Duet3D/Duet3-Mainboard-6HC/(threads)

Thread 2 (2020-11-08):

microSD card socket rotated 180deg in STEP file

boa-pe, 2020-11-08:
microSD card socket is rotated 180deg

T3P3, 2020-11-08:
Updated in latest commit, replaced the step model for the SD card socket used.

Closed 2020-11-08.

Thread 3 (2021-02-15):

Is there duet3 lib for kicad??

zhjc2014, 2021-02-15:
I can't find the duet3 lib, and many component missed when I open the prj in kicad...
