Duet3D/Duet3-Mainboard-6HC/Duet3_Mainboard_6HC_v1.01/Duet3_MB_Schematic_v1.01.pdf

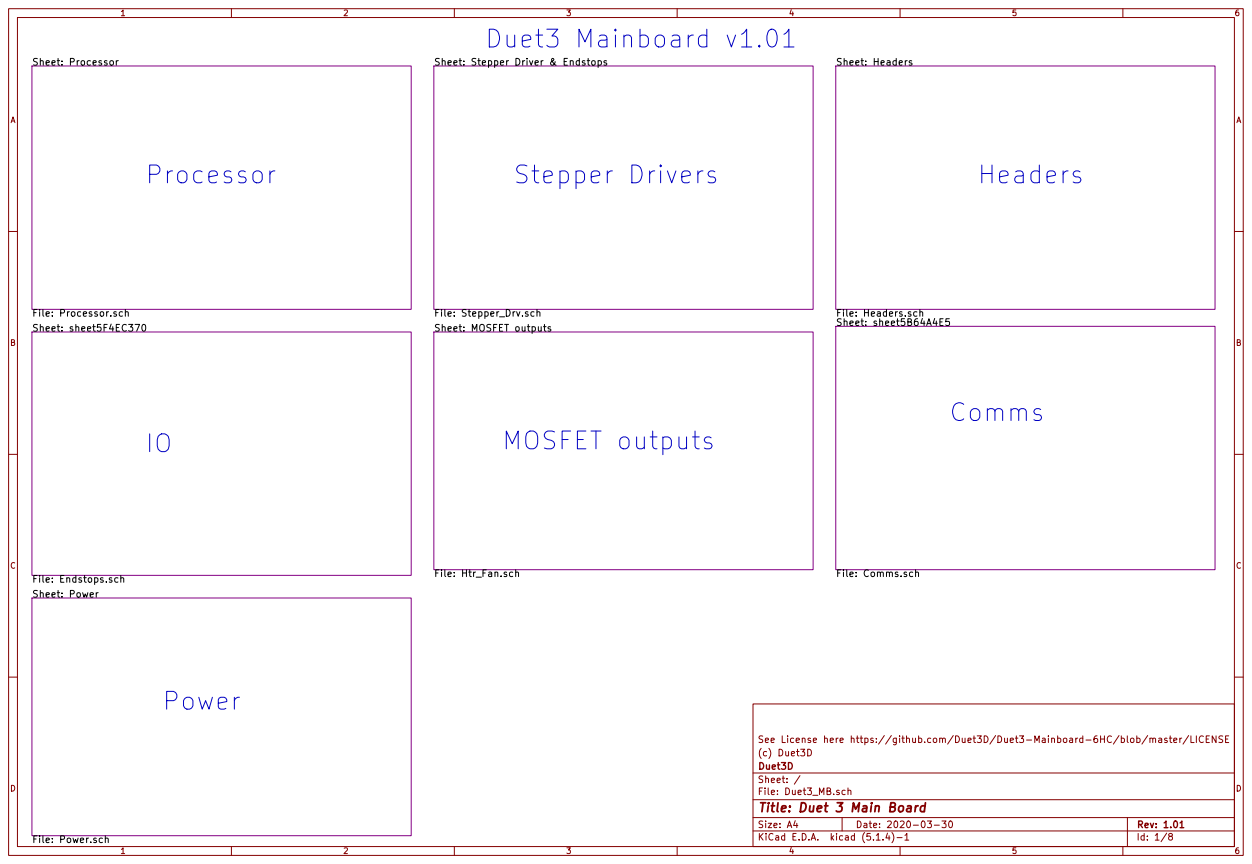
[picture p9: page 1]

Sheet: Headers File: Headers.sch Sheet: Power File: Power.sch

Sheet: Stepper Driver & Endstops

See License here https://github.com/Duet3D/Duet3-Mainboard-6HC/blob/master/LICENSE
(c) Duet3D
File: Duet3_MB.sch Sheet: / Duet3D

Id: 1/8 Title: Duet 3 Main Board

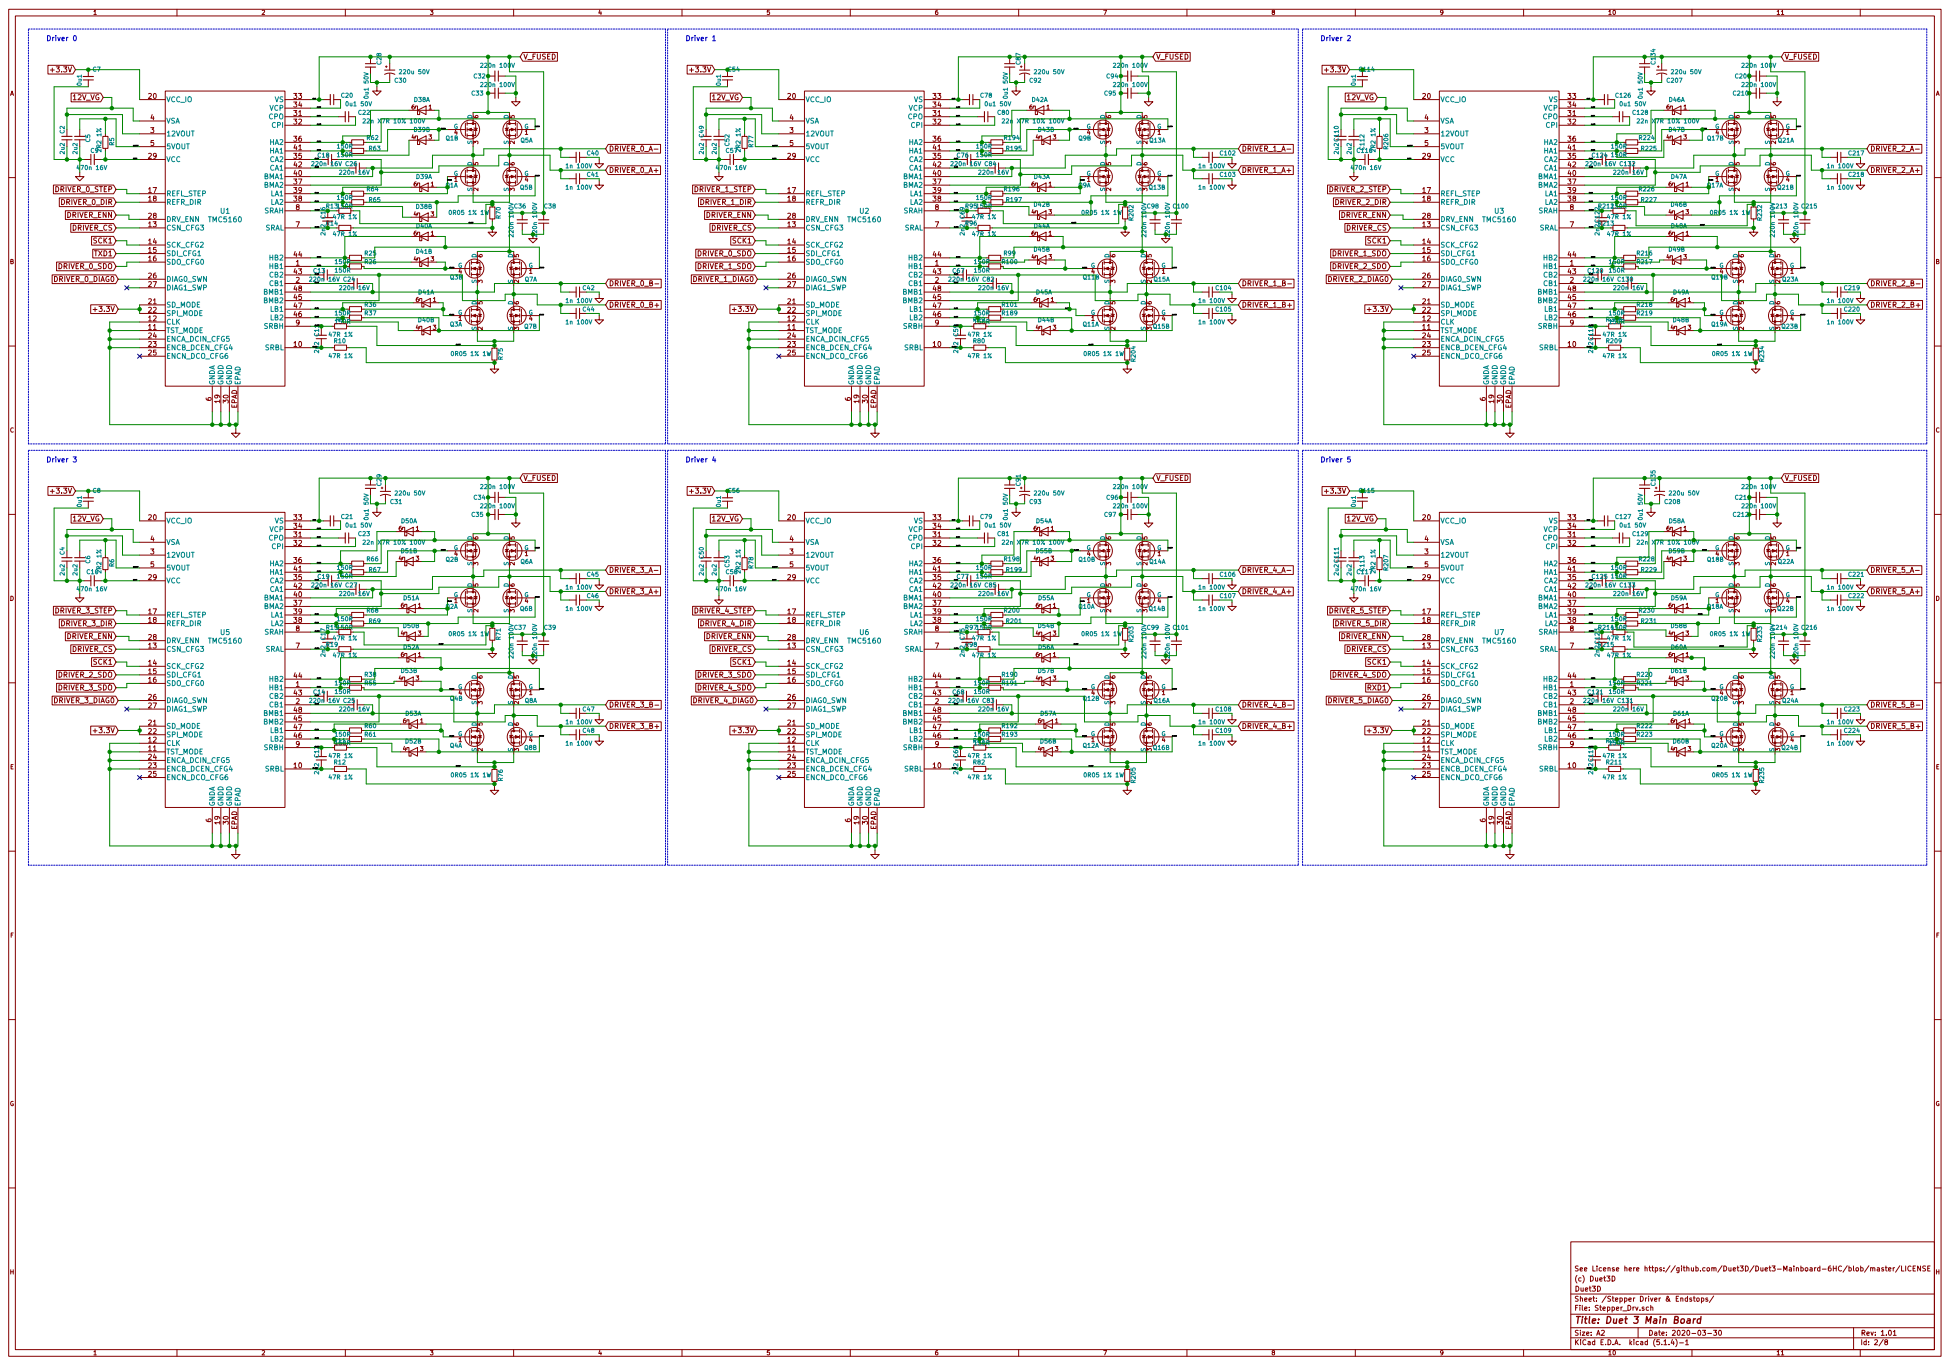
[picture p10: page 2]

6 SRAL 7 SRAH 8 SRBH 9 EPAD EPAD U2 TMC5160 C78

6 SRAL 7 SRAH 8 SRBH 9 EPAD EPAD U1 TMC5160 C5 2u2 C9

5 Q9A HB1 1 SRBL 10 TST_MODE 11 CLK 12 CSN_CFG3 13 SCK_CFG2 14 SDI_CFG1 15 SDO_CFG0 16 REFL_STEP 17 REFR_DIR 18 GNDD 19 CB1 2 VCC_IO 20 SD_MODE 21 SPI_MODE 22 ENCB_DCEN_CFG4 23 ENCA_DCIN_CFG5 24 ENCN_DCO_CFG6 25 DIAG0_SWN 26 DIAG1_SWP 27 DRV_ENN 28 VCC 29

6 SRAL 7 SRAH 8 SRBH 9 EPAD EPAD U6 TMC5160 C53 2u2 C58

6 SRAL 7 SRAH 8 SRBH 9 EPAD EPAD U5 TMC5160

See License here https://github.com/Duet3D/Duet3-Mainboard-6HC/blob/master/LICENSE
(c) Duet3D
Sheet: /Stepper Driver & Endstops/ Duet3D

File: Stepper_Drv.sch
Id: 2/8 Title: Duet 3 Main Board

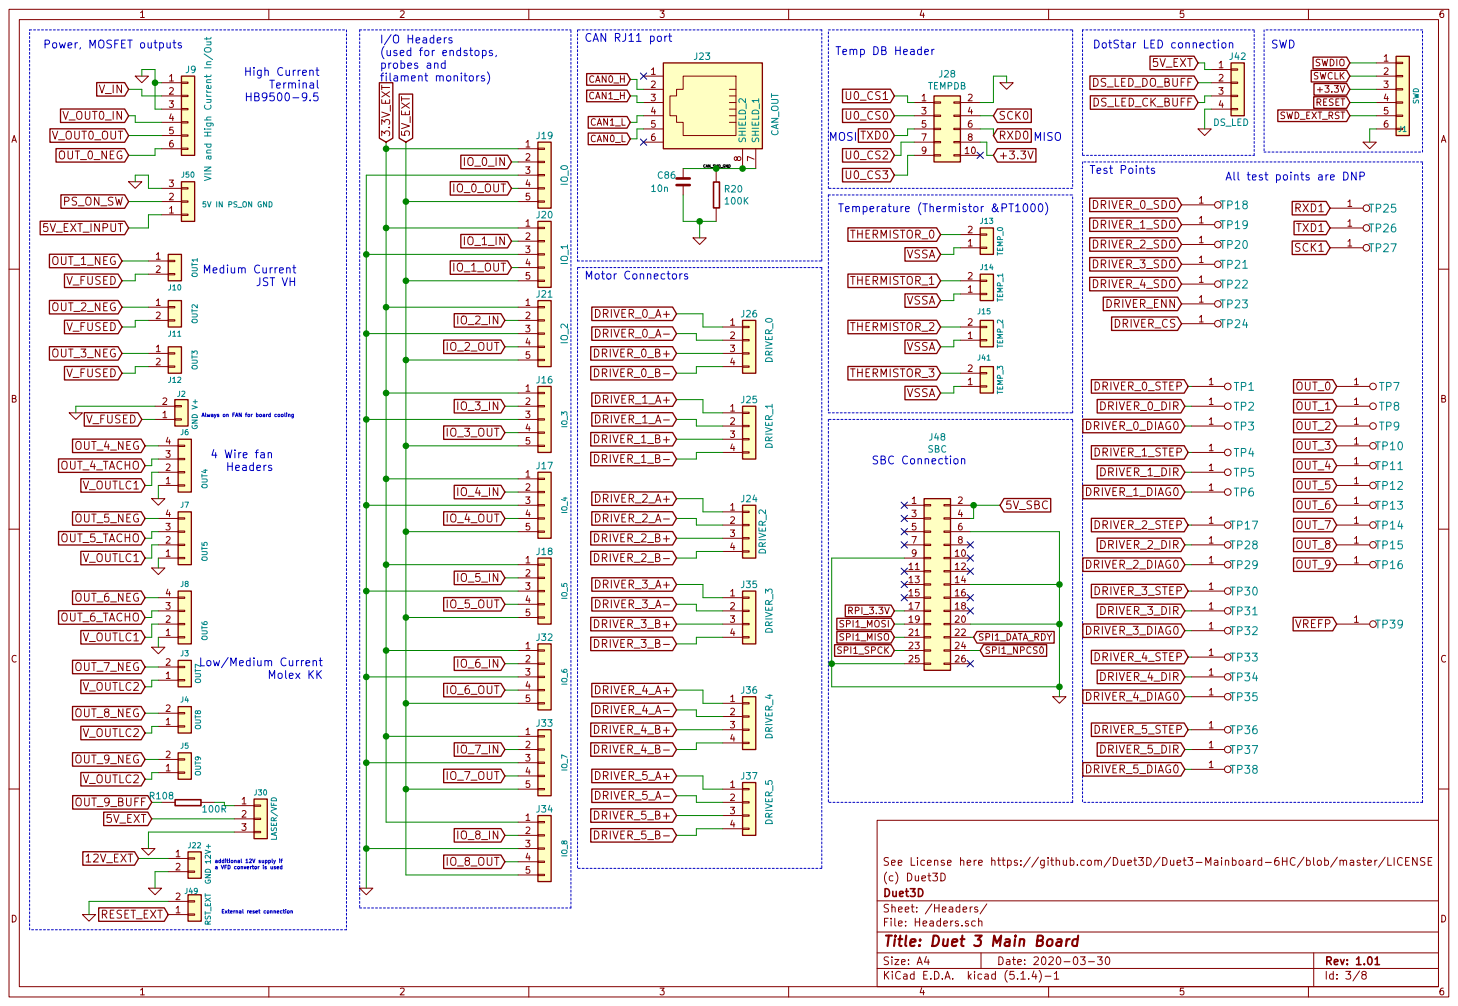
[picture p11: page 3]

Test Points High Current Terminal HB9500-9.5 Power, MOSFET outputs

Temp DB Header 4 Wire fan Headers

Always on FAN for board cooling

additional 12V supply if a VFD convertor is used

See License here https://github.com/Duet3D/Duet3-Mainboard-6HC/blob/master/LICENSE
(c) Duet3D
File: Headers.sch Sheet: /Headers/ Duet3D

Id: 3/8 Title: Duet 3 Main Board

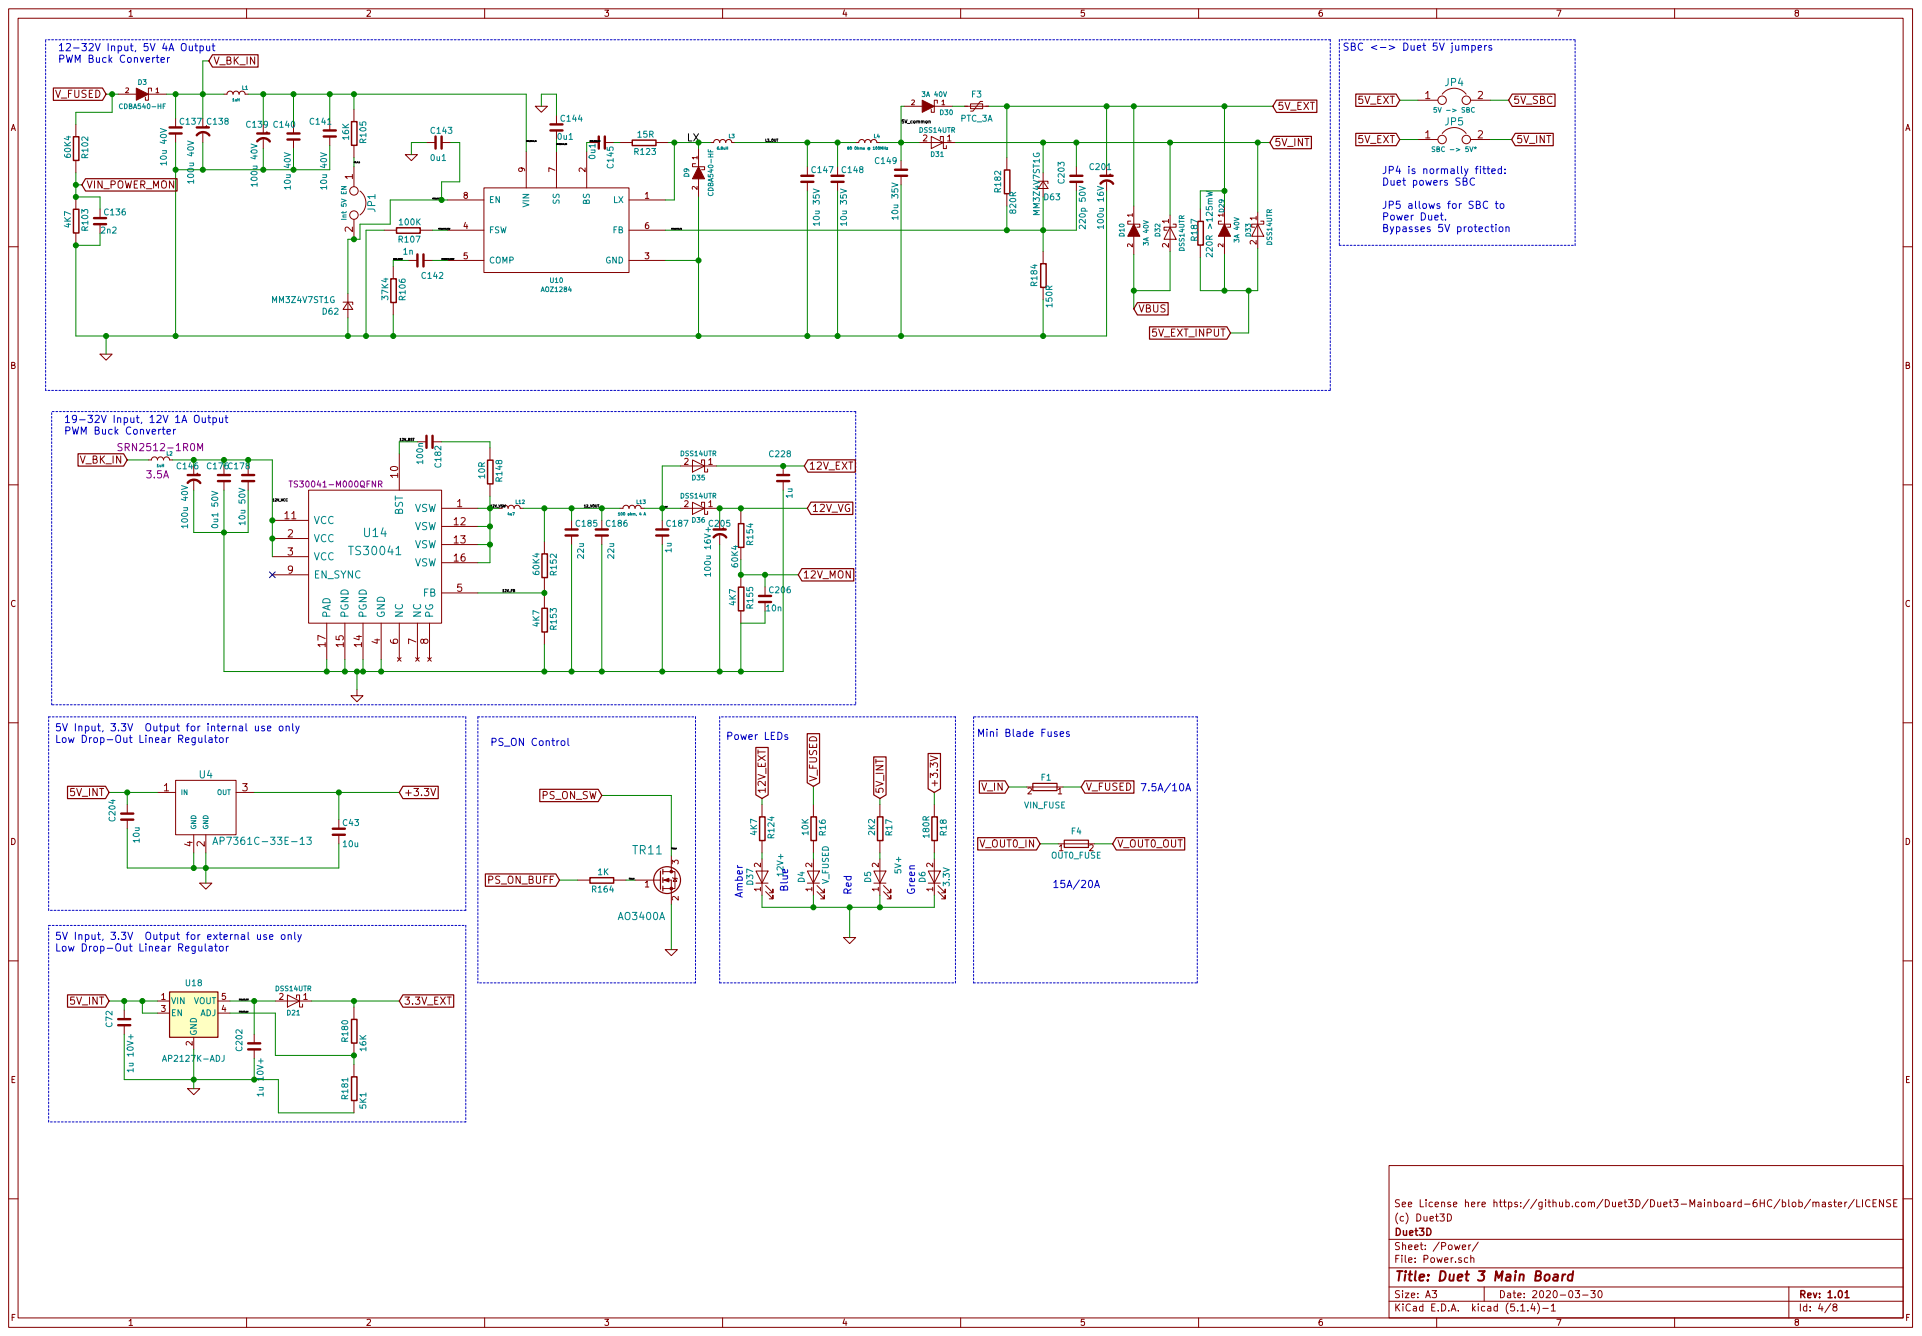
[picture p12: page 4]

2 GND 3 FSW 4 COMP 5 FB 6 SS

JP5 allows for SBC to Power Duet. Bypasses 5V protection

5V Input, 3.3V Output for internal use only

5V Input, 3.3V Output for external use only
Low Drop-Out Linear Regulator

2 EN 3 ADJ 4 VOUT 5 U18 AP2127K-ADJ

See License here https://github.com/Duet3D/Duet3-Mainboard-6HC/blob/master/LICENSE
(c) Duet3D
File: Power.sch Sheet: /Power/ Duet3D

Id: 4/8 Title: Duet 3 Main Board

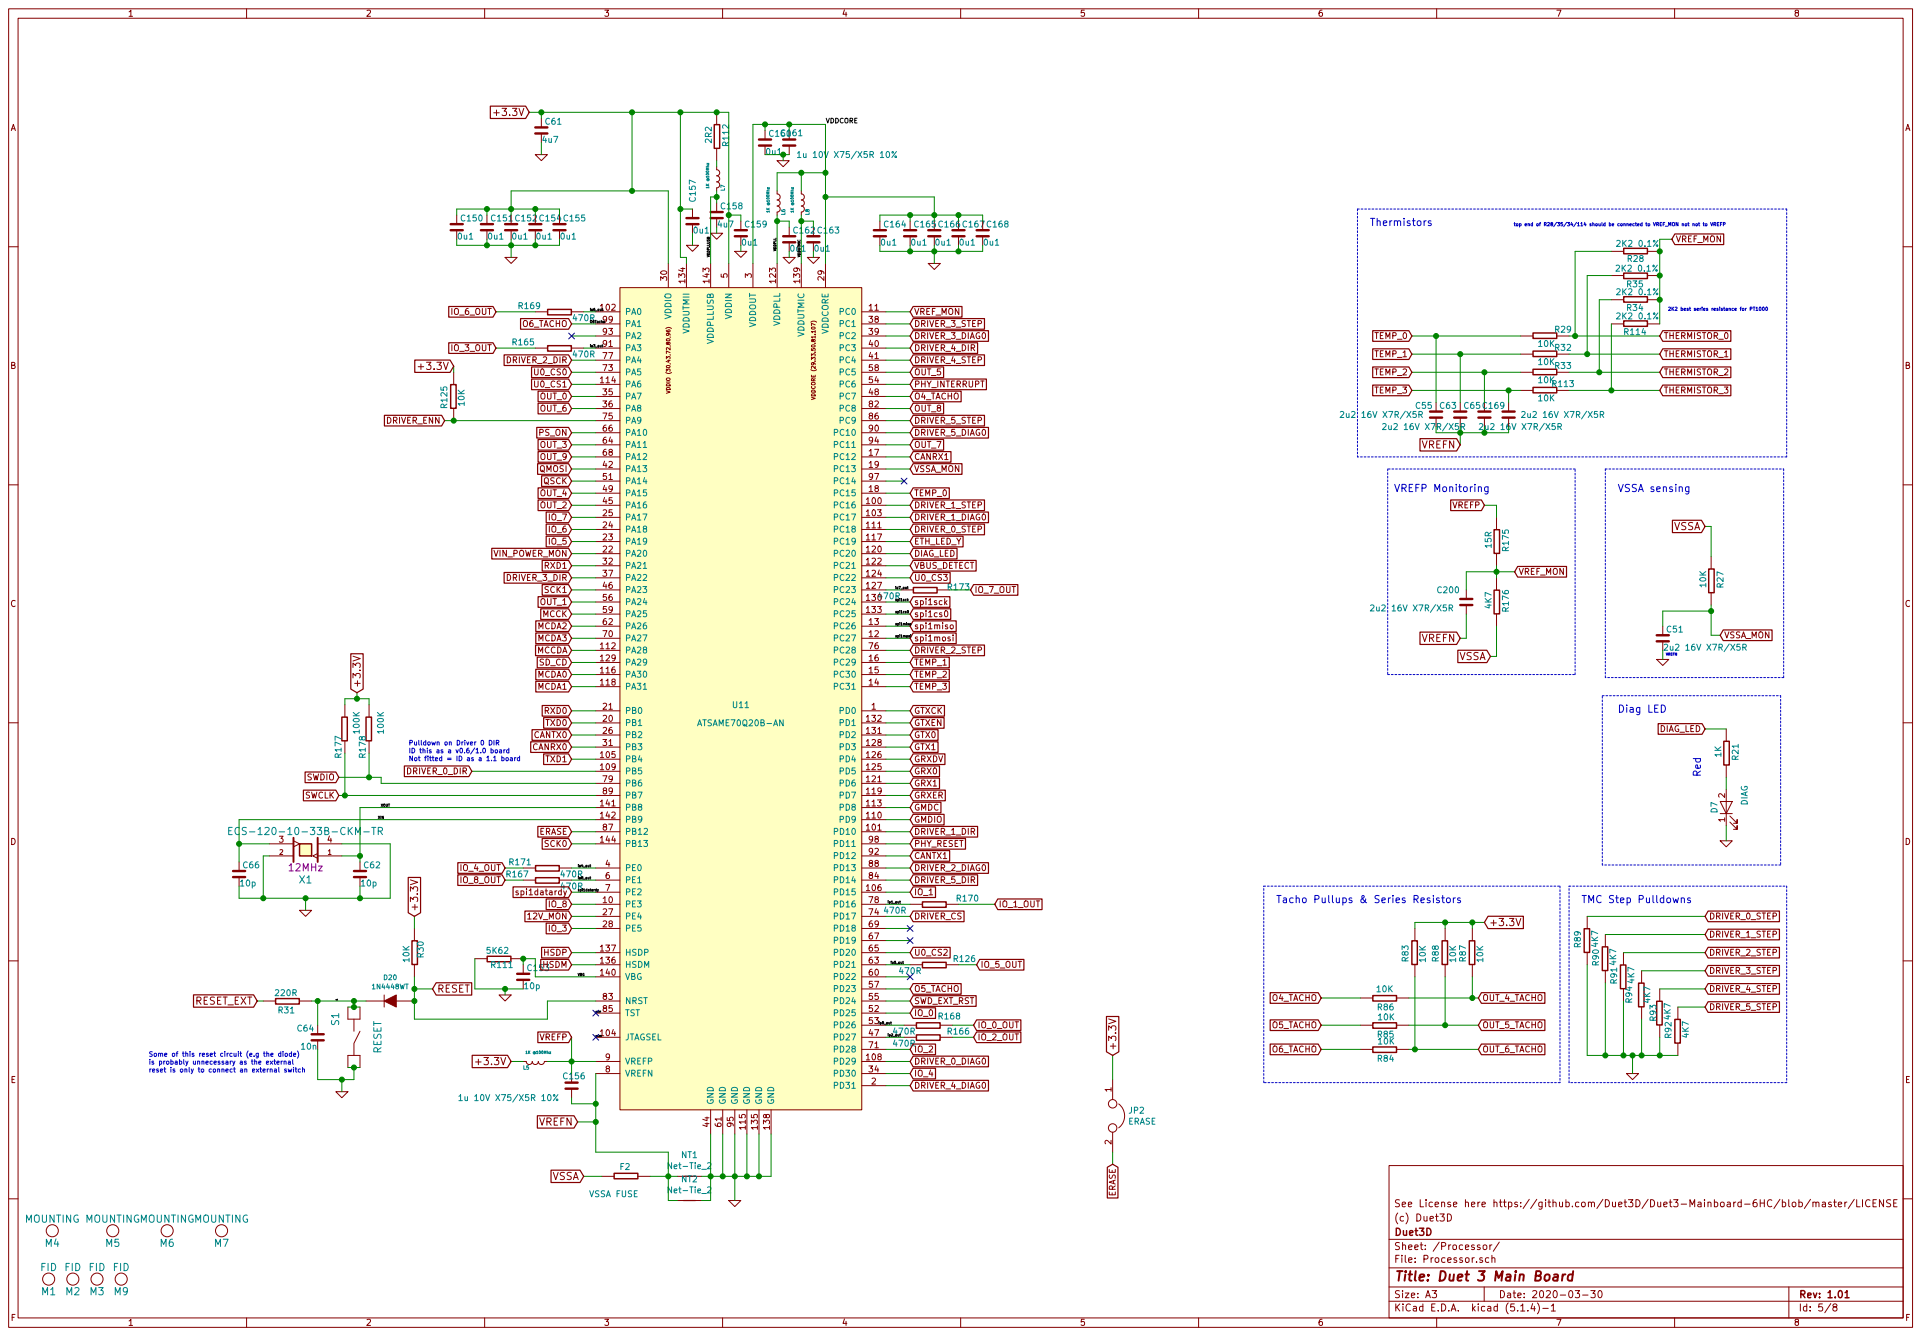
[picture p13: page 5]

2K2 best series resistance for PT1000

See License here https://github.com/Duet3D/Duet3-Mainboard-6HC/blob/master/LICENSE R175 15R

Pulldown on Driver 0 DIR

Tacho Pullups & Series Resistors

Some of this reset circuit (e.g the diode)
is probably unnecessary as the external reset is only to connect an external switch

(c) Duet3D
File: Processor.sch Sheet: /Processor/ Duet3D

Id: 5/8 Title: Duet 3 Main Board

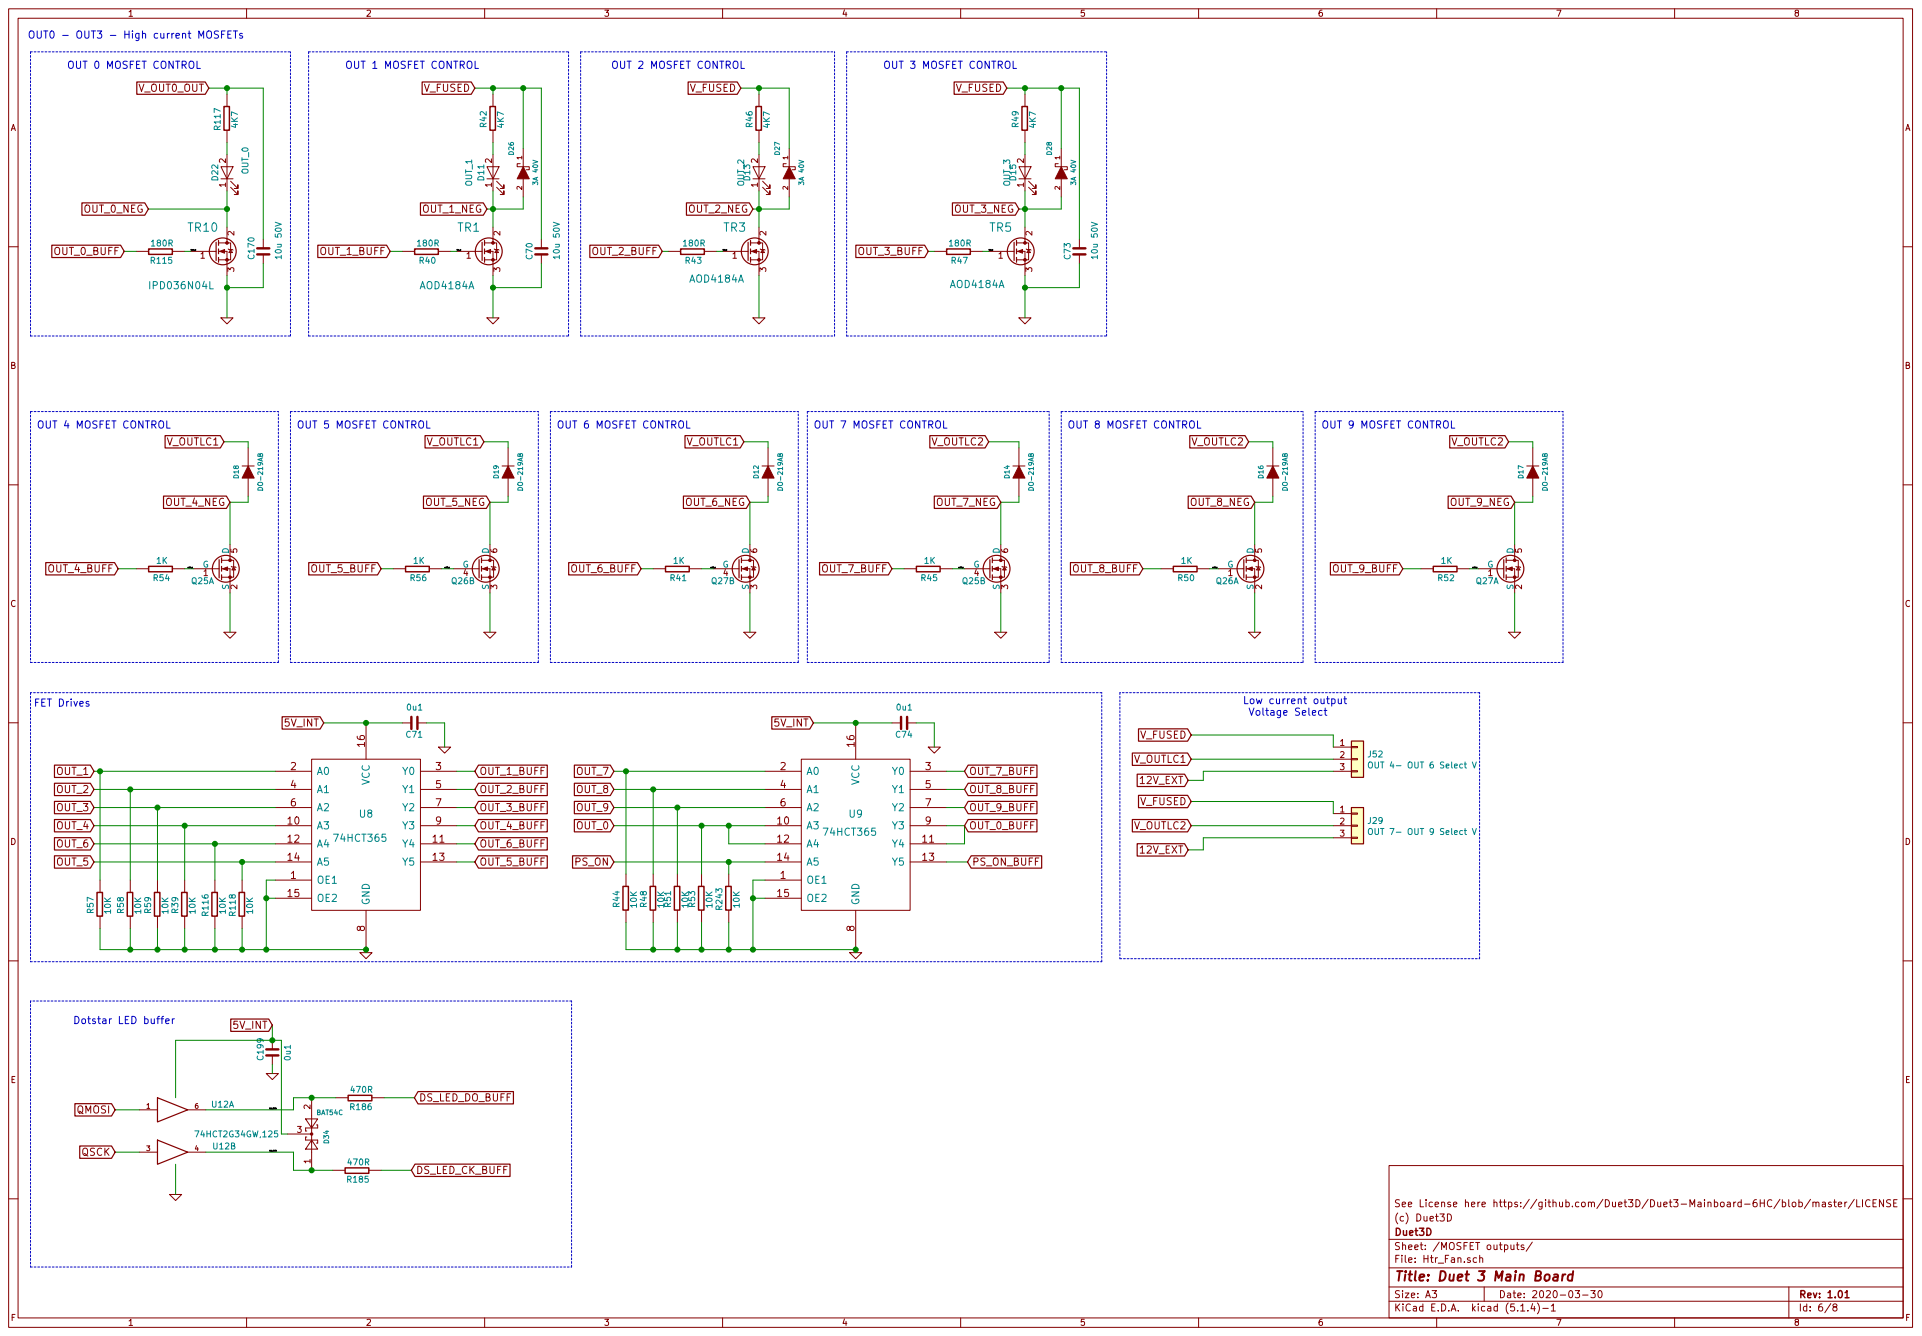
[picture p14: page 6]

File: Htr_Fan.sch
Id: 6/8 Title: Duet 3 Main Board

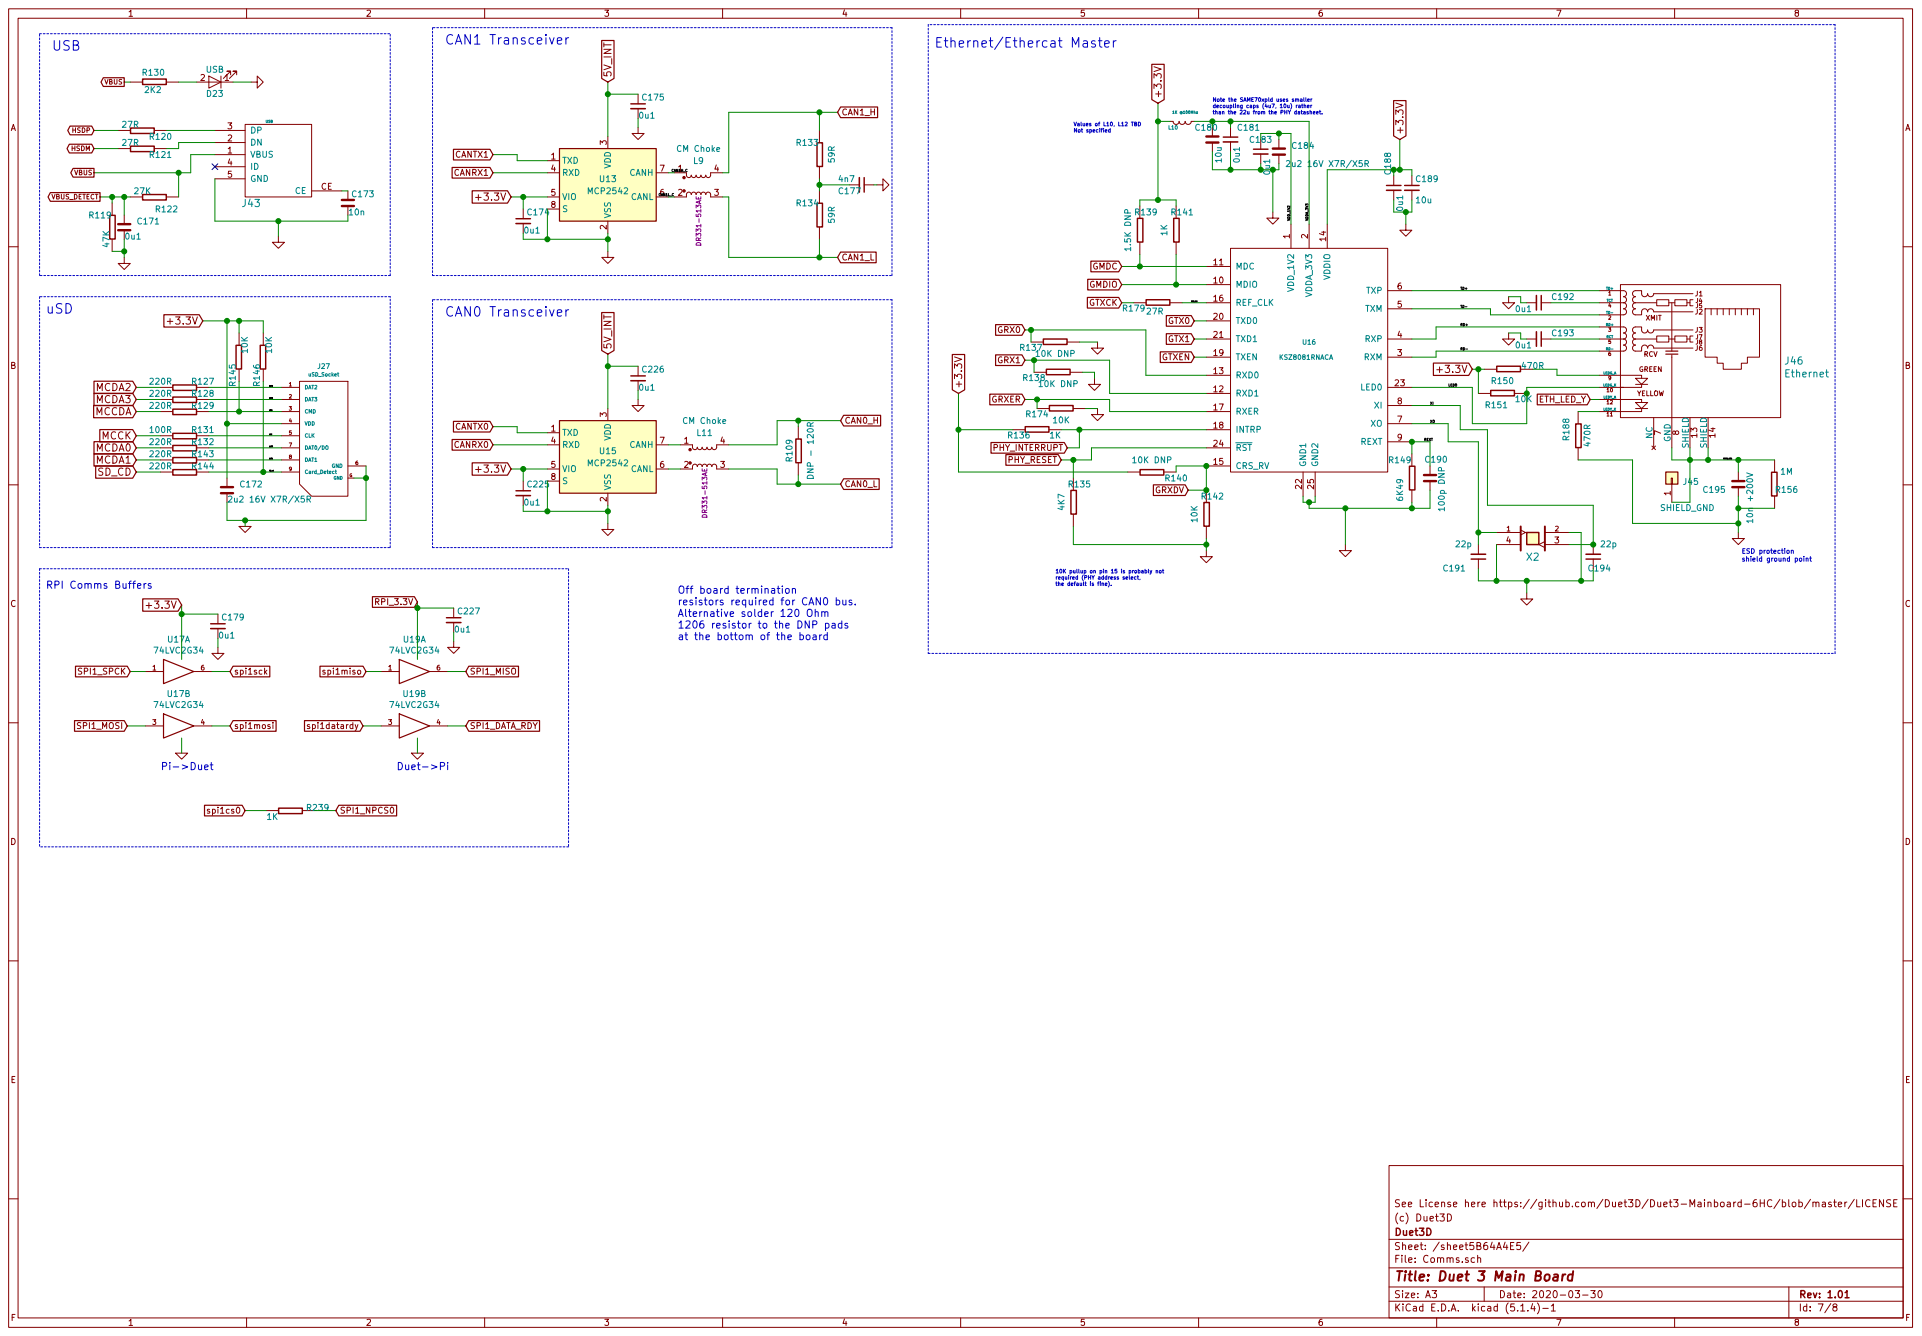
[picture p15: page 7]

CAN1 Transceiver

USB 2 2K2 | 1 D23 USB R121 USB R130

the default is fine). Ethernet/Ethercat Master

than the 22u from the PHY datasheet. Duet->Pi

3 RXD 4 VIO 5 CANL 6 CANH 7 S

1 MDIO 10 MDC 11 RXD1 12 RXD0 13 VDDIO 14 CRS_RV 15 REF_CLK 16 RXER 17

shield ground point uSD

10K pullup on pin 15 is probably not required (PHY address select,

Off board termination
resistors required for CAN0 bus.
Alternative solder 120 Ohm
1206 resistor to the DNP pads at the bottom of the board

See License here https://github.com/Duet3D/Duet3-Mainboard-6HC/blob/master/LICENSE
(c) Duet3D
File: Comms.sch Sheet: /sheet5B64A4E5/ Duet3D

Id: 7/8 Title: Duet 3 Main Board

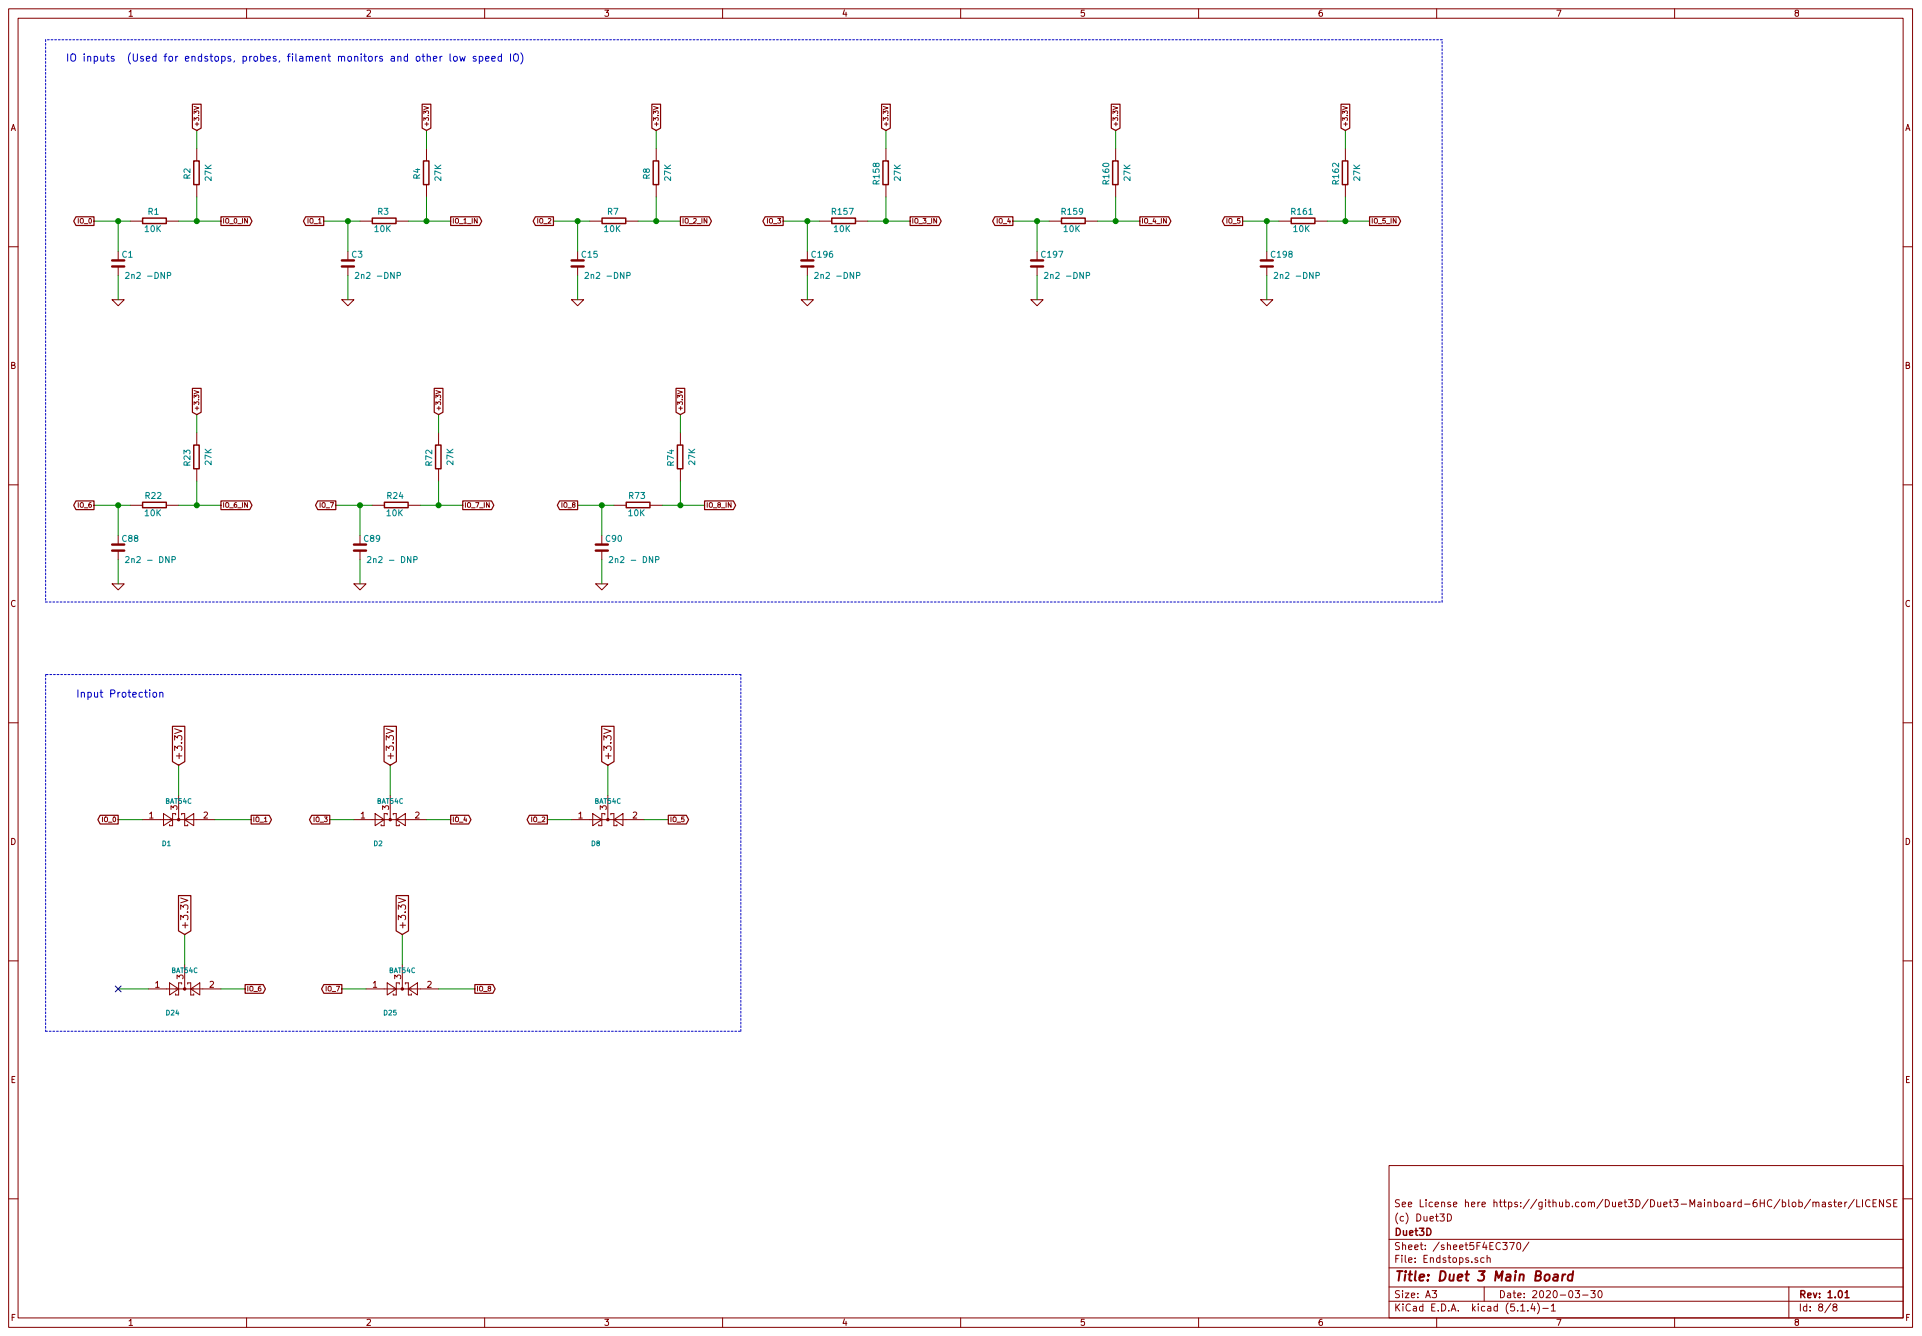
[picture p16: page 8]

IO inputs (Used for endstops, probes, filament monitors and other low speed IO)

See License here https://github.com/Duet3D/Duet3-Mainboard-6HC/blob/master/LICENSE
(c) Duet3D
File: Endstops.sch Sheet: /sheet5F4EC370/ Duet3D

Id: 8/8 Title: Duet 3 Main Board
