Duet3D/Duet3-Mainboard-6HC/Duet3_Mainboard_6HC_v1.02/CAD/Comms.kicad_sch

## KiCad design Duet3_Mainboard_6HC_v1.02/CAD/Comms.kicad_sch (2023-09-28)

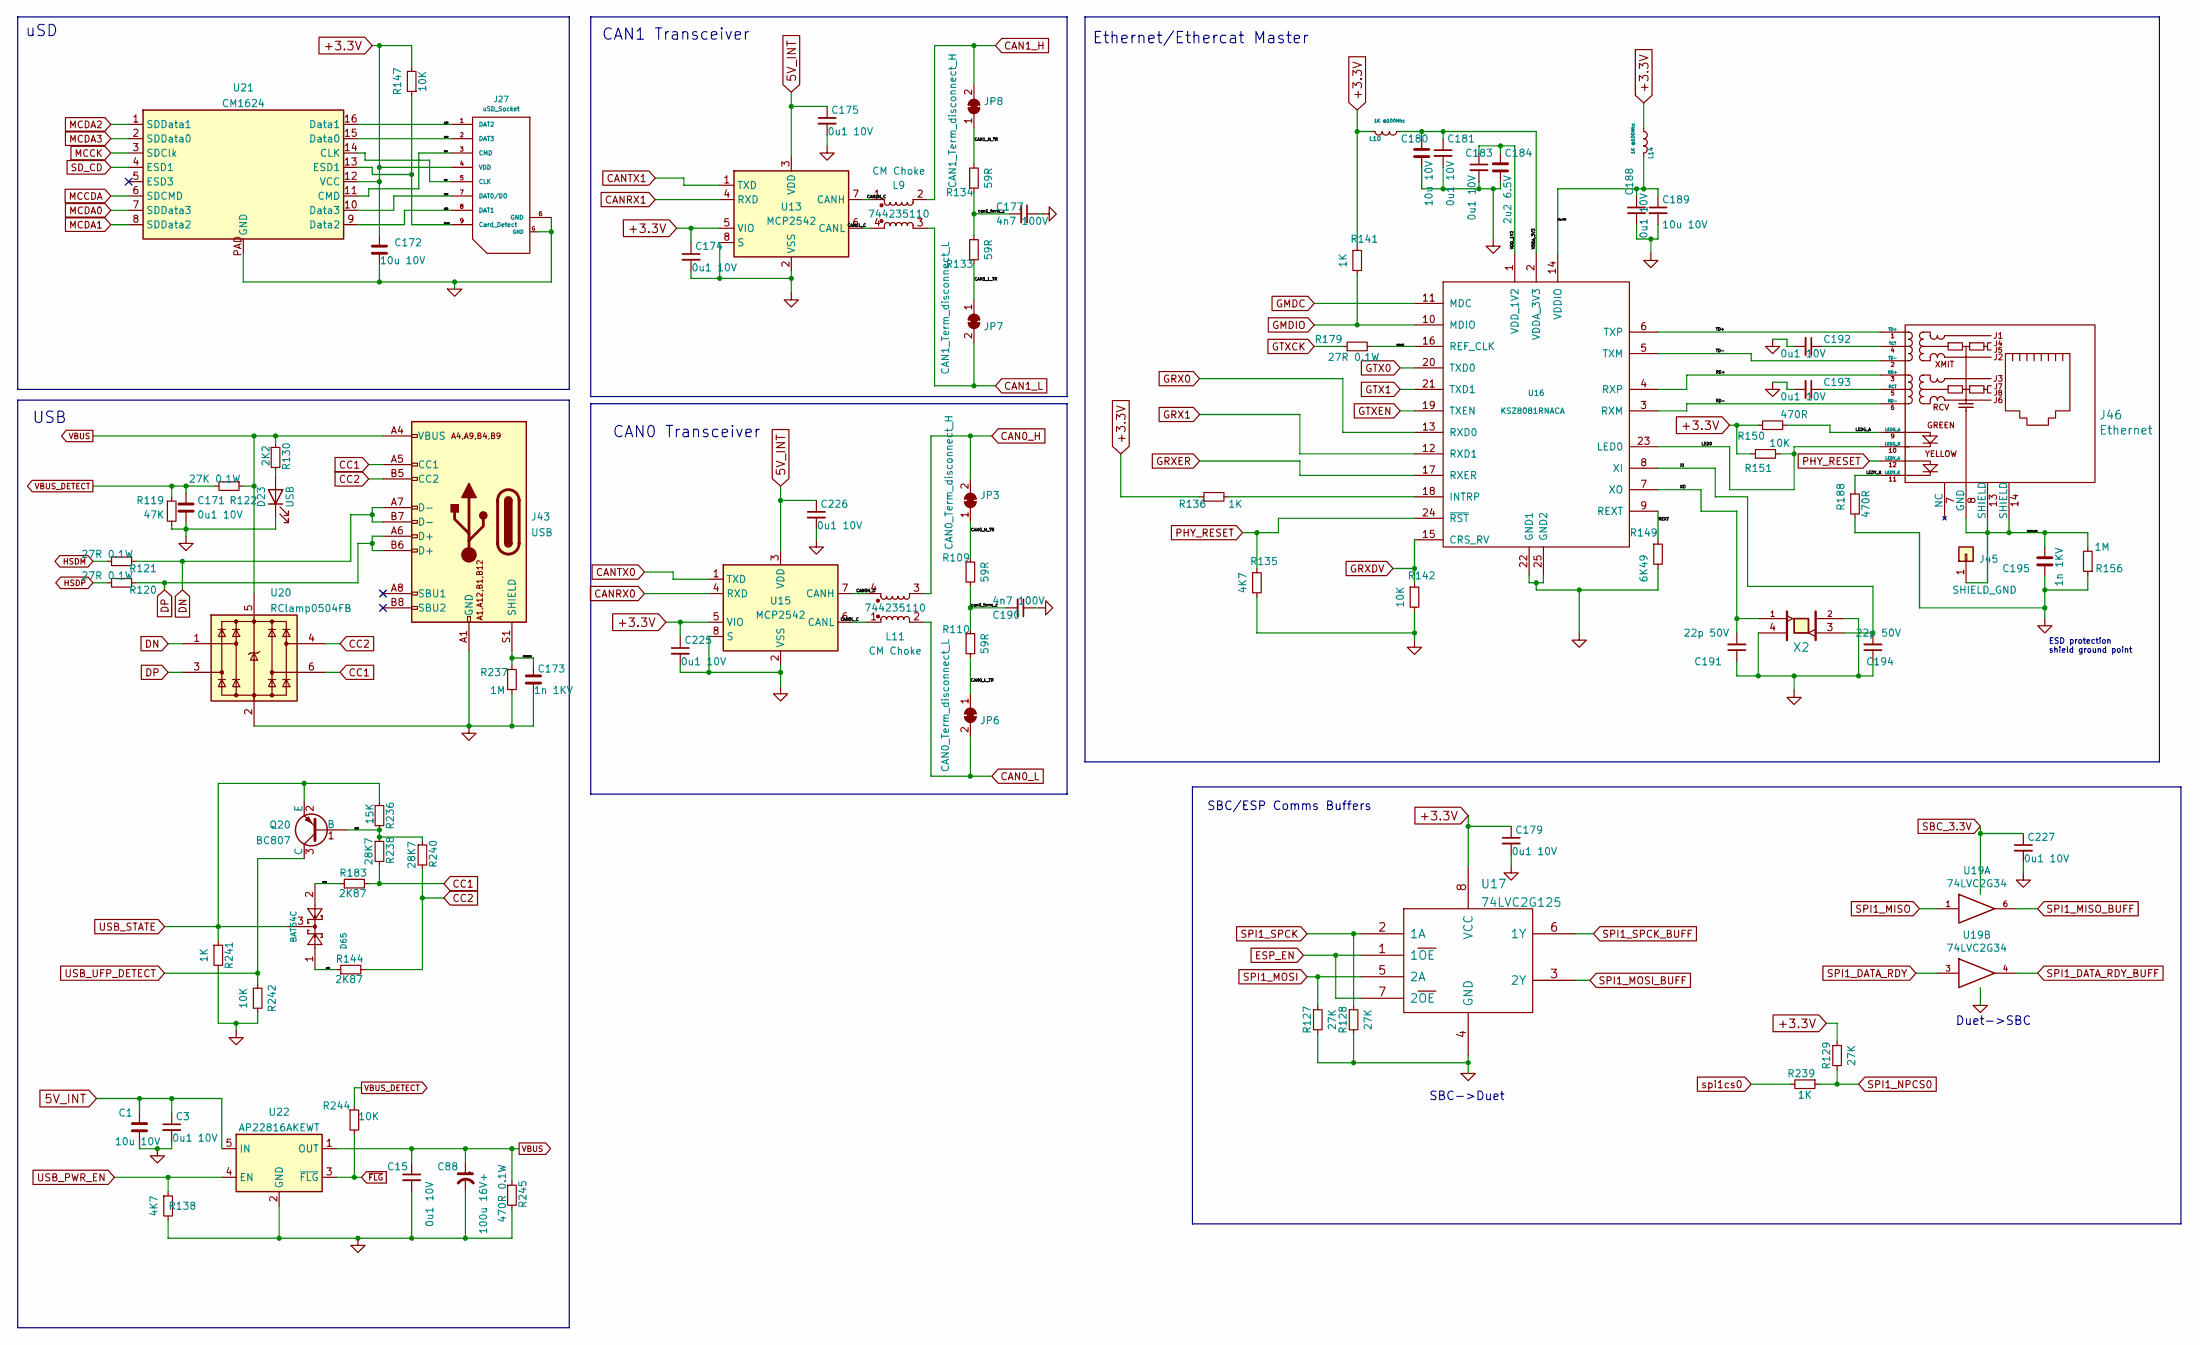
[picture p41: schematic Comms.kicad_sch]

Parts:
C1, C172, C180, C189: 10u 10V; C_0805_2012Metric; Part Number LMK212BJ106KG-T
C3, C15, C171, C174, C175, C179, C181, C183, C188, C192, C193, C225, C226, C227: 0u1 10V; C_0402_1005Metric_Wbry; Part Number CL05A104KP5NNNC
C88: 100u 16V+; CP_Elec_6.3x7.7; Part Number 865080545012 (16V version can be used)
C173, C195: 1n 1KV; C_0805_2012Metric; Part Number CC0805KRX7RCBB102
C177, C190: 4n7 100V; C_0402_1005Metric_Wbry; Part Number GMC10X5R472M100NT
C184: 2u2 6.5V; C_0603_1608Metric_Wbry; Part Number JMK107BJ225KA-T
C191, C194: 22p 50V; C_0402_1005Metric_Wbry; Part Number C0402C220J4GACTU
D23: USB; LED_0603_1608Metric; Part Number 150060RS75000 or equivalent Red
D65: BAT54C; SOT-23; Part Number BAT54CLT1G
J27: uSD_Socket; uSD_SKT; Part Number 693071020811
J43: USB; USB_C_Receptacle_Valcon_CSP-USC16-TR; Part Number CSP-USC16-TR
J45: SHIELD_GND; 2.8mm_Spade_terminal; Part Number PC110D5
J46: Ethernet; RJ45+MAG; Part Number HR911105A
JP3: CAN0_Term_disconnect_H; SJ_Bridged; Part Number Virtual Component - DNP
JP6: CAN0_Term_disconnect_L; SJ_Bridged; Part Number Virtual Component - DNP
JP7: CAN1_Term_disconnect_L; SJ_Bridged; Part Number Virtual Component - DNP
JP8: CAN1_Term_disconnect_H; SJ_Bridged; Part Number Virtual Component - DNP
L9, L11: CM Choke; Wurth_CM_Choke_1812_744235nnn; Part Number 744235110
L10, L14: 1K @100Mhz; L_0603_1608Metric; Part Number 742792662 or BK1608HS102-T, PE-0603FB10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
Q20: BC807; SOT-23; Part Number BC807-25LT1G
R109, R110, R133, R134: 59R; R_0402_1005Metric_Wbry; Part Number RMCF0402FT59R0
R119: 47K; R_0402_1005Metric_Wbry; Part Number RC0402FR-1347KL
R120, R121, R179: 27R 0.1W; R_0402_1005Metric_Wbry; Part Number ERJ-2RKF27R0X
R122: 27K 0.1W; R_0402_1005Metric_Wbry; Part Number ERJ-2RKF2702X
R127, R128, R129: 27K; R_0402_1005Metric_Wbry; Part Number RK73H1ETTP2702F
R130: 2K2; R_0402_1005Metric_Wbry; Part Number RK73H1ETTP2201F
R135, R138: 4K7; R_0402_1005Metric_Wbry; Part Number RK73H1ETTP4701F
R136, R141, R239, R241: 1K; R_0402_1005Metric_Wbry; Part Number RK73H1ETTP1001F
R142, R147, R151, R242, R244: 10K; R_0402_1005Metric_Wbry; Part Number RMCS0402FT10K0
R144, R183: 2K87; R_0402_1005Metric_Wbry; Part Number RMCF0402FT2K87
R149: 6K49; R_0402_1005Metric_Wbry; Part Number RMCF0402FT6K49
R150, R188: 470R; R_0402_1005Metric_Wbry; Part Number ERJ-2RKF4700X
R156, R237: 1M; R_0805_2012Metric; Part Number RMCF0805JT1M00
R236: 15K; R_0402_1005Metric_Wbry; Part Number RMCS0402FT15K0
R238, R240: 28K7; R_0402_1005Metric_Wbry; Part Number RMCF0402FT28K7
R245: 470R 0.1W; R_0402_1005Metric_Wbry; Part Number ERJ-2RKF4700X
U13: MCP2542; SOIC-8_3.9x4.9mm_P1.27mm; Part Number MCP2542FD or WFD
U15: MCP2542; SOIC-8_3.9x4.9mm_P1.27mm; Part Number MCP2542FD-E/SN
U16: KSZ8081RNACA; KSZ8081RNA _QFN-24-1EP_4x4mm_P0.5mm_EP2.6x2.6mm; Part Number KSZ8081RNACA (same as on the v0.6)
U17: 74LVC2G125; X2-DFN2010-8; Part Number 74LVC2G125HD4-7
U19: 74LVC2G34; SOT-363_SC-70-6; Part Number 74LVC2G34GW,125
U20: RClamp0504FB; SC-70-6L; Part Number RClamp0504FB
U21: CM1624; UDFN-16-1EP_1.35x3.3_P0.4_2Oz; Part Number CM1624−08DE
U22: AP22816AKEWT; SOT-23-5; Part Number AP22816AKEWT or AP2151WG-7 if APP22816K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
X2: 25Mhz; Crystal_SMD_ECS-33B-4Pin_3.2x2.5mm; Part Number TSX-3225 25.0000MF10P-C0 (note requires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

Connections:
5V_INT: C1.1, C3.1, C175.1, C226.1, U13.3 (VDD), U15.3 (VDD), U22.5 (IN)
+3.3V: C172.1, C174.1, C179.1, C225.1, J27.4 (VDD), L10.1 (A), L14.2 (B), R129.1, R136.1, R141.1, R147.2, R150.1, R151.1, U13.5 (VIO), U15.5 (VIO), U17.8 (VCC), U21.12 (VCC)
CAN0H_C: L11.4, U15.7 (CANH)
CAN0L_C: L11.1, U15.6 (CANL)
CAN0_H: JP3.2 (B), L11.3
CAN0_H_TR: JP3.1 (A), R109.1
CAN0_L: JP6.2 (B), L11.2
CAN0_L_TR: JP6.1 (A), R110.2
CAN1H_C: L9.1, U13.7 (CANH)
CAN1L_C: L9.4, U13.6 (CANL)
CAN1_H: JP8.2 (B), L9.2
CAN1_H_TR: JP8.1 (A), R134.2
CAN1_L: JP7.2 (B), L9.3
CAN1_L_TR: JP7.1 (A), R133.1
CANRX0: U15.4 (RXD)
CANRX1: U13.4 (RXD)
CANTX0: U15.1 (TXD)
CANTX1: U13.1 (TXD)
CC1: J43.A5 (CC1), R183.2, R238.2, U20.6
CC2: J43.B5 (CC2), R144.2, R240.2, U20.4
CLK: J27.5 (CLK), U21.14 (CLK)
CMD: J27.3 (CMD), U21.11 (CMD)
DAT0: J27.7 (DAT0/DO), U21.10 (Data3)
DAT1: J27.8 (DAT1), U21.9 (Data2)
DAT2: J27.1 (DAT2), U21.16 (Data1)
DAT3: J27.2 (DAT3), U21.15 (Data0)
DN: J43.A7 (D-), J43.B7 (D-), R121.1, U20.1
DP: J43.A6 (D+), J43.B6 (D+), R120.1, U20.3
ESP_EN: U17.1 (1OE), U17.7 (2OE)
GMDC: U16.11 (MDC)
GMDIO: R141.2, U16.10 (MDIO)
GND: C1.2, C3.2, C15.2, C88.2, C171.2, C172.2, C173.2, C174.2, C175.2, C177.1, C179.2, C180.2, C181.2, C183.2, C184.2, C188.2, C189.2, C190.1, C191.1, C192.2, C193.2, C194.1, C195.1, C225.2, C226.2, C227.2, D23.1 (K), J27.6 (GND), J27.G (GND), J43.A1 (GND), J43.A12 (GND), J43.B1 (GND), J43.B12 (GND), R119.2, R127.2, R128.2, R135.2, R138.2, R142.2, R149.2, R156.1, R188.2, R237.2, R241.2, R242.2, R245.2, U13.2 (VSS), U13.8 (S), U15.2 (VSS), U15.8 (S), U16.22 (GND1), U16.25 (GND2), U17.4 (GND), U19.2 (GND), U20.2, U21.PAD (GND), U22.2 (GND), X2.2, X2.4
GRX0: U16.13 (RXD0)
GRX1: U16.12 (RXD1)
GRXDV: R142.1, U16.15 (CRS_RV)
GRXER: U16.17 (RXER)
GTX0: U16.20 (TXD0)
GTX1: U16.21 (TXD1)
GTXCK: R179.1
GTXEN: U16.19 (TXEN)
HSDM: R121.2
HSDP: R120.2
LED0: J46.10 (LEDG_K), R151.2, U16.23 (LED0)
LEDG_A: J46.9 (LEDG_A), R150.2
LEDY_K: J46.11 (LEDY_K), R188.1
MCCDA: U21.6 (SDCMD)
MCCK: U21.3 (SDClk)
MCDA0: U21.7 (SDData3)
MCDA1: U21.8 (SDData2)
MCDA2: U21.1 (SDData1)
MCDA3: U21.2 (SDData0)
unnamed: C192.1, J46.4 (TCT)
unnamed: C193.1, J46.5 (RCT)
unnamed: D23.2 (A), R130.2
unnamed: R136.2, U16.18 (INTRP)
PHY_RESET: J46.12 (LEDY_A), R135.1, U16.24 (~RST)
RD+: J46.3 (RD+), U16.4 (RXP)
RD-: J46.6 (RD-), U16.3 (RXM)
REF_CLK: R179.2, U16.16 (REF_CLK)
REXT: R149.1, U16.9 (REXT)
SBC_3.3V: C227.1, U19.5 (VCC)
SD_CD: J27.9 (Card_Detect), R147.1, U21.4 (ESD1), U21.13 (ESD1)
SHIELD_GND: C195.2, J45.1, J46.8 (GND), J46.13 (SHIELD), J46.14 (SHIELD), R156.2
SPI1_DATA_RDY: U19.3
SPI1_DATA_RDY_BUFF: U19.4
SPI1_MISO: U19.1
SPI1_MISO_BUFF: U19.6
SPI1_MOSI: R127.1, U17.5 (2A)
SPI1_MOSI_BUFF: U17.3 (2Y)
SPI1_NPCS0: R129.2, R239.1
SPI1_SPCK: R128.1, U17.2 (1A)
SPI1_SPCK_BUFF: U17.6 (1Y)
TD+: J46.1 (TD+), U16.6 (TXP)
TD-: J46.2 (TD-), U16.5 (TXM)
USB_PWR_EN: R138.1, U22.4 (EN)
USB_STATE: D65.3, Q20.2 (E), R236.1, R241.1
USB_UFP_DETECT: Q20.3 (C), R242.1
USBshield: C173.1, J43.S1 (SHIELD), R237.1
VBUS: C15.1, C88.1, J43.A4 (VBUS), J43.A9 (VBUS), J43.B4 (VBUS), J43.B9 (VBUS), R122.1, R130.1, R245.1, U20.5, U22.1 (OUT)
VBUS_DETECT: C171.1, R119.1, R122.2, R244.1
VDDA_3V3: C180.1, C181.1, L10.2 (B), U16.2 (VDDA_3V3)
VDD_1V2: C183.1, C184.1, U16.1 (VDD_1V2)
XI: C194.2, U16.8 (XI), X2.3
XO: C191.2, U16.7 (XO), X2.1
can0_term_c: C190.2, R109.2, R110.1
can1_term_c: C177.2, R133.2, R134.1
cc1d: D65.2, R183.1
cc2d: D65.1, R144.1
phy_vddio: C188.1, C189.1, L14.1 (A), U16.14 (VDDIO)
q20b: Q20.1 (B), R236.2, R238.1, R240.1
spi1cs0: R239.2
~FLG: R244.2, U22.3 (~FLG)

Notes on the sheet:
Ethernet/Ethercat Master
ESD protection shield ground point
CAN0 Transceiver
CAN1 Transceiver
Duet->SBC
SBC/ESP Comms Buffers
uSD
USB
SBC->Duet
