Duet3D/Duet3-Mainboard-6HC/Duet3_Mainboard_6HC_v1.02/CAD/Endstops.kicad_sch

## KiCad design Duet3_Mainboard_6HC_v1.02/CAD/Endstops.kicad_sch (2023-09-28)

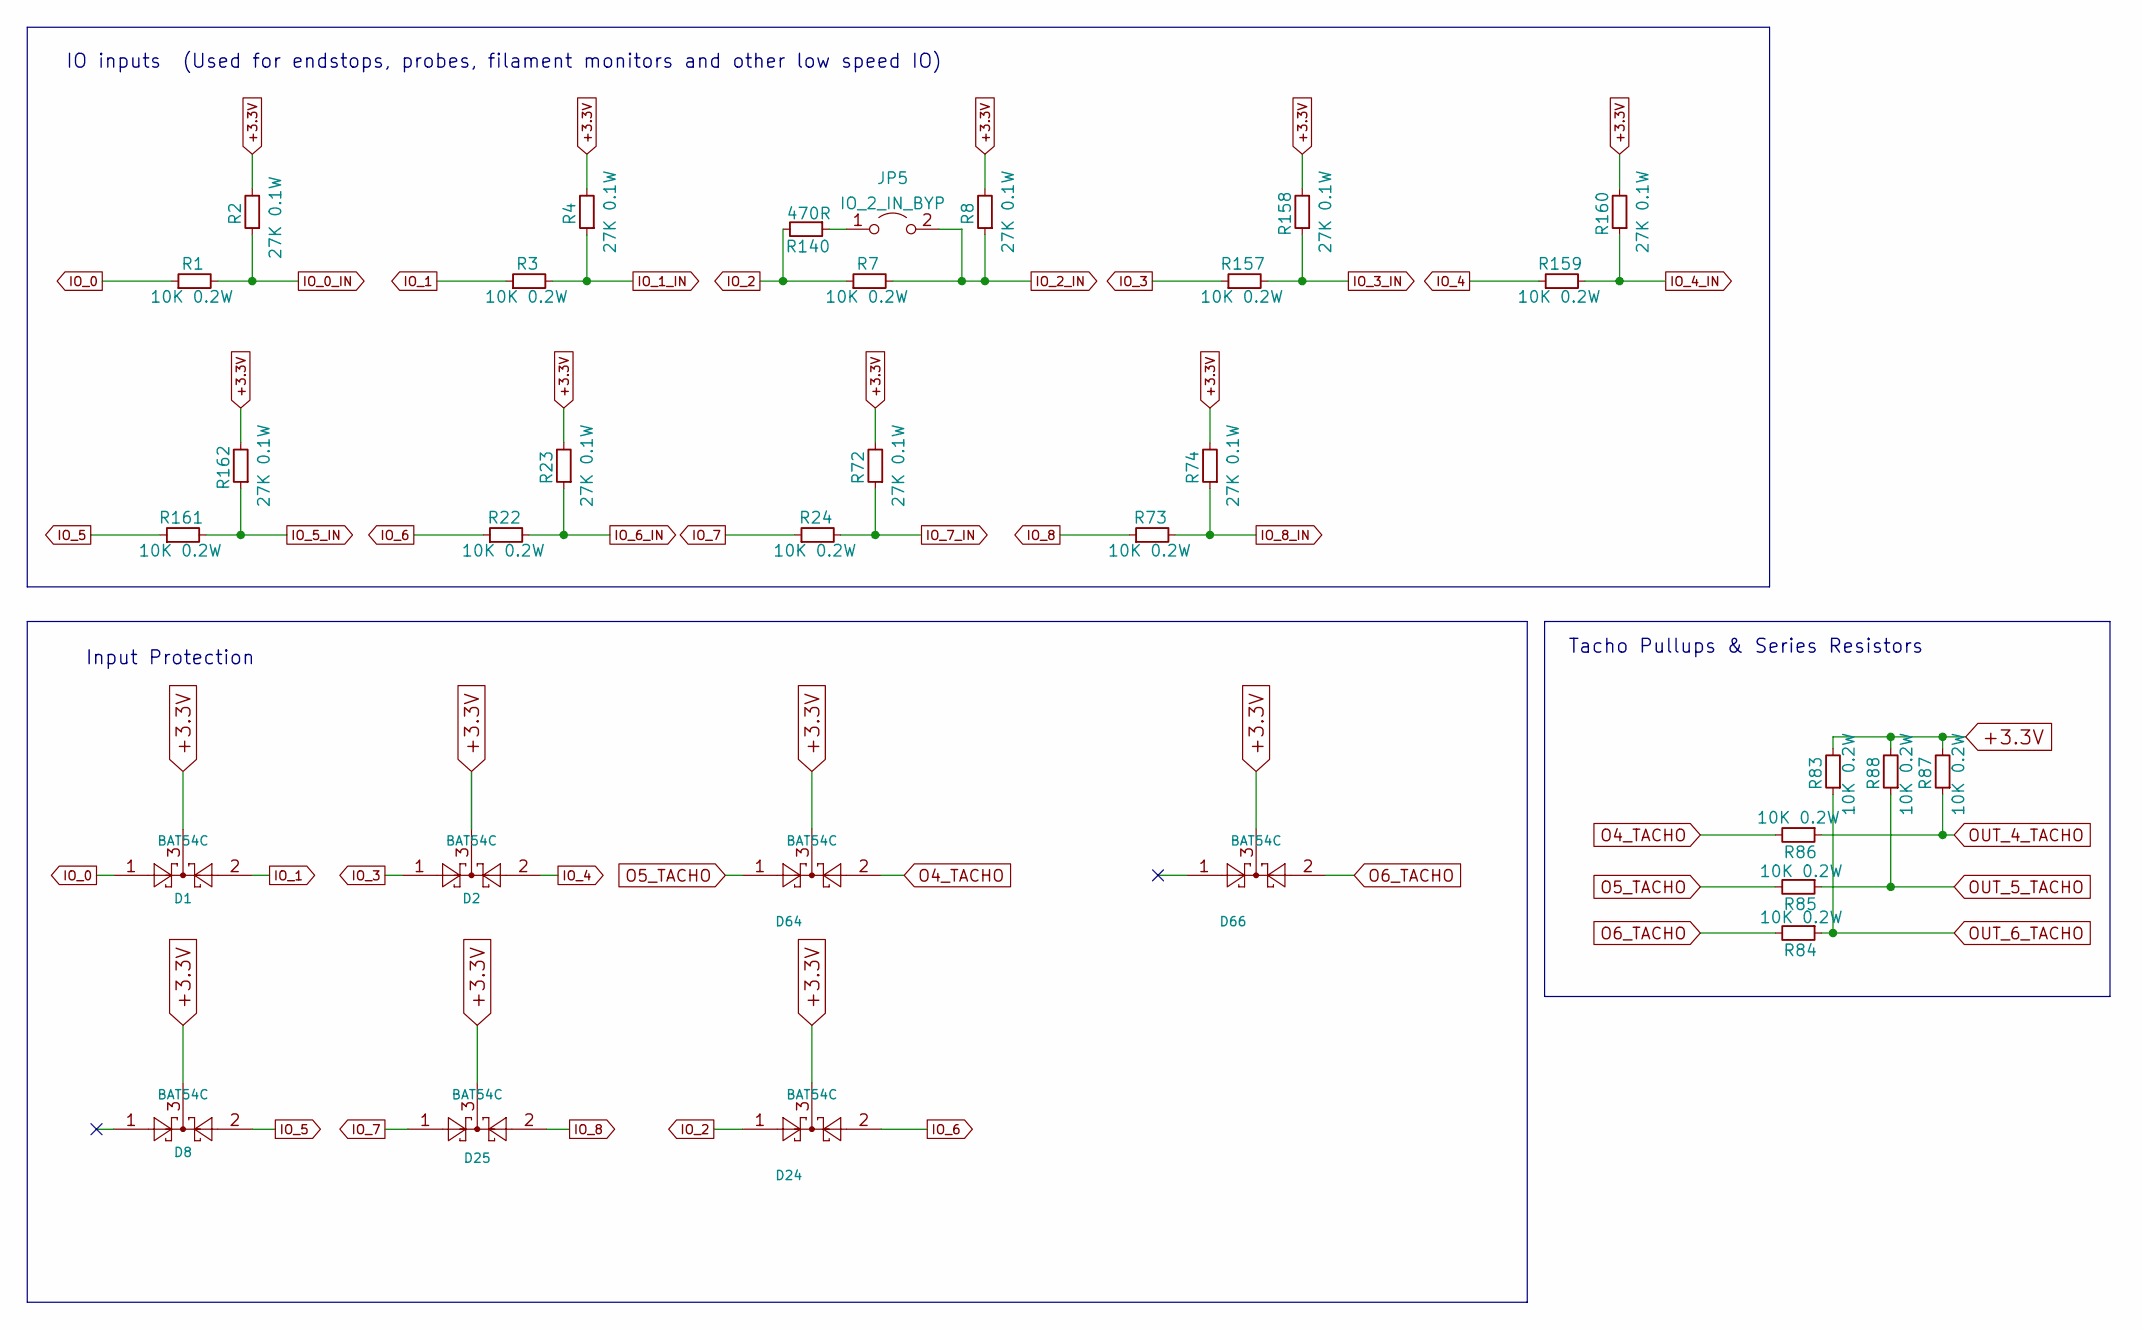
[picture p42: schematic Endstops.kicad_sch]

Parts:
D1, D2, D8, D24, D25, D64, D66: BAT54C; SOT-23; Part Number BAT54CLT1G
JP5: IO_2_IN_BYP; PinHeader_1x02_P2.54mm_Vertical; Part Number THS-02-R - Jumper not fitted
R1, R3, R7, R22, R24, R73, R83, R84, R85, R86, R87, R88, R157, R159, R161: 10K 0.2W; R_0603_1608Metric_Wbry; Part Number ESR03EZPF1002
R2, R4, R8, R23, R72, R74, R158, R160, R162: 27K 0.1W; R_0402_1005Metric_Wbry; Part Number ERJ-2RKF2702X
R140: 470R; R_0402_1005Metric_Wbry; Part Number ERJ-2RKF4700X

Connections:
+3.3V: D1.3, D2.3, D8.3, D24.3, D25.3, D64.3, D66.3, R2.2, R4.2, R8.2, R23.2, R72.2, R74.2, R83.2, R87.2, R88.2, R158.2, R160.2, R162.2
IO_0: D1.1, R1.1
IO_0_IN: R1.2, R2.1
IO_1: D1.2, R3.1
IO_1_IN: R3.2, R4.1
IO_2: D24.1, R7.1, R140.2
IO_2_IN: JP5.2 (B), R7.2, R8.1
IO_3: D2.1, R157.1
IO_3_IN: R157.2, R158.1
IO_4: D2.2, R159.1
IO_4_IN: R159.2, R160.1
IO_5: D8.2, R161.1
IO_5_IN: R161.2, R162.1
IO_6: D24.2, R22.1
IO_6_IN: R22.2, R23.1
IO_7: D25.1, R24.1
IO_7_IN: R24.2, R72.1
IO_8: D25.2, R73.1
IO_8_IN: R73.2, R74.1
unnamed: JP5.1 (A), R140.1
O4_TACHO: D64.2, R86.2
O5_TACHO: D64.1, R85.2
O6_TACHO: D66.2, R84.2
OUT_4_TACHO: R86.1, R87.1
OUT_5_TACHO: R85.1, R88.1
OUT_6_TACHO: R83.1, R84.1

Notes on the sheet:
IO inputs (Used for endstops, probes, filament monitors and other low speed IO)
Input Protection
Tacho Pullups & Series Resistors
