Duet3D/Duet3-Mainboard-6HC/Duet3_Mainboard_6HC_v1.02/CAD/Headers.kicad_sch

## KiCad design Duet3_Mainboard_6HC_v1.02/CAD/Headers.kicad_sch (2023-09-28)

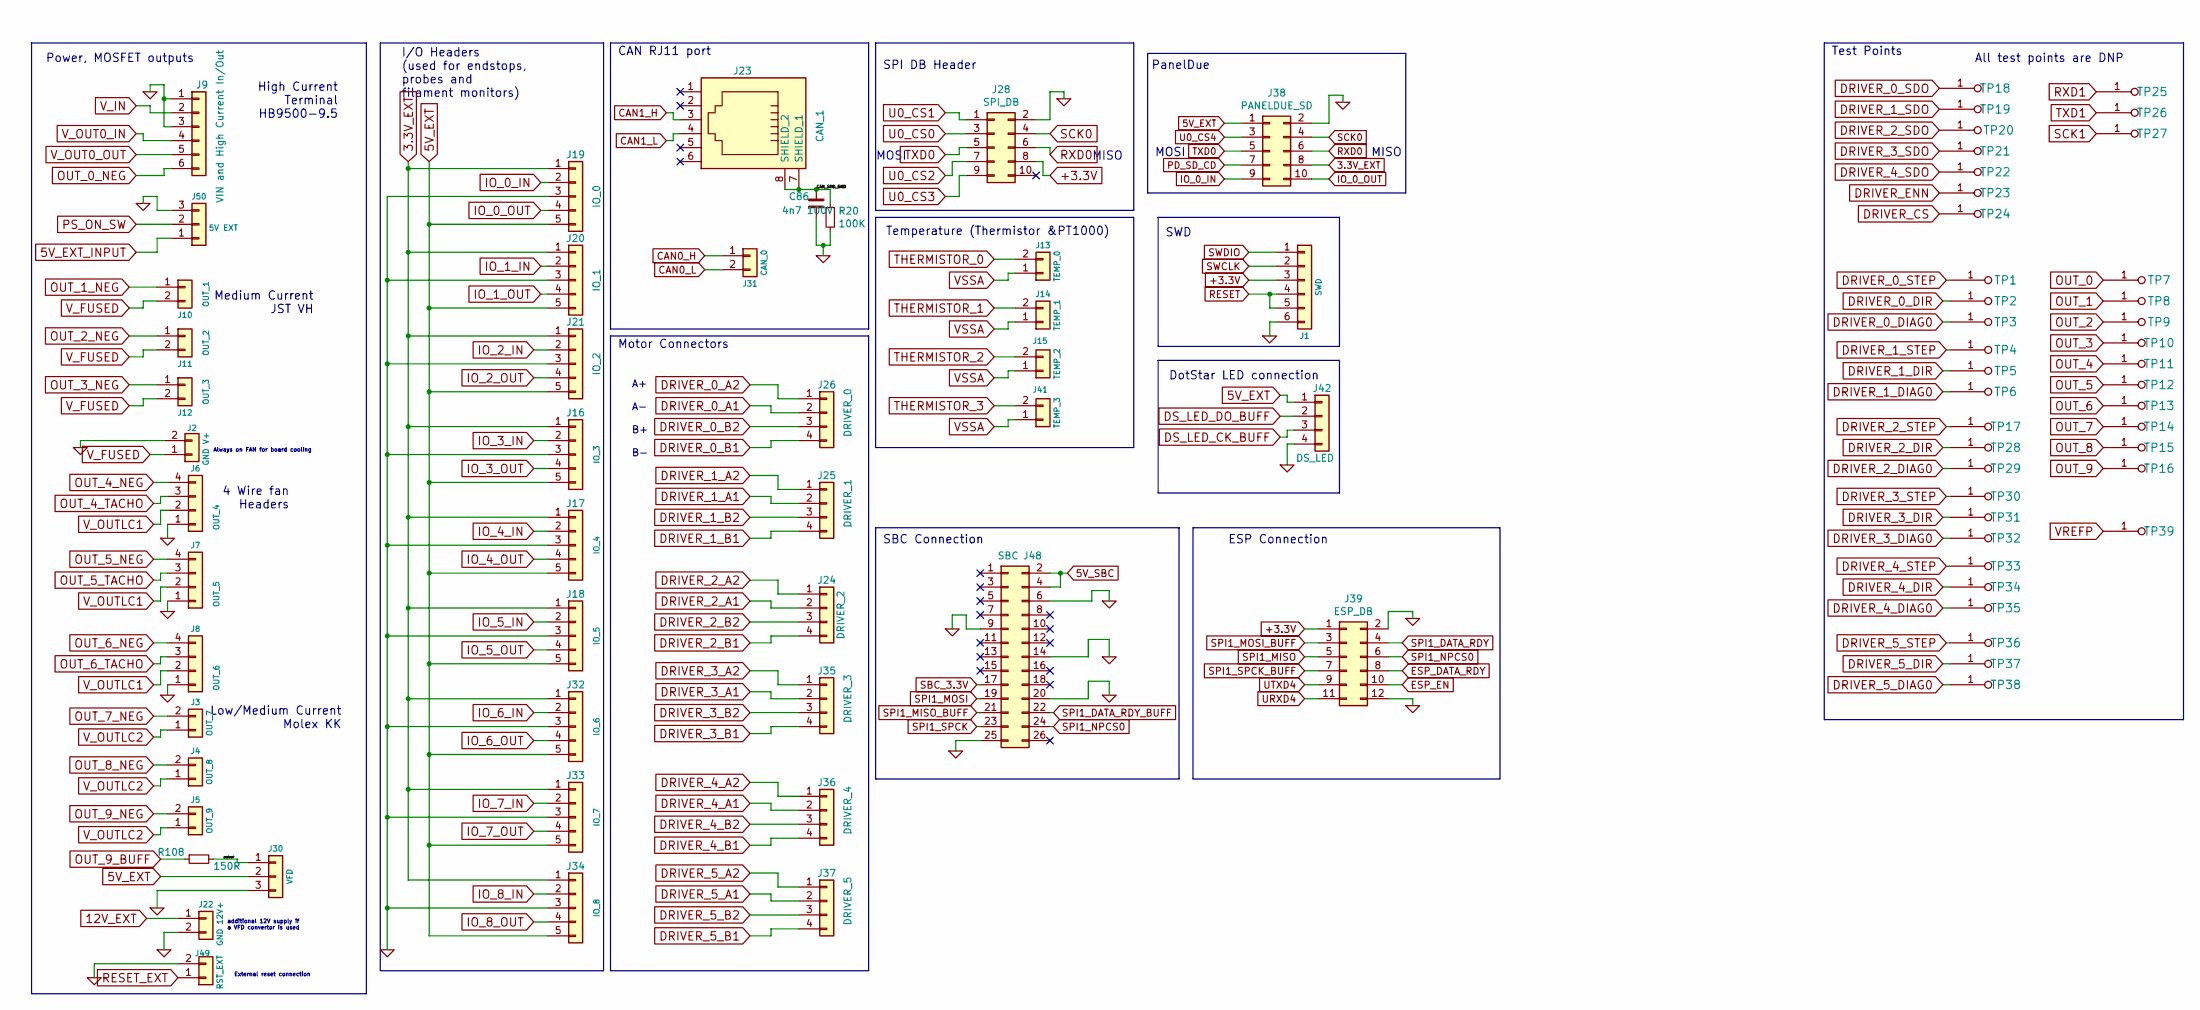
[picture p43: schematic Headers.kicad_sch]

Parts:
C86: 4n7 100V; C_0402_1005Metric_Wbry; Part Number GMC10X5R472M100NT
J1: SWD; JST_ZH_1x06_P1.5_B6B-ZR-SM4-TF; Part Number B6B-ZR(LF)(SN) or 64800611622
J2: GND V+; Wurth_61900211121-1x02_P2.54mm_Vertical-(Molex_KK-254_AE-64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; Part Number 61900211121
J3: OUT_7; Wurth_61900211121-1x02_P2.54mm_Vertical-(Molex_KK-254_AE-64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; Part Number 61900211121
J4: OUT_8; Wurth_61900211121-1x02_P2.54mm_Vertical-(Molex_KK-254_AE-64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; Part Number 61900211121
J5: OUT_9; Wurth_61900211121-1x02_P2.54mm_Vertical-(Molex_KK-254_AE-64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; Part Number 61900211121
J6: OUT_4; FanPinHeader_1x04_P2.54mm_Vertical; Part Number 470533000
J7: OUT_5; FanPinHeader_1x04_P2.54mm_Vertical; Part Number 470533000
J8: OUT_6; FanPinHeader_1x04_P2.54mm_Vertical; Part Number 470533000
J9: VIN and High Current In/Out; screwt-barrier-9.5mm-1x6; Part Number HB950-9.50-6P
J10: OUT_1; JST_VH_B2P-VH-B_1x02_P3.96mm_Vertical; Part Number VH396-02-S010
J11: OUT_2; JST_VH_B2P-VH-B_1x02_P3.96mm_Vertical; Part Number VH396-02-S010
J12: OUT_3; JST_VH_B2P-VH-B_1x02_P3.96mm_Vertical; Part Number VH396-02-S010
J13: TEMP_0; Wurth_61900211121-1x02_P2.54mm_Vertical-(Molex_KK-254_AE-64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; Part Number 61900211121
J14: TEMP_1; Wurth_61900211121-1x02_P2.54mm_Vertical-(Molex_KK-254_AE-64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; Part Number 61900211121
J15: TEMP_2; Wurth_61900211121-1x02_P2.54mm_Vertical-(Molex_KK-254_AE-64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; Part Number 61900211121
J16: IO_3; Wurth_61900511121-1x05_P2.54mm_Vertical(Molex_KK-254_AE-641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; Part Number 61900511121
J17: IO_4; Wurth_61900511121-1x05_P2.54mm_Vertical(Molex_KK-254_AE-641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; Part Number 61900511121
J18: IO_5; Wurth_61900511121-1x05_P2.54mm_Vertical(Molex_KK-254_AE-641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; Part Number 61900511121
J19: IO_0; Wurth_61900511121-1x05_P2.54mm_Vertical(Molex_KK-254_AE-641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; Part Number 61900511121
J20: IO_1; Wurth_61900511121-1x05_P2.54mm_Vertical(Molex_KK-254_AE-641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; Part Number 61900511121
J21: IO_2; Wurth_61900511121-1x05_P2.54mm_Vertical(Molex_KK-254_AE-641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; Part Number 61900511121
J22: GND 12V+; Wurth_61900211121-1x02_P2.54mm_Vertical-(Molex_KK-254_AE-64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; Part Number 61900211121
J23: CAN_1; RJ11_6P6C_half_shield; Part Number 615006143421
J24: DRIVER_2; JST_VH_B4P-VH_1x04_P3.96mm_Vertical; Part Number VH396-04-S010
J25: DRIVER_1; JST_VH_B4P-VH_1x04_P3.96mm_Vertical; Part Number VH396-04-S010
J26: DRIVER_0; JST_VH_B4P-VH_1x04_P3.96mm_Vertical; Part Number VH396-04-S010
J28: SPI_DB; MAX_TEMP_DB; Part Number THD-05-R
J30: VFD; Wurth_61900311121-1x03_P2.54mm_Vertical(Molex_KK-254_AE-641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; Part Number 61900311121
J31: CAN_0; Wurth_61900211121-1x02_P2.54mm_Vertical-(Molex_KK-254_AE-64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; Part Number 61900211121
J32: IO_6; Wurth_61900511121-1x05_P2.54mm_Vertical(Molex_KK-254_AE-641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; Part Number 61900511121
J33: IO_7; Wurth_61900511121-1x05_P2.54mm_Vertical(Molex_KK-254_AE-641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; Part Number 61900511121
J34: IO_8; Wurth_61900511121-1x05_P2.54mm_Vertical(Molex_KK-254_AE-641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; Part Number 61900511121
J35: DRIVER_3; JST_VH_B4P-VH_1x04_P3.96mm_Vertical; Part Number VH396-04-S010
J36: DRIVER_4; JST_VH_B4P-VH_1x04_P3.96mm_Vertical; Part Number VH396-04-S010
J37: DRIVER_5; JST_VH_B4P-VH_1x04_P3.96mm_Vertical; Part Number VH396-04-S010
J38: PANELDUE_SD; IDC-Header_2x05_P2.54mm_Vertical; Part Number 61201021621
J39: ESP_DB; PinHeader_2x06_P2.54mm_Vertical; Part Number THD-06-R
J41: TEMP_3; Wurth_61900211121-1x02_P2.54mm_Vertical-(Molex_KK-254_AE-64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; Part Number 61900211121
J42: DS_LED; Wurth_61900411121-1x04_P2.54mm_Vertical(Molex_KK-254_AE-641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; Part Number 61900411121
J48: SBC; IDC-Header_2x13_P2.54mm_Vertical; Part Number 61202621621
J49: RST_EXT; Wurth_61900211121-1x02_P2.54mm_Vertical-(Molex_KK-254_AE-64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; Part Number 61900211121
J50: 5V EXT; Wurth_61900311121-1x03_P2.54mm_Vertical(Molex_KK-254_AE-641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; Part Number 61900311121
R20: 100K; R_0402_1005Metric_Wbry; Part Number RMCF0402FT100K
R108: 150R; R_0402_1005Metric_Wbry; Part Number RMCF0402FT150R
TP1: D0_STEP; TestPoint_Pad_D1.5mm; Part Number Virtual Component DNP
TP2: D0_DIR; TestPoint_Pad_D1.5mm; Part Number Virtual Component DNP
TP3: D0_DIAG0; TestPoint_Pad_D1.5mm; Part Number Virtual Component DNP
TP4: D1_STEP; TestPoint_Pad_D1.5mm; Part Number Virtual Component DNP
TP5: D1_DIR; TestPoint_Pad_D1.5mm; Part Number Virtual Component DNP
TP6: D1_DIAG0; TestPoint_Pad_D1.5mm; Part Number Virtual Component DNP
TP7: OUT_0; TestPoint_Pad_D1.5mm; Part Number Virtual Component DNP
TP8: OUT_1; TestPoint_Pad_D1.5mm; Part Number Virtual Component DNP
TP9: OUT_2; TestPoint_Pad_D1.5mm; Part Number Virtual Component DNP
TP10: OUT_3; TestPoint_Pad_D1.5mm; Part Number Virtual Component DNP
TP11: OUT_4; TestPoint_Pad_D1.5mm; Part Number Virtual Component DNP
TP12: OUT_5; TestPoint_Pad_D1.5mm; Part Number Virtual Component DNP
TP13: OUT_6; TestPoint_Pad_D1.5mm; Part Number Virtual Component DNP
TP14: OUT_7; TestPoint_Pad_D1.5mm; Part Number Virtual Component DNP
TP15: OUT_8; TestPoint_Pad_D1.5mm; Part Number Virtual Component DNP
TP16: OUT_9; TestPoint_Pad_D1.5mm; Part Number Virtual Component DNP
TP17: D2_STEP; TestPoint_Pad_D1.5mm; Part Number Virtual Component DNP
TP18: D0_SDO; TestPoint_Pad_D1.5mm; Part Number Virtual Component DNP
TP19: D1_SDO; TestPoint_Pad_D1.5mm; Part Number Virtual Component DNP
TP20: D2_SDO; TestPoint_Pad_D1.5mm; Part Number Virtual Component DNP
TP21: D3_SDO; TestPoint_Pad_D1.5mm; Part Number Virtual Component DNP
TP22: D4_SDO; TestPoint_Pad_D1.5mm; Part Number Virtual Component DNP
TP23: D_ENN; TestPoint_Pad_D1.5mm; Part Number Virtual Component DNP
TP24: D_CS; TestPoint_Pad_D1.5mm; Part Number Virtual Component DNP
TP25: RXD1; TestPoint_Pad_D1.5mm; Part Number Virtual Component DNP
TP26: TXD1; TestPoint_Pad_D1.5mm; Part Number Virtual Component DNP
TP27: SCK1; TestPoint_Pad_D1.5mm; Part Number Virtual Component DNP
TP28: D2_DIR; TestPoint_Pad_D1.5mm; Part Number Virtual Component DNP
TP29: D2_DIAG0; TestPoint_Pad_D1.5mm; Part Number Virtual Component DNP
TP30: D3_STEP; TestPoint_Pad_D1.5mm; Part Number Virtual Component DNP
TP31: D3_DIR; TestPoint_Pad_D1.5mm; Part Number Virtual Component DNP
TP32: D3_DIAG0; TestPoint_Pad_D1.5mm; Part Number Virtual Component DNP
TP33: D4_STEP; TestPoint_Pad_D1.5mm; Part Number Virtual Component DNP
TP34: D4_DIR; TestPoint_Pad_D1.5mm; Part Number Virtual Component DNP
TP35: D4_DIAG0; TestPoint_Pad_D1.5mm; Part Number Virtual Component DNP
TP36: D5_STEP; TestPoint_Pad_D1.5mm; Part Number Virtual Component DNP
TP37: D5_DIR; TestPoint_Pad_D1.5mm; Part Number Virtual Component DNP
TP38: D5_DIAG0; TestPoint_Pad_D1.5mm; Part Number Virtual Component DNP
TP39: VREFP; TestPoint_Pad_D1.5mm; Part Number Virtual Component DNP

Connections:
3.3V_EXT: J16.1, J17.1, J18.1, J19.1, J20.1, J21.1, J32.1, J33.1, J34.1, J38.8
5V_EXT: J16.5, J17.5, J18.5, J19.5, J20.5, J21.5, J30.2, J32.5, J33.5, J34.5, J38.1, J42.1
5V_EXT_INPUT: J50.1
5V_SBC: J48.2, J48.4
12V_EXT: J22.1
+3.3V: J1.3, J28.8, J39.1
CAN0_H: J31.1
CAN0_L: J31.2
CAN1_H: J23.3
CAN1_L: J23.4
CAN_SHD_GND: C86.1, J23.7 (SHIELD_1), J23.8 (SHIELD_2), R20.1
DRIVER_0_A1: J26.2
DRIVER_0_A2: J26.1
DRIVER_0_B1: J26.4
DRIVER_0_B2: J26.3
DRIVER_0_DIAG0: TP3.1
DRIVER_0_DIR: TP2.1
DRIVER_0_SDO: TP18.1
DRIVER_0_STEP: TP1.1
DRIVER_1_A1: J25.2
DRIVER_1_A2: J25.1
DRIVER_1_B1: J25.4
DRIVER_1_B2: J25.3
DRIVER_1_DIAG0: TP6.1
DRIVER_1_DIR: TP5.1
DRIVER_1_SDO: TP19.1
DRIVER_1_STEP: TP4.1
DRIVER_2_A1: J24.2
DRIVER_2_A2: J24.1
DRIVER_2_B1: J24.4
DRIVER_2_B2: J24.3
DRIVER_2_DIAG0: TP29.1
DRIVER_2_DIR: TP28.1
DRIVER_2_SDO: TP20.1
DRIVER_2_STEP: TP17.1
DRIVER_3_A1: J35.2
DRIVER_3_A2: J35.1
DRIVER_3_B1: J35.4
DRIVER_3_B2: J35.3
DRIVER_3_DIAG0: TP32.1
DRIVER_3_DIR: TP31.1
DRIVER_3_SDO: TP21.1
DRIVER_3_STEP: TP30.1
DRIVER_4_A1: J36.2
DRIVER_4_A2: J36.1
DRIVER_4_B1: J36.4
DRIVER_4_B2: J36.3
DRIVER_4_DIAG0: TP35.1
DRIVER_4_DIR: TP34.1
DRIVER_4_SDO: TP22.1
DRIVER_4_STEP: TP33.1
DRIVER_5_A1: J37.2
DRIVER_5_A2: J37.1
DRIVER_5_B1: J37.4
DRIVER_5_B2: J37.3
DRIVER_5_DIAG0: TP38.1
DRIVER_5_DIR: TP37.1
DRIVER_5_STEP: TP36.1
DRIVER_CS: TP24.1
DRIVER_ENN: TP23.1
DS_LED_CK_BUFF: J42.3
DS_LED_DO_BUFF: J42.2
ESP_DATA_RDY: J39.8
ESP_EN: J39.10
GND: C86.2, J1.6, J2.2, J6.1, J7.1, J8.1, J9.1, J9.3, J16.3, J17.3, J18.3, J19.3, J20.3, J21.3, J22.2, J28.2, J30.3, J32.3, J33.3, J34.3, J38.2, J39.2, J39.12, J42.4, J48.6, J48.9, J48.14, J48.20, J48.25, J49.2, J50.3, R20.2
IO_0_IN: J19.2, J38.9
IO_0_OUT: J19.4, J38.10
IO_1_IN: J20.2
IO_1_OUT: J20.4
IO_2_IN: J21.2
IO_2_OUT: J21.4
IO_3_IN: J16.2
IO_3_OUT: J16.4
IO_4_IN: J17.2
IO_4_OUT: J17.4
IO_5_IN: J18.2
IO_5_OUT: J18.4
IO_6_IN: J32.2
IO_6_OUT: J32.4
IO_7_IN: J33.2
IO_7_OUT: J33.4
IO_8_IN: J34.2
IO_8_OUT: J34.4
OUT_0: TP7.1
OUT_0_NEG: J9.6
OUT_1: TP8.1
OUT_1_NEG: J10.1
OUT_2: TP9.1
OUT_2_NEG: J11.1
OUT_3: TP10.1
OUT_3_NEG: J12.1
OUT_4: TP11.1
OUT_4_NEG: J6.4
OUT_4_TACHO: J6.3
OUT_5: TP12.1
OUT_5_NEG: J7.4
OUT_5_TACHO: J7.3
OUT_6: TP13.1
OUT_6_NEG: J8.4
OUT_6_TACHO: J8.3
OUT_7: TP14.1
OUT_7_NEG: J3.2
OUT_8: TP15.1
OUT_8_NEG: J4.2
OUT_9: TP16.1
OUT_9_BUFF: R108.1
OUT_9_NEG: J5.2
PD_SD_CD: J38.7
PS_ON_SW: J50.2
RESET: J1.4, J1.5
RESET_EXT: J49.1
RXD0: J28.6, J38.6
RXD1: TP25.1
SBC_3.3V: J48.17
SCK0: J28.4, J38.4
SCK1: TP27.1
SPI1_DATA_RDY: J39.4
SPI1_DATA_RDY_BUFF: J48.22
SPI1_MISO: J39.5
SPI1_MISO_BUFF: J48.21
SPI1_MOSI: J48.19
SPI1_MOSI_BUFF: J39.3
SPI1_NPCS0: J39.6, J48.24
SPI1_SPCK: J48.23
SPI1_SPCK_BUFF: J39.7
SWCLK: J1.2
SWDIO: J1.1
THERMISTOR_0: J13.2
THERMISTOR_1: J14.2
THERMISTOR_2: J15.2
THERMISTOR_3: J41.2
TXD0: J28.5, J38.5
TXD1: TP26.1
U0_CS0: J28.3
U0_CS1: J28.1
U0_CS2: J28.7
U0_CS3: J28.9
U0_CS4: J38.3
URXD4: J39.11
UTXD4: J39.9
VREFP: TP39.1
VSSA: J13.1, J14.1, J15.1, J41.1
V_FUSED: J2.1, J10.2, J11.2, J12.2
V_IN: J9.2
V_OUT0_IN: J9.4
V_OUT0_OUT: J9.5
V_OUTLC1: J6.2, J7.2, J8.2
V_OUTLC2: J3.1, J4.1, J5.1
out9buff: J30.1, R108.2

Notes on the sheet:
4 Wire fan Headers
SBC Connection
DotStar LED connection
External reset connection
All test points are DNP
PanelDue
High Current Terminal HB9500-9.5
MOSI
Medium Current JST VH
Always on FAN for board cooling
Low/Medium Current Molex KK
Motor Connectors
SWD
additional 12V supply if a VFD convertor is used
MISO
Test Points
Power, MOSFET outputs
Temperature (Thermistor &PT1000)
A+ A- B+ B-
CAN RJ11 port
ESP Connection
I/O Headers (used for endstops, probes and filament monitors)
SPI DB Header
