Duet3D/Duet3-Mainboard-6HC/Duet3_Mainboard_6HC_v1.02/CAD/Htr_Fan.kicad_sch

## KiCad design Duet3_Mainboard_6HC_v1.02/CAD/Htr_Fan.kicad_sch (2023-09-28)

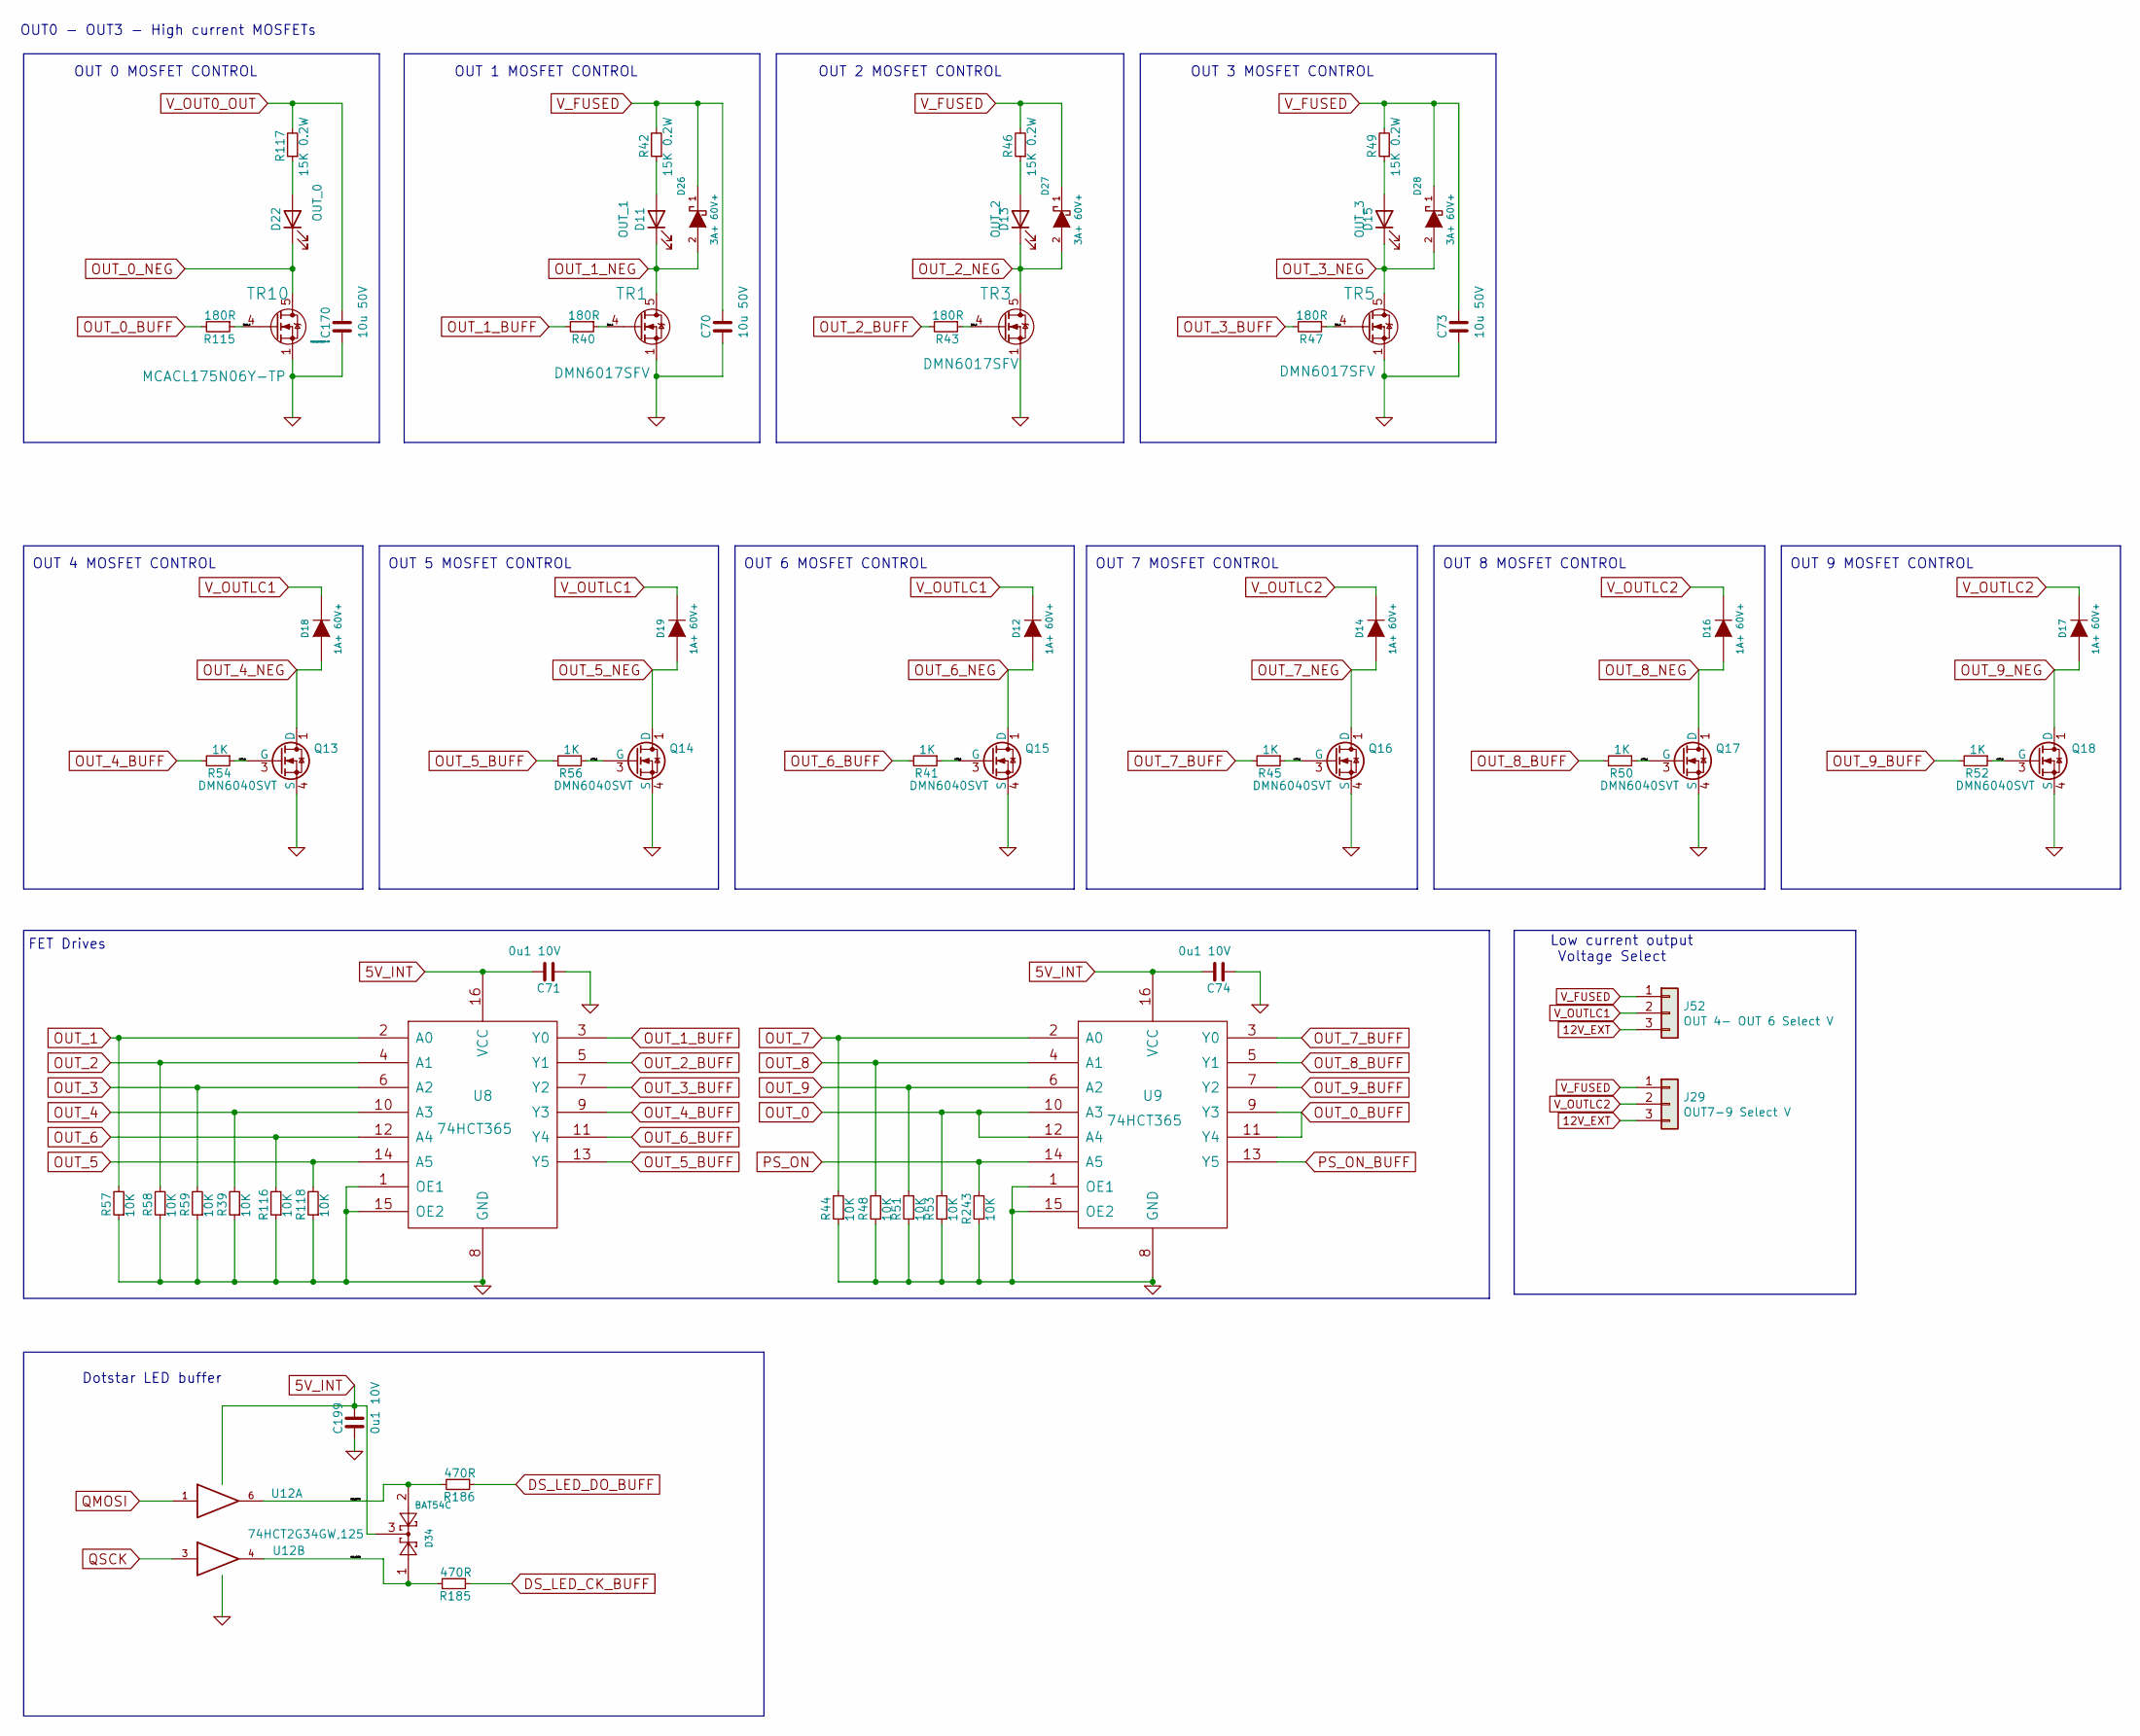
[picture p44: schematic Htr_Fan.kicad_sch]

Parts:
C70, C73, C170: 10u 50V; C_1206_3216Metric; Part Number CL31A106KBHNNNE
C71, C74, C199: 0u1 10V; C_0402_1005Metric_Wbry; Part Number CL05A104KP5NNNC
D11: OUT_1; LED_0603_1608Metric; Part Number 150060RS75000 or equivalent Red
D12, D14, D16, D17, D18, D19: 1A+ 60V+; DO-219AB; Part Number VS-1EFH02HM3/I or equivalent
D13: OUT_2; LED_0603_1608Metric; Part Number 150060RS75000 or equivalent Red
D15: OUT_3; LED_0603_1608Metric; Part Number 150060RS75000 or equivalent Red
D22: OUT_0; LED_0603_1608Metric; Part Number 150060RS75000 or equivalent Red
D26, D27, D28: 3A+ 60V+; D_SMA; Part Number CDBA360-HF, VSSA310SHM3_A/H
D34: BAT54C; SOT-23; Part Number BAT54CLT1G
J29: OUT7-9 Select V; PinHeader_1x03_P2.54mm_Vertical; Part Number THS-03-R - Jumper fitted to VIN Side
J52: OUT 4- OUT 6 Select V; PinHeader_1x03_P2.54mm_Vertical; Part Number THS-03-R - Jumper fitted to 12V side
Q13, Q14, Q15, Q16, Q17, Q18: DMN6040SVT; SOT-23-6; Part Number DMN6040SVT
R39, R44, R48, R51, R53, R57, R58, R59, R116, R118: 10K; R_0402_1005Metric_Wbry; Part Number RMCS0402FT10K0
R40, R43, R47, R115: 180R; R_0402_1005Metric_Wbry; Part Number RMCF0402FT180R
R41, R45, R50, R52, R54, R56: 1K; R_0402_1005Metric_Wbry; Part Number RK73H1ETTP1001F
R42, R46, R49, R117: 15K 0.2W; R_0603_1608Metric_Wbry; Part Number RCC060315K0FKEA
R185, R186: 470R; R_0402_1005Metric_Wbry; Part Number ERJ-2RKF4700X
R243: 10K; R_0402_1005Metric_Wbry; Part Number ESR03EZPF1002
TR1, TR3, TR5: DMN6017SFV; Diodes_PowerDI3333-8; Part Number DMN6017SFV
TR10: MCACL175N06Y-TP; POWERDFN_DFN5060; Part Number MCACL175N06Y-TP
U8, U9: 74HCT365; TSSOP-16_4.4x5mm_P0.65mm; Part Number MC74HCT365ADTR2G
U12: 74HCT2G34GW,125; SOT-363; Part Number 74HCT2G34GW,125

Connections:
5V_INT: C71.1, C74.1, C199.1, D34.3, U8.16 (VCC), U9.16 (VCC), U12.5 (VCC)
12V_EXT: J29.3, J52.3
DS_LED_CK_BUFF: R185.1
DS_LED_DO_BUFF: R186.1
GND: C70.2, C71.2, C73.2, C74.2, C170.2, C199.2, Q13.4 (S), Q14.4 (S), Q15.4 (S), Q16.4 (S), Q17.4 (S), Q18.4 (S), R39.1, R44.1, R48.1, R51.1, R53.1, R57.1, R58.1, R59.1, R116.1, R118.1, R243.1, TR1.1 (S), TR1.2 (S), TR1.3 (S), TR3.1 (S), TR3.2 (S), TR3.3 (S), TR5.1 (S), TR5.2 (S), TR5.3 (S), TR10.1 (S), TR10.2 (S), TR10.3 (S), U8.1 (OE1), U8.8 (GND), U8.15 (OE2), U9.1 (OE1), U9.8 (GND), U9.15 (OE2), U12.2 (GND)
unnamed: D11.2 (A), R42.1
unnamed: D13.2 (A), R46.1
unnamed: D15.2 (A), R49.1
unnamed: D22.2 (A), R117.1
OUT_0: R53.2, U9.10 (A3), U9.12 (A4)
OUT_0_BUFF: R115.2, U9.9 (Y3), U9.11 (Y4)
OUT_0_NEG: D22.1 (K), TR10.5 (D)
OUT_1: R57.2, U8.2 (A0)
OUT_1_BUFF: R40.2, U8.3 (Y0)
OUT_1_NEG: D11.1 (K), D26.2 (A), TR1.5 (D)
OUT_2: R58.2, U8.4 (A1)
OUT_2_BUFF: R43.2, U8.5 (Y1)
OUT_2_NEG: D13.1 (K), D27.2 (A), TR3.5 (D)
OUT_3: R59.2, U8.6 (A2)
OUT_3_BUFF: R47.2, U8.7 (Y2)
OUT_3_NEG: D15.1 (K), D28.2 (A), TR5.5 (D)
OUT_4: R39.2, U8.10 (A3)
OUT_4_BUFF: R54.2, U8.9 (Y3)
OUT_4_NEG: D18.2 (A), Q13.1 (D), Q13.2 (D), Q13.5 (D), Q13.6 (D)
OUT_5: R118.2, U8.14 (A5)
OUT_5_BUFF: R56.2, U8.13 (Y5)
OUT_5_NEG: D19.2 (A), Q14.1 (D), Q14.2 (D), Q14.5 (D), Q14.6 (D)
OUT_6: R116.2, U8.12 (A4)
OUT_6_BUFF: R41.2, U8.11 (Y4)
OUT_6_NEG: D12.2 (A), Q15.1 (D), Q15.2 (D), Q15.5 (D), Q15.6 (D)
OUT_7: R44.2, U9.2 (A0)
OUT_7_BUFF: R45.2, U9.3 (Y0)
OUT_7_NEG: D14.2 (A), Q16.1 (D), Q16.2 (D), Q16.5 (D), Q16.6 (D)
OUT_8: R48.2, U9.4 (A1)
OUT_8_BUFF: R50.2, U9.5 (Y1)
OUT_8_NEG: D16.2 (A), Q17.1 (D), Q17.2 (D), Q17.5 (D), Q17.6 (D)
OUT_9: R51.2, U9.6 (A2)
OUT_9_BUFF: R52.2, U9.7 (Y2)
OUT_9_NEG: D17.2 (A), Q18.1 (D), Q18.2 (D), Q18.5 (D), Q18.6 (D)
PS_ON: R243.2, U9.14 (A5)
PS_ON_BUFF: U9.13 (Y5)
QMOSI: U12.1
QSCK: U12.3
TR1_G: R40.1, TR1.4 (G)
TR3_G: R43.1, TR3.4 (G)
TR5_G: R47.1, TR5.4 (G)
TR10_G: R115.1, TR10.4 (G)
U12_OUTA: D34.2, R186.2, U12.6
U12_OUTB: D34.1, R185.2, U12.4
V_FUSED: C70.1, C73.1, D26.1 (K), D27.1 (K), D28.1 (K), J29.1, J52.1, R42.2, R46.2, R49.2
V_OUT0_OUT: C170.1, R117.2
V_OUTLC1: D12.1 (K), D18.1 (K), D19.1 (K), J52.2
V_OUTLC2: D14.1 (K), D16.1 (K), D17.1 (K), J29.2
out4_g: Q13.3 (G), R54.1
out5_g: Q14.3 (G), R56.1
out6_g: Q15.3 (G), R41.1
out7_g: Q16.3 (G), R45.1
out8_g: Q17.3 (G), R50.1
out9_g: Q18.3 (G), R52.1

Notes on the sheet:
OUT 6 MOSFET CONTROL
OUT 7 MOSFET CONTROL
OUT 0 MOSFET CONTROL
OUT 5 MOSFET CONTROL
Low current output Voltage Select
OUT 2 MOSFET CONTROL
OUT 4 MOSFET CONTROL
OUT 3 MOSFET CONTROL
OUT 1 MOSFET CONTROL
OUT 8 MOSFET CONTROL
Dotstar LED buffer
FET Drives
OUT 9 MOSFET CONTROL
OUT0 - OUT3 - High current MOSFETs
