Duet3D/Duet3-Mainboard-6HC/Duet3_Mainboard_6HC_v1.02/CAD/Power.kicad_sch

## KiCad design Duet3_Mainboard_6HC_v1.02/CAD/Power.kicad_sch (2023-09-28)

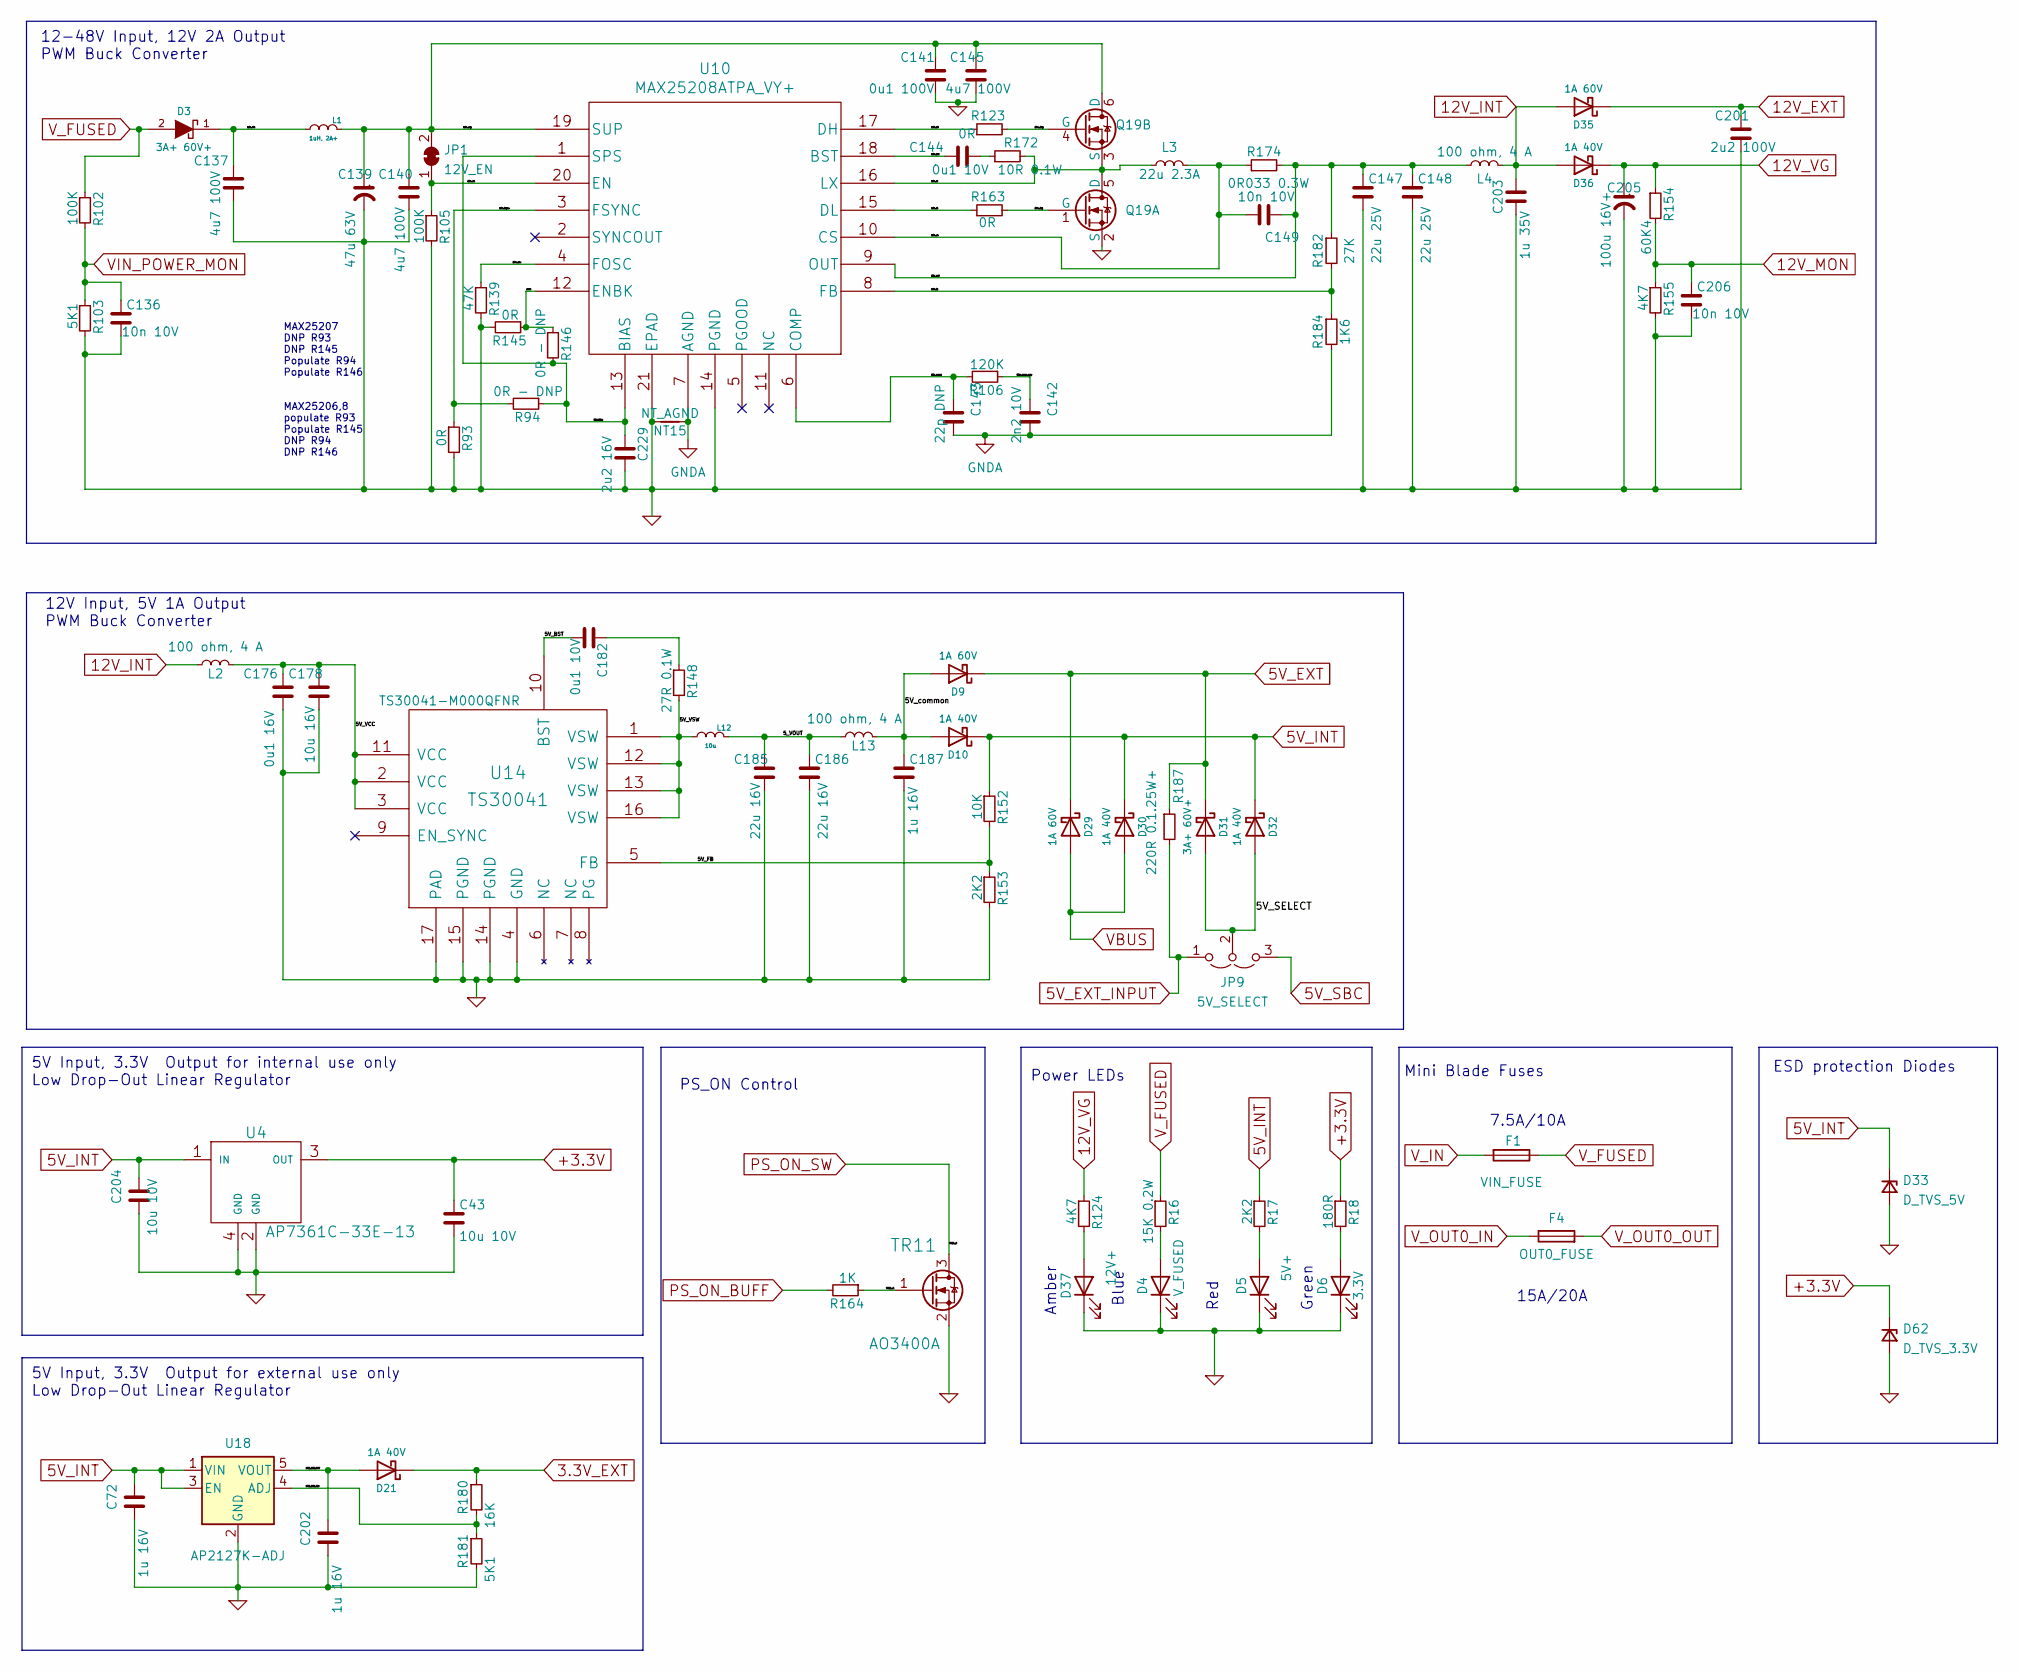
[picture p45: schematic Power.kicad_sch]

Parts:
C43, C204: 10u 10V; C_0805_2012Metric; Part Number LMK212BJ106KG-T
C72, C187, C202: 1u 16V; C_0603_1608Metric_Wbry; Part Number CL10A105KO8NNNC
C136, C149, C206: 10n 10V; C_0402_1005Metric_Wbry; Part Number C0402C103K8RAC7867
C137, C140, C145: 4u7 100V; C_1206_3216Metric; Part Number GRM31CC72A475KE11L
C139: 47u 63V; CP_Elec_8x10; Part Number UUR1J470MNL1GS or equivalent 8650807530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
C141: 0u1 100V; C_0603_1608Metric_Wbry; Part Number HMK107B7104MA-T or similar
C142: 2n2 10V; C_0402_1005Metric_Wbry; Part Number can use GCM155R71H222KA37D
C143: 22p DNP; C_0402_1005Metric_Wbry; Part Number TBC if fitted, 10p-22p
C144, C182: 0u1 10V; C_0402_1005Metric_Wbry; Part Number CL05A104KP5NNNC
C147, C148: 22u 25V; C_0805_2012Metric; Part Number GRM21BR61E226ME44L
C176: 0u1 16V; C_0402_1005Metric_Wbry; Part Number CL05B104KO5NNNC
C178: 10u 16V; C_0805_2012Metric; Part Number CL21A106KOCLRNC
C185, C186: 22u 16V; C_0805_2012Metric; Part Number CL21A226MOQNNNE
C201: 2u2 100V; C_1210_3225Metric; Part Number CL32B225KCJSNNE
C203: 1u 35V; C_0603_1608Metric_Wbry; Part Number GMK107BJ105KAHT
C205: 100u 16V+; CP_Elec_6.3x7.7; Part Number 865080545012 (16V version can be used)
C229: 2u2 16V; C_0603_1608Metric_Wbry; Part Number EMK107BC6225KA-T
D3, D31: 3A+ 60V+; D_SMA; Part Number CDBA360-HF, VSSA310SHM3_A/H
D4: V_FUSED; LED_0603_1608Metric; Part Number 150060BS75000 or equivalent Blue
D5: 5V+; LED_0603_1608Metric; Part Number 150060RS75000 or equivalent Red
D6: 3.3V; LED_0603_1608Metric; Part Number 150060VS75000 or equivalent Green
D9, D29, D35: 1A 60V; D_SOD-123F; Part Number DSS16UTR
D10, D21, D30, D32, D36: 1A 40V; D_SOD-123F; Part Number DSS14UTR or RB162MM-40TR or similar (ca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
D33: D_TVS_5V; DFN1610-2L; Part Number 824032815 or 824031815
D37: 12V+; LED_0603_1608Metric; Part Number 150060AS75000 or equivalent Amber
D62: D_TVS_3.3V; DFN1610-2L; Part Number 824032813
F1: VIN_FUSE; MCCQ-122-minibladefuseholder; Part Number MCCQ-122 - 15A fitted
F4: OUT0_FUSE; MCCQ-122-minibladefuseholder; Part Number MCCQ-122 - 15A Fitted
JP1: 12V_EN; SolderJumper-2_P1.3mm_Bridged_RoundedPad1.0x1.5mm; Part Number Virtual Component DNP
JP9: 5V_SELECT; PinHeader_1x03_P2.54mm_Vertical; Part Number THS-03-R - Jumper fitted to EXT 5V side
L1: 1uH, 2A+; L_1008_2512Metric; Part Number BDCD002520121R0MS1 preferred (alternati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
L2, L4, L13: 100 ohm, 4 A; L_0805_2012Metric; Part Number 742792025, MPZ2012S101A or similar
L3: 22u 2.3A; L_Wuerth_WE-TPC-744071220; Part Number 744071220
L12: 10u; L_Wuerth_7440405xxxx; Part Number 74404054100 or similar 10u
NT15: NT_AGND; NetTie-2_SMD_Pad0.25mm; Part Number Virtual Component DNP
Q19: DMT6018LDR; Fairchild_DualPower33-6_3x3mm; Part Number DMT6018LDR
R16: 15K 0.2W; R_0603_1608Metric_Wbry; Rating 0.2W; Part Number RCC060315K0FKEA
R17, R153: 2K2; R_0402_1005Metric_Wbry; Part Number RK73H1ETTP2201F
R18: 180R; R_0402_1005Metric_Wbry; Part Number RMCF0402FT180R
R93, R123, R145, R163: 0R; R_0402_1005Metric_Wbry; Part Number RMCF0402ZT0R00
R94, R146: 0R - DNP; R_0402_1005Metric_Wbry; Part Number DNP
R102, R105: 100K; R_0402_1005Metric_Wbry; Part Number RMCF0402FT100K
R103, R181: 5K1; R_0402_1005Metric_Wbry; Part Number RMCF0402FT5K10
R106: 120K; R_0402_1005Metric_Wbry; Part Number RMCF0402FT120K
R124, R155: 4K7; R_0402_1005Metric_Wbry; Part Number RK73H1ETTP4701F
R139: 47K; R_0402_1005Metric_Wbry; Part Number RC0402FR-1347KL
R148: 27R 0.1W; R_0402_1005Metric_Wbry; Part Number ERJ-2RKF27R0X
R152: 10K; R_0402_1005Metric_Wbry; Part Number RMCF0402FT10K0
R154: 60K4; R_0402_1005Metric_Wbry; Part Number RMCF0402FT60K4
R164: 1K; R_0402_1005Metric_Wbry; Part Number RK73H1ETTP1001F
R172: 10R 0.1W; R_0402_1005Metric_Wbry; Part Number ERJ-U02F10R0X
R174: 0R033 0.3W; R_0805_2012Metric; Part Number UR73VD2ATTD33L0F, ERJ-6BWFR033V
R180: 16K; R_0402_1005Metric_Wbry; Part Number RMCF0402FT16K0
R182: 27K; R_0402_1005Metric_Wbry; Part Number RMCF0402FT27K0
R184: 1K6; R_0402_1005Metric_Wbry; Part Number RMCF0402FT1K60
R187: 220R 0.1.25W+; R_0402_1005Metric_Wbry; Part Number RMCP0402FT220R
TR11: AO3400A; SOT-23_AO3400A; Part Number AO3400A or similar (PMV20XNER, PMV40UN2)
U4: AP7361C-33E-13; SOT-223; Part Number AP7361C-33E-13
U10: MAX25208ATPA_VY+; MAX25206.7.8ATPA_VY; Part Number MAX25206ATPA_VY+,MAX25207ATPA_VY+,MAX25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
U14: TS30041; QFN-16-1EP_3x3mm_P0.5mm_EP1.8x1.8mm; Rating Adj (set to 12V) 1A; Part Number TS30041-M000QFNR
U18: AP2127K-ADJ; SOT-23-5; Part Number AP2127K-ADJTRG1

Connections:
3.3V_EXT: D21.1 (K), R180.1
3V3_EXT_ADJ: R180.2, R181.1, U18.4 (ADJ)
3V3_EXT_OUT: C202.1, D21.2 (A), U18.5 (VOUT)
5V_BST: C182.2, U14.10 (BST)
5V_EXT: D9.1 (K), D29.1 (K), D31.1 (K), R187.1
5V_EXT_INPUT: JP9.1 (A), R187.2
5V_FB: R152.2, R153.1, U14.5 (FB)
5V_INT: C72.1, C204.1, D10.1 (K), D30.1 (K), D32.1 (K), D33.1 (K), R17.1, R152.1, U4.1 (IN), U18.1 (VIN), U18.3 (EN)
5V_SBC: JP9.3 (B)
5V_SELECT: D31.2 (A), D32.2 (A), JP9.2 (C)
5V_VCC: C176.1, C178.1, L2.1 (A), U14.2 (VCC), U14.3 (VCC), U14.11 (VCC)
5V_VSW: L12.2 (B), R148.2, U14.1 (VSW), U14.12 (VSW), U14.13 (VSW), U14.16 (VSW)
5V_common: C187.1, D9.2 (A), D10.2 (A), L13.1 (A)
5_VOUT: C185.1, C186.1, L12.1 (A), L13.2 (B)
12V_EXT: C201.1, D35.1 (K)
12V_INT: C203.2, D35.2 (A), D36.2 (A), L2.2 (B), L4.1 (A)
12V_MON: C206.1, R154.2, R155.1
12V_VG: C205.1, D36.1 (K), R124.1, R154.1
12V_dh: R123.1, U10.17 (DH)
12v_bias: C229.1, R94.1, R146.2, U10.1 (SPS), U10.13 (BIAS)
12v_bst: C144.1, U10.18 (BST)
12v_comp: C143.1, R106.2, U10.6 (COMP)
12v_comp_cap: C142.1, R106.1
12v_cs: C149.2, L3.1 (A), R174.1, U10.10 (CS)
12v_dhg: Q19.4 (G), R123.2
12v_dl: R163.1, U10.15 (DL)
12v_dlg: Q19.1 (G), R163.2
12v_en: JP1.1 (A), R105.1, U10.20 (EN)
12v_fb: R182.2, R184.1, U10.8 (FB)
12v_fsync: R93.1, R94.2, U10.3 (FSYNC)
12v_lx: L3.2 (B), Q19.3 (S), Q19.5 (D), R172.2, U10.16 (LX)
12v_osc: R139.1, U10.4 (FOSC)
12v_out: C147.1, C148.1, C149.1, L4.2 (B), R174.2, R182.1, U10.9 (OUT)
12v_sup: C139.1, C140.1, C141.1, C145.1, JP1.2 (B), L1.1 (A), Q19.6 (D), U10.19 (SUP)
12v_vin: C137.1, D3.1 (K), L1.2 (B)
+3.3V: C43.1, D62.1 (K), R18.1, U4.3 (OUT)
GND: C43.2, C72.2, C136.2, C137.2, C139.2, C140.2, C141.2, C145.2, C147.2, C148.2, C176.2, C178.2, C185.2, C186.2, C187.2, C201.2, C202.2, C203.1, C204.2, C205.2, C206.2, C229.2, D4.1 (K), D5.1 (K), D6.1 (K), D33.2 (A), D37.1 (K), D62.2 (A), NT15.1, Q19.2 (S), R93.2, R103.2, R105.2, R139.2, R145.2, R153.2, R155.2, R181.2, TR11.2 (S), U4.2 (GND), U4.4 (GND), U10.14 (PGND), U10.21 (EPAD), U14.4 (GND), U14.14 (PGND), U14.15 (PGND), U14.17 (PAD), U18.2 (GND)
GNDA: C142.2, C143.2, NT15.2, R184.2, U10.7 (AGND)
unnamed: C144.2, R172.1
unnamed: C182.1, R148.1
unnamed: D4.2 (A), R16.2
unnamed: D5.2 (A), R17.2
unnamed: D6.2 (A), R18.2
unnamed: D37.2 (A), R124.2
PS_ON_BUFF: R164.2
PS_ON_SW: TR11.3 (D)
TR11_G: R164.1, TR11.1 (G)
VBUS: D29.2 (A), D30.2 (A)
VIN_POWER_MON: C136.1, R102.2, R103.1
V_FUSED: D3.2 (A), F1.1, R16.1, R102.1
V_IN: F1.2
V_OUT0_IN: F4.1
V_OUT0_OUT: F4.2
enbk: R145.1, R146.1, U10.12 (ENBK)

Notes on the sheet:
Blue
5V Input, 3.3V Output for internal use only Low Drop-Out Linear Regulator
5V Input, 3.3V Output for external use only Low Drop-Out Linear Regulator
Mini Blade Fuses
15A/20A
12V Input, 5V 1A Output PWM Buck Converter
Amber
ESD protection Diodes
MAX25207 DNP R93 DNP R145 Populate R94 Populate R146 MAX25206,8 populate R93 Populate R145 DNP R94 DNP R146
Green
Power LEDs
PS_ON Control
12-48V Input, 12V 2A Output PWM Buck Converter
7.5A/10A
Red
