Duet3D/Duet3-Mainboard-6HC/Duet3_Mainboard_6HC_v1.02/CAD/Processor.kicad_sch

## KiCad design Duet3_Mainboard_6HC_v1.02/CAD/Processor.kicad_sch (2023-09-28)

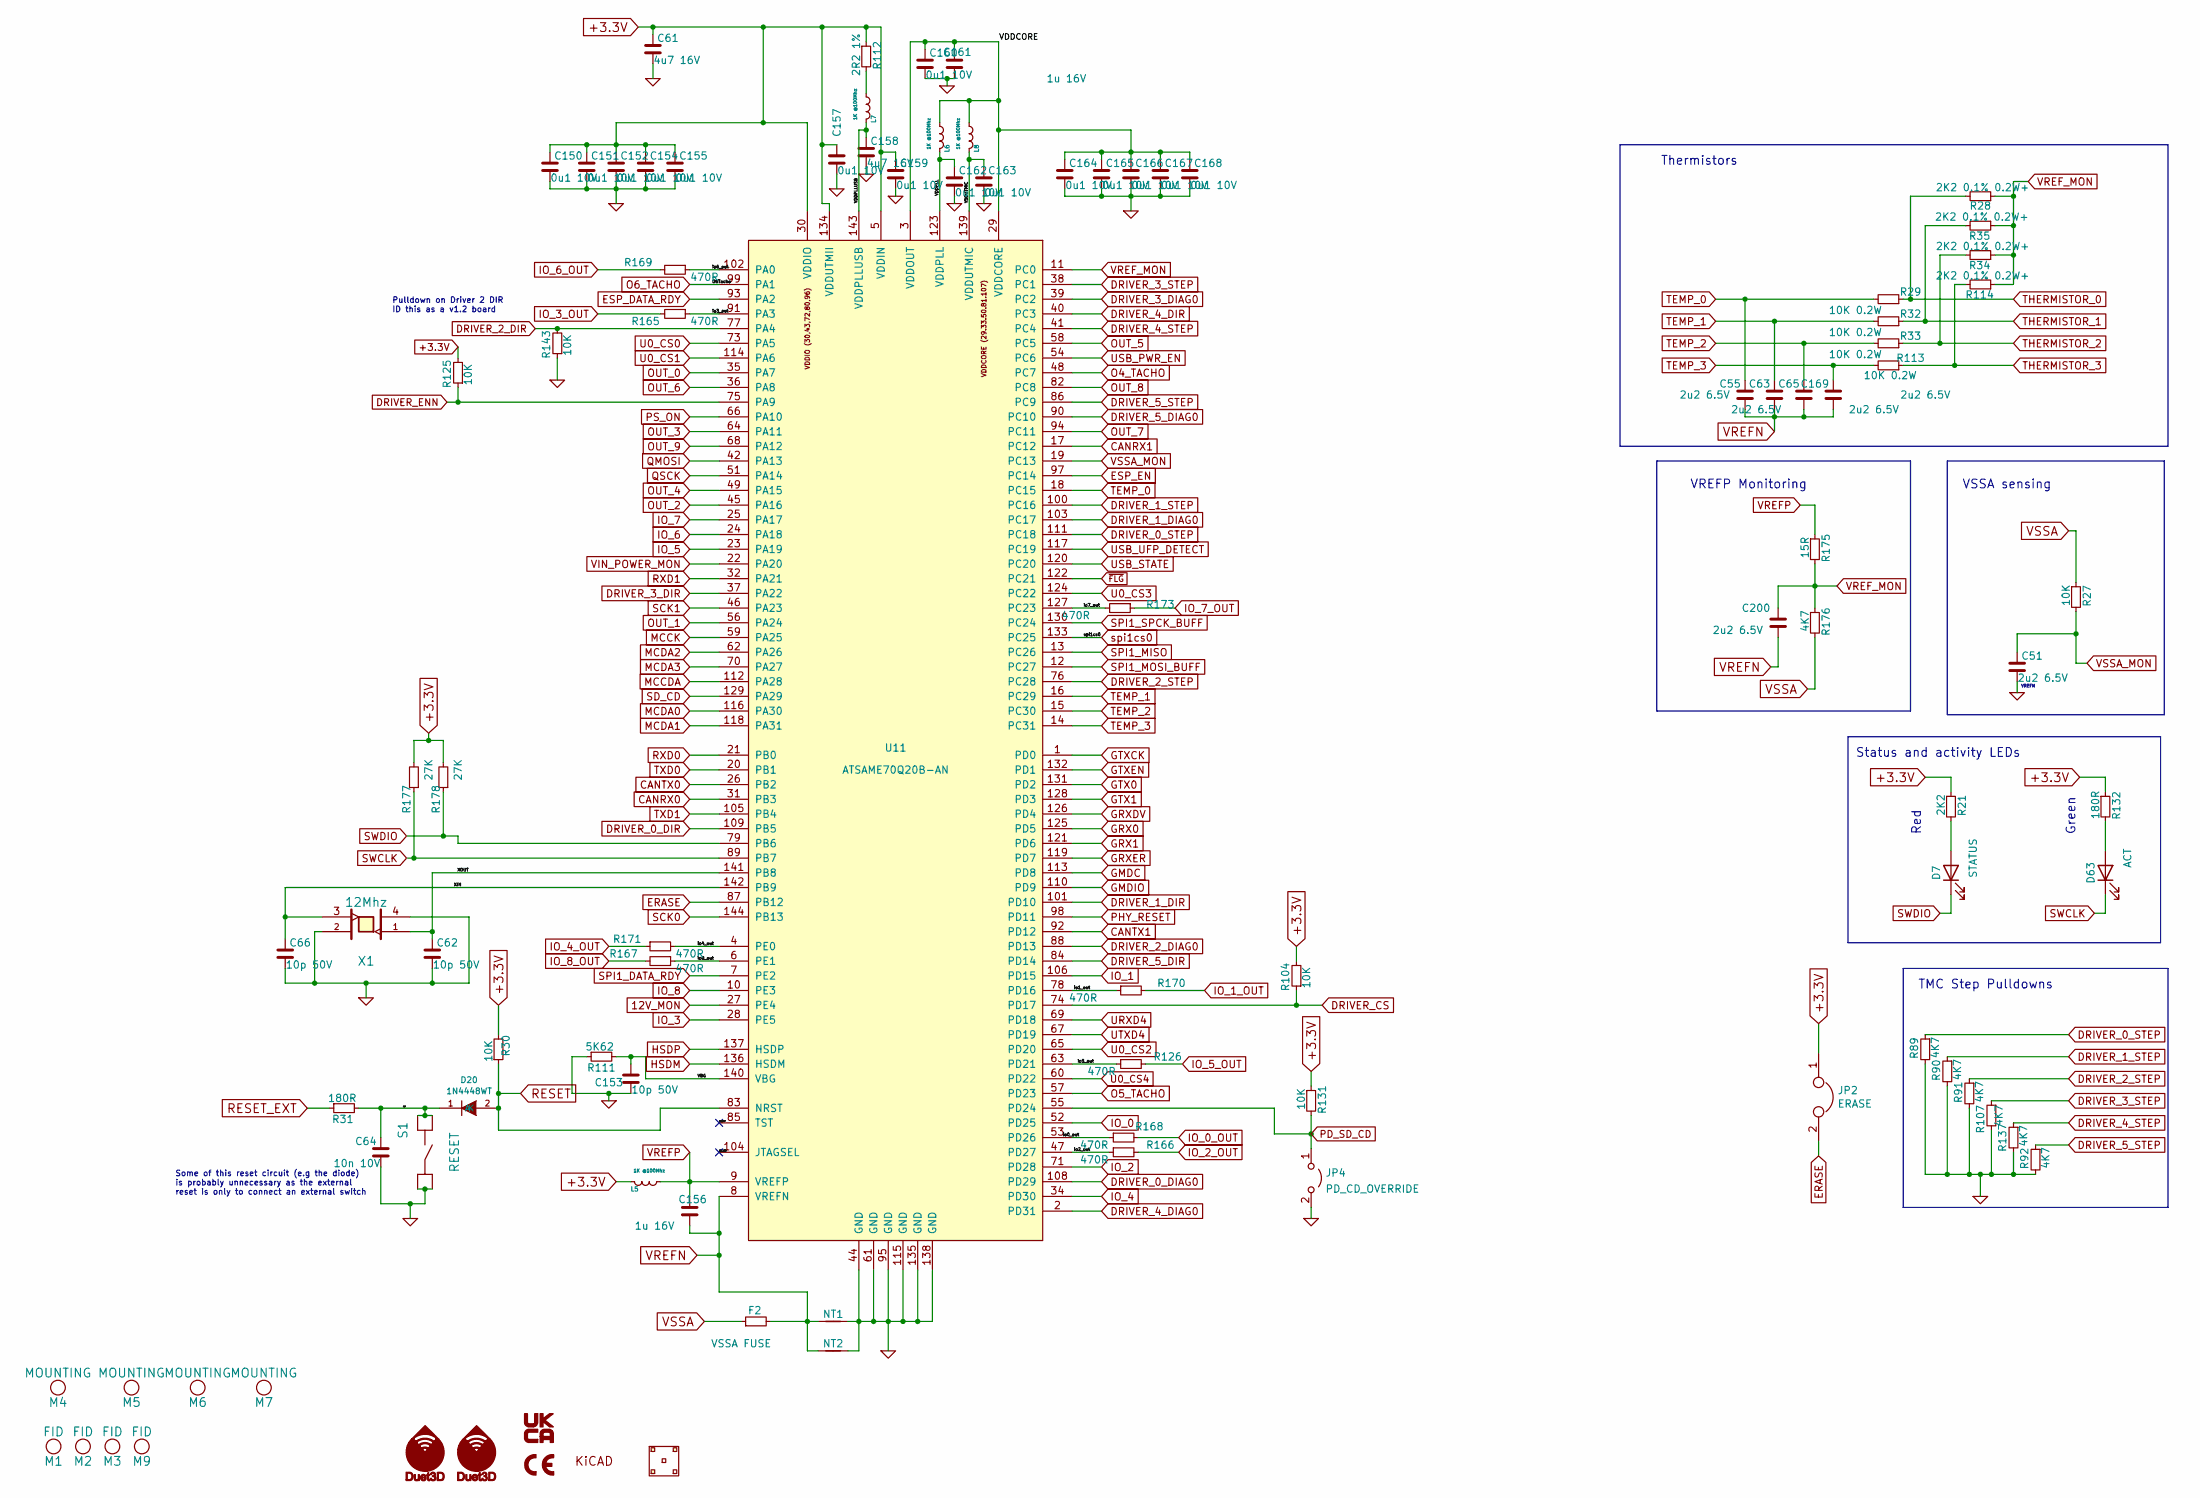
[picture p46: schematic Processor.kicad_sch]

Parts:
BC1: SYM_2D_Barcode; 2D_Barcode_6x6_target; Part Number Walkbury 2D Barcode Target Point
C51, C55, C63, C65, C169, C200: 2u2 6.5V; C_0603_1608Metric_Wbry; Part Number JMK107BJ225KA-T
C61, C158: 4u7 16V; C_0805_2012Metric; Part Number CL21A475KOFNNNE
C62, C66, C153: 10p 50V; C_0402_1005Metric_Wbry; Part Number C0402C100J5GACTU
C64: 10n 10V; C_0402_1005Metric_Wbry; Part Number C0402C103K8RAC7867
C150, C151, C152, C154, C155, C157, C159, C160, C162, C163, C164, C165, C166, C167, C168: 0u1 10V; C_0402_1005Metric_Wbry; Part Number CL05A104KP5NNNC
C156, C161: 1u 16V; C_0603_1608Metric_Wbry; Part Number CL10A105KO8NNNC
D7: STATUS; LED_0603_1608Metric; Part Number 150060RS75000 or equivalent Red
D20: 1N4448WT; SOD-523F; Part Number 1N4448WT
D63: ACT; LED_0603_1608Metric; Part Number 150060VS75000 or equivalent Green
F2: VSSA FUSE; Fuse_1206_3216Metric; Part Number 0ZCJ0020FF2E
G1: Logo_UKCA; Logo_UKCA_5mm; Part Number DNP Virtual Component
JP2: ERASE; PinHeader_1x02_P2.54mm_Vertical; Part Number THS-02-R - Jumper not fitted
JP4: PD_CD_OVERRIDE; PinHeader_1x02_P2.54mm_Vertical; Part Number THS-02-R - Jumper not fitted
L5, L6, L7, L8: 1K @100Mhz; L_0603_1608Metric; Part Number 742792662 or BK1608HS102-T, PE-0603FB10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
M1, M2, M3, M9: FID; Fiducial_0.5mm_Mask1.5mm; Part Number Virtual Component DNP
M4, M5, M6, M7: MOUNTING; MountingHole_4.3mm_M4; Part Number Virtual Component DNP
M8, M10: Duet3D_Logo; LOGO_NEW_Duet3D_vertical_6mm; Part Number Virtual Component DNP
M11: CE_LOGO; CE-Logo_8.5x6mm_SilkScreen; Part Number Virtual Component DNP
M12: Logo_KICAD; KiCad-Logo_6mm_SilkScreen; Part Number Virtual Component DNP
NT1, NT2: NT_VSSA; NetTie-2_SMD_Pad0.5mm; Part Number Virtual Component DNP
R21: 2K2; R_0402_1005Metric_Wbry; Part Number RK73H1ETTP2201F
R27, R30, R104, R125, R131, R143: 10K; R_0402_1005Metric_Wbry; Part Number RMCS0402FT10K0
R28, R34, R35, R114: 2K2 0.1% 0.2W+; R_0603_1608Metric_Wbry; Part Number ERJ-PB3B2201V
R29, R32, R33, R113: 10K 0.2W; R_0603_1608Metric_Wbry; Part Number ESR03EZPF1002
R31, R132: 180R; R_0402_1005Metric_Wbry; Part Number RMCF0402FT180R
R89, R90, R91, R92, R107, R137, R176: 4K7; R_0402_1005Metric_Wbry; Part Number RK73H1ETTP4701F
R111: 5K62; R_0402_1005Metric_Wbry; Part Number RMCF0402FT5K62
R112: 2R2 1%; R_0402_1005Metric_Wbry; Part Number RMCF0402FT2R20
R126, R165, R166, R167, R168, R169, R170, R171, R173: 470R; R_0402_1005Metric_Wbry; Part Number ERJ-2RKF4700X
R175: 15R; R_0402_1005Metric_Wbry; Part Number RMCF0402FT15R0
R177, R178: 27K; R_0402_1005Metric_Wbry; Part Number RK73H1ETTP2702F
S1: RESET; SW_SIDE_1_lugs; Part Number LY-A03-02A
U11: ATSAME70Q20B-AN; LQFP-144_20x20mm_P0.5mm; Part Number ATSAME70Q20B-AN
X1: 12Mhz; Crystal_SMD_ECS-33B-4Pin_3.2x2.5mm; Part Number FL1200112TR-ND or ECS-120-10-33B-CKM-TR,

Connections:
12V_MON: U11.27 (PE4)
+3.3V: C61.1, C150.1, C151.1, C152.1, C154.1, C155.1, C157.1, C159.1, JP2.1, L5.1 (A), R21.1, R30.2, R104.2, R112.1, R125.2, R131.1, R132.1, R177.2, R178.2, U11.5 (VDDIN), U11.30 (VDDIO), U11.43 (VDDIO), U11.72 (VDDIO), U11.80 (VDDIO), U11.96 (VDDIO), U11.134 (VDDUTMII)
CANRX0: U11.31 (PB3)
CANRX1: U11.17 (PC12)
CANTX0: U11.26 (PB2)
CANTX1: U11.92 (PD12)
DRIVER_0_DIAG0: U11.108 (PD29)
DRIVER_0_DIR: U11.109 (PB5)
DRIVER_0_STEP: R89.1, U11.111 (PC18)
DRIVER_1_DIAG0: U11.103 (PC17)
DRIVER_1_DIR: U11.101 (PD10)
DRIVER_1_STEP: R90.1, U11.100 (PC16)
DRIVER_2_DIAG0: U11.88 (PD13)
DRIVER_2_DIR: R143.2, U11.77 (PA4)
DRIVER_2_STEP: R91.1, U11.76 (PC28)
DRIVER_3_DIAG0: U11.39 (PC2)
DRIVER_3_DIR: U11.37 (PA22)
DRIVER_3_STEP: R107.1, U11.38 (PC1)
DRIVER_4_DIAG0: U11.2 (PD31)
DRIVER_4_DIR: U11.40 (PC3)
DRIVER_4_STEP: R137.1, U11.41 (PC4)
DRIVER_5_DIAG0: U11.90 (PC10)
DRIVER_5_DIR: U11.84 (PD14)
DRIVER_5_STEP: R92.1, U11.86 (PC9)
DRIVER_CS: R104.1, U11.74 (PD17)
DRIVER_ENN: R125.1, U11.75 (PA9)
ERASE: JP2.2, U11.87 (PB12)
ESP_DATA_RDY: U11.93 (PA2)
ESP_EN: U11.97 (PC14)
GMDC: U11.113 (PD8)
GMDIO: U11.110 (PD9)
GND: C51.2, C61.2, C62.2, C64.2, C66.2, C150.2, C151.2, C152.2, C153.2, C154.2, C155.2, C157.2, C158.2, C159.2, C160.2, C161.2, C162.2, C163.2, C164.2, C165.2, C166.2, C167.2, C168.2, JP4.2 (B), NT1.2, NT2.2, R89.2, R90.2, R91.2, R92.2, R107.2, R111.1, R137.2, R143.1, S1.1, S1.2, U11.44 (GND), U11.61 (GND), U11.95 (GND), U11.115 (GND), U11.135 (GND), U11.138 (GND), X1.2, X1.4
GRX0: U11.125 (PD5)
GRX1: U11.121 (PD6)
GRXDV: U11.126 (PD4)
GRXER: U11.119 (PD7)
GTX0: U11.131 (PD2)
GTX1: U11.128 (PD3)
GTXCK: U11.1 (PD0)
GTXEN: U11.132 (PD1)
HSDM: U11.136 (HSDM)
HSDP: U11.137 (HSDP)
IO_0: U11.52 (PD25)
IO_0_OUT: R168.2
IO_1: U11.106 (PD15)
IO_1_OUT: R170.2
IO_2: U11.71 (PD28)
IO_2_OUT: R166.2
IO_3: U11.28 (PE5)
IO_3_OUT: R165.2
IO_4: U11.34 (PD30)
IO_4_OUT: R171.1
IO_5: U11.23 (PA19)
IO_5_OUT: R126.2
IO_6: U11.24 (PA18)
IO_6_OUT: R169.2
IO_7: U11.25 (PA17)
IO_7_OUT: R173.1
IO_8: U11.10 (PE3)
IO_8_OUT: R167.2
MCCDA: U11.112 (PA28)
MCCK: U11.59 (PA25)
MCDA0: U11.116 (PA30)
MCDA1: U11.118 (PA31)
MCDA2: U11.62 (PA26)
MCDA3: U11.70 (PA27)
NC_JSEL: U11.104 (JTAGSEL)
NC_TST: U11.85 (TST)
unnamed: D7.2 (A), R21.2
unnamed: D63.2 (A), R132.2
unnamed: L7.2 (B), R112.2
O4_TACHO: U11.48 (PC7)
O5_TACHO: U11.57 (PD23)
O6_TACHO: U11.99 (PA1)
OUT_0: U11.35 (PA7)
OUT_1: U11.56 (PA24)
OUT_2: U11.45 (PA16)
OUT_3: U11.64 (PA11)
OUT_4: U11.49 (PA15)
OUT_5: U11.58 (PC5)
OUT_6: U11.36 (PA8)
OUT_7: U11.94 (PC11)
OUT_8: U11.82 (PC8)
OUT_9: U11.68 (PA12)
PD_SD_CD: JP4.1 (A), R131.2, U11.55 (PD24)
PHY_RESET: U11.98 (PD11)
PS_ON: U11.66 (PA10)
QMOSI: U11.42 (PA13)
QSCK: U11.51 (PA14)
RESET: D20.2 (A), R30.1, U11.83 (NRST)
RESET_EXT: R31.1
RXD0: U11.21 (PB0)
RXD1: U11.32 (PA21)
SCK0: U11.144 (PB13)
SCK1: U11.46 (PA23)
SD_CD: U11.129 (PA29)
SPI1_DATA_RDY: U11.7 (PE2)
SPI1_MISO: U11.13 (PC26)
SPI1_MOSI_BUFF: U11.12 (PC27)
SPI1_SPCK_BUFF: U11.130 (PC24)
SWCLK: D63.1 (K), R177.1, U11.89 (PB7)
SWDIO: D7.1 (K), R178.1, U11.79 (PB6)
TEMP_0: C55.1, R29.2, U11.18 (PC15)
TEMP_1: C63.1, R32.2, U11.16 (PC29)
TEMP_2: C65.1, R33.2, U11.15 (PC30)
TEMP_3: C169.1, R113.2, U11.14 (PC31)
THERMISTOR_0: R28.2, R29.1
THERMISTOR_1: R32.1, R35.2
THERMISTOR_2: R33.1, R34.2
THERMISTOR_3: R113.1, R114.2
TXD0: U11.20 (PB1)
TXD1: U11.105 (PB4)
U0_CS0: U11.73 (PA5)
U0_CS1: U11.114 (PA6)
U0_CS2: U11.65 (PD20)
U0_CS3: U11.124 (PC22)
U0_CS4: U11.60 (PD22)
URXD4: U11.69 (PD18)
USB_PWR_EN: U11.54 (PC6)
USB_STATE: U11.120 (PC20)
USB_UFP_DETECT: U11.117 (PC19)
UTXD4: U11.67 (PD19)
VBG: C153.1, R111.2, U11.140 (VBG)
VDDCORE: C160.1, C161.1, C164.1, C165.1, C166.1, C167.1, C168.1, L6.2 (B), L8.2 (B), U11.3 (VDDOUT), U11.29 (VDDCORE), U11.33 (VDDCORE), U11.50 (VDDCORE), U11.81 (VDDCORE), U11.107 (VDDCORE)
VDDPLL: C162.1, L6.1 (A), U11.123 (VDDPLL)
VDDPLLUSB: C158.1, L7.1 (A), U11.143 (VDDPLLUSB)
VDDUTMIC: C163.1, L8.1 (A), U11.139 (VDDUTMIC)
VIN_POWER_MON: U11.22 (PA20)
VREFN: C55.2, C63.2, C65.2, C156.2, C169.2, C200.2, F2.2, NT1.1, NT2.1, U11.8 (VREFN)
VREFP: C156.1, L5.2 (B), R175.1, U11.9 (VREFP)
VREF_MON: C200.1, R28.1, R34.1, R35.1, R114.1, R175.2, R176.1, U11.11 (PC0)
VSSA: F2.1, R27.1, R176.2
VSSA_MON: C51.1, R27.2, U11.19 (PC13)
XIN: C66.1, U11.142 (PB9), X1.3
XOUT: C62.1, U11.141 (PB8), X1.1
io0_out: R168.1, U11.53 (PD26)
io1_out: R170.1, U11.78 (PD16)
io2_out: R166.1, U11.47 (PD27)
io3_out: R165.1, U11.91 (PA3)
io4_out: R171.2, U11.4 (PE0)
io5_out: R126.1, U11.63 (PD21)
io6_out: R169.1, U11.102 (PA0)
io7_out: R173.2, U11.127 (PC23)
io8_out: R167.1, U11.6 (PE1)
rst: C64.1, D20.1 (K), R31.2, S1.3, S1.4
spi1cs0: U11.133 (PC25)
~FLG: U11.122 (PC21)

Notes on the sheet:
Thermistors
Red
VSSA sensing
VREFP Monitoring
Pulldown on Driver 2 DIR ID this as a v1.2 board
VREFN
Some of this reset circuit (e.g the diode) is probably unnecessary as the external reset is only to connect an external switch
TMC Step Pulldowns
Green
Status and activity LEDs
