Duet3D/Duet3-Mainboard-6HC/Duet3_Mainboard_6HC_v1.02/CAD/Stepper_Drv.kicad_sch

## KiCad design Duet3_Mainboard_6HC_v1.02/CAD/Stepper_Drv.kicad_sch (2023-09-28)

Schematic: Stepper_Drv.kicad_sch

Parts:
C2, C4, C5, C6, C49, C50, C52, C53, C110, C111, C112, C113: 2u2 16V; C_0603_1608Metric_Wbry; Part Number EMK107BC6225KA-T
C7, C8, C54, C56, C114, C115: 0u1 10V; C_0402_1005Metric_Wbry; Part Number CL05A104KP5NNNC
C9, C10, C57, C58, C116, C117: 470n 16V; C_0603_1608Metric_Wbry; Part Number CL10B474KO8NNNC
C11, C12, C16, C17, C59, C60, C69, C75, C118, C119, C122, C123: 2n2 50V; C_0402_1005Metric_Wbry; Part Number GCM155R71H222KA37D
C13, C14, C18, C19, C24, C25, C26, C27, C67, C68, C76, C77, C82, C83, C84, C85, C120, C121, C124, C125, C130, C131, C132, C133: 220n 16V; C_0603_1608Metric_Wbry; Part Number CL10B224KO8NNNC
C20, C21, C28, C29, C78, C79, C87, C91, C126, C127, C134, C135: 0u1 100V; C_0603_1608Metric_Wbry; Part Number HMK107B7104MA-T or similar
C22, C23, C80, C81, C128, C129: 22n X7R 10% 100V; C_0603_1608Metric_Wbry; Part Number C0603C223K1RACTU
C30, C31, C92, C93, C207, C208: 220u 63V; CP_Radial_D10.0mm_P5.00mm; Part Number 860010775018
C32, C33, C34, C35, C36, C37, C38, C39, C94, C95, C96, C97, C98, C99, C100, C101, C209, C210, C211, C212, C213, C214, C215, C216: 220n 100V; C_1206_3216Metric; Part Number C3216X7R2A224K115AA
C40, C41, C42, C44, C45, C46, C47, C48, C102, C103, C104, C105, C106, C107, C108, C109, C217, C218, C219, C220, C221, C222, C223, C224: 1n 100V; C_0603_1608Metric_Wbry; Part Number CGA3E2X7R2A102K080AA
D38, D39, D40, D41, D42, D43, D44, D45, D46, D47, D48, D49, D50, D51, D52, D53, D54, D55, D56, D57, D58, D59, D60, D61: BAT40V; SOT-563; Part Number BAT40V-7
NT3, NT4, NT5, NT6, NT7, NT8, NT9, NT10, NT11, NT12, NT13, NT14: NT_SBG; NetTie-2_SMD_Pad0.25mm; Part Number Virtual Component DNP
Q1, Q2, Q3, Q4, Q5, Q6, Q7, Q8, Q9, Q10, Q11, Q12: DMHT6016LFJ; DMHT6016LFJ-13; Part Number DMHT6016LFJ
R5, R6, R77, R78, R206, R207: 2R2 1%; R_0402_1005Metric_Wbry; Part Number RMCF0402FT2R20
R9, R10, R11, R12, R13, R14, R15, R19, R79, R80, R81, R82, R95, R96, R97, R98, R208, R209, R210, R211, R212, R213, R214, R215: 47R 1%; R_0402_1005Metric_Wbry; Part Number RMCF0402FT47R0
R25, R26, R36, R37, R38, R55, R60, R61, R62, R63, R64, R65, R66, R67, R68, R69, R99, R100, R101, R189, R190, R191, R192, R193, R194, R195, R196, R197, R198, R199, R200, R201, R216, R217, R218, R219, R220, R221, R222, R223, R224, R225, R226, R227, R228, R229, R230, R231: 150R; R_0402_1005Metric_Wbry; Part Number RMCF0402FT150R
R70, R71, R75, R76, R202, R203, R204, R205, R232, R233, R234, R235: 0R05 1% 1W; R_1206_3216Metric_Pad1.24x1.80mm_HandSolder; Part Number ERJ-8CWFR050V
U1, U2, U3, U5, U6, U7: TMC2160; TMC5160-TA; Part Number TMC2160A-TA

Connections:
12V_VG: C2.2, C4.2, C49.2, C50.2, C110.2, C111.2, U1.3 (12VOUT), U1.4 (VSA), U2.3 (12VOUT), U2.4 (VSA), U3.3 (12VOUT), U3.4 (VSA), U5.3 (12VOUT), U5.4 (VSA), U6.3 (12VOUT), U6.4 (VSA), U7.3 (12VOUT), U7.4 (VSA)
+3.3V: C7.2, C8.2, C54.2, C56.2, C114.2, C115.2, U1.20 (VCC_IO), U1.21 (SD_MODE), U1.22 (SPI_MODE), U2.20 (VCC_IO), U2.21 (SD_MODE), U2.22 (SPI_MODE), U3.20 (VCC_IO), U3.21 (SD_MODE), U3.22 (SPI_MODE), U5.20 (VCC_IO), U5.21 (SD_MODE), U5.22 (SPI_MODE), U6.20 (VCC_IO), U6.21 (SD_MODE), U6.22 (SPI_MODE), U7.20 (VCC_IO), U7.21 (SD_MODE), U7.22 (SPI_MODE)
D0_5VOUT: C5.2, R5.1, U1.5 (5VOUT)
D0_CA1: C26.2, U1.42 (CA1)
D0_CA2: C18.2, U1.35 (CA2)
D0_CB1: C24.2, U1.2 (CB1)
D0_CB2: C13.2, U1.43 (CB2)
D0_CPI: C22.2, U1.31 (CPO)
D0_CPO: C22.1, U1.32 (CPI)
D0_HA1: D39.4 (C), R63.1, U1.41 (HA1)
D0_HA2: D38.6 (C), R62.1, U1.36 (HA2)
D0_HAG1: D39.3 (A), Q1.12 (G4), R63.2
D0_HAG2: D38.1 (A), Q1.1 (G1), R62.2
D0_HB1: D41.4 (C), R26.1, U1.1 (HB1)
D0_HB2: D40.6 (C), R25.1, U1.44 (HB2)
D0_HBG1: D41.3 (A), Q2.12 (G4), R26.2
D0_HBG2: D40.1 (A), Q2.1 (G1), R25.2
D0_LA1: D39.6 (C), R64.1, U1.39 (LA1)
D0_LA2: D38.4 (C), R65.1, U1.38 (LA2)
D0_LAG1: D39.1 (A), Q1.9 (G3), R64.2
D0_LAG2: D38.3 (A), Q1.4 (G2), R65.2
D0_LB1: D41.6 (C), R36.1, U1.47 (LB1)
D0_LB2: D40.4 (C), R37.1, U1.46 (LB2)
D0_LBG1: D41.1 (A), Q2.9 (G3), R36.2
D0_LBG2: D40.3 (A), Q2.4 (G2), R37.2
D0_SRAG: NT5.1, R14.2
D0_SRAH: C16.2, R13.1, U1.8 (SRAH)
D0_SRAL: C16.1, R14.1, U1.7 (SRAL)
D0_SRAT: Q1.5 (S2), Q1.6 (S2), Q1.7 (S3), Q1.8 (S3), R13.2, R70.2
D0_SRBG: NT7.1, R10.2
D0_SRBH: C11.2, R9.1, U1.9 (SRBH)
D0_SRBL: C11.1, R10.1, U1.10 (SRBL)
D0_SRBT: Q2.5 (S2), Q2.6 (S2), Q2.7 (S3), Q2.8 (S3), R9.2, R75.2
D0_VCC: C9.2, R5.2, U1.29 (VCC)
D0_VCP: C20.1, U1.34 (VCP)
D1_5VOUT: C52.2, R77.1, U2.5 (5VOUT)
D1_CA1: C84.2, U2.42 (CA1)
D1_CA2: C76.2, U2.35 (CA2)
D1_CB1: C82.2, U2.2 (CB1)
D1_CB2: C67.2, U2.43 (CB2)
D1_CPI: C80.2, U2.31 (CPO)
D1_CPO: C80.1, U2.32 (CPI)
D1_HA1: D42.4 (C), R195.1, U2.41 (HA1)
D1_HA2: D43.6 (C), R194.1, U2.36 (HA2)
D1_HAG1: D42.3 (A), Q9.12 (G4), R195.2
D1_HAG2: D43.1 (A), Q9.1 (G1), R194.2
D1_HB1: D45.4 (C), R100.1, U2.1 (HB1)
D1_HB2: D44.6 (C), R99.1, U2.44 (HB2)
D1_HBG1: D45.3 (A), Q11.12 (G4), R100.2
D1_HBG2: D44.1 (A), Q11.1 (G1), R99.2
D1_LA1: D42.6 (C), R196.1, U2.39 (LA1)
D1_LA2: D43.4 (C), R197.1, U2.38 (LA2)
D1_LAG1: D42.1 (A), Q9.9 (G3), R196.2
D1_LAG2: D43.3 (A), Q9.4 (G2), R197.2
D1_LB1: D45.6 (C), R101.1, U2.47 (LB1)
D1_LB2: D44.4 (C), R189.1, U2.46 (LB2)
D1_LBG1: D45.1 (A), Q11.9 (G3), R101.2
D1_LBG2: D44.3 (A), Q11.4 (G2), R189.2
D1_SRAG: NT4.1, R96.2
D1_SRAH: C69.2, R95.1, U2.8 (SRAH)
D1_SRAL: C69.1, R96.1, U2.7 (SRAL)
D1_SRAT: Q9.5 (S2), Q9.6 (S2), Q9.7 (S3), Q9.8 (S3), R95.2, R202.2
D1_SRBG: NT3.1, R80.2
D1_SRBH: C59.2, R79.1, U2.9 (SRBH)
D1_SRBL: C59.1, R80.1, U2.10 (SRBL)
D1_SRBT: Q11.5 (S2), Q11.6 (S2), Q11.7 (S3), Q11.8 (S3), R79.2, R204.2
D1_VCC: C57.2, R77.2, U2.29 (VCC)
D1_VCP: C78.1, U2.34 (VCP)
D2_5VOUT: C112.2, R206.1, U3.5 (5VOUT)
D2_CA1: C132.2, U3.42 (CA1)
D2_CA2: C124.2, U3.35 (CA2)
D2_CB1: C130.2, U3.2 (CB1)
D2_CB2: C120.2, U3.43 (CB2)
D2_CPI: C128.2, U3.31 (CPO)
D2_CPO: C128.1, U3.32 (CPI)
D2_HA1: D47.4 (C), R225.1, U3.41 (HA1)
D2_HA2: D46.6 (C), R224.1, U3.36 (HA2)
D2_HAG1: D47.3 (A), Q10.12 (G4), R225.2
D2_HAG2: D46.1 (A), Q10.1 (G1), R224.2
D2_HB1: D49.4 (C), R217.1, U3.1 (HB1)
D2_HB2: D48.6 (C), R216.1, U3.44 (HB2)
D2_HBG1: D49.3 (A), Q12.12 (G4), R217.2
D2_HBG2: D48.1 (A), Q12.1 (G1), R216.2
D2_LA1: D47.6 (C), R226.1, U3.39 (LA1)
D2_LA2: D46.4 (C), R227.1, U3.38 (LA2)
D2_LAG1: D47.1 (A), Q10.9 (G3), R226.2
D2_LAG2: D46.3 (A), Q10.4 (G2), R227.2
D2_LB1: D49.6 (C), R218.1, U3.47 (LB1)
D2_LB2: D48.4 (C), R219.1, U3.46 (LB2)
D2_LBG1: D49.1 (A), Q12.9 (G3), R218.2
D2_LBG2: D48.3 (A), Q12.4 (G2), R219.2
D2_SRAG: NT12.1, R213.2
D2_SRAH: C122.2, R212.1, U3.8 (SRAH)
D2_SRAL: C122.1, R213.1, U3.7 (SRAL)
D2_SRAT: Q10.5 (S2), Q10.6 (S2), Q10.7 (S3), Q10.8 (S3), R212.2, R232.2
D2_SRBG: NT14.1, R209.2
D2_SRBH: C118.2, R208.1, U3.9 (SRBH)
D2_SRBL: C118.1, R209.1, U3.10 (SRBL)
D2_SRBT: Q12.5 (S2), Q12.6 (S2), Q12.7 (S3), Q12.8 (S3), R208.2, R234.2
D2_VCC: C116.2, R206.2, U3.29 (VCC)
D2_VCP: C126.1, U3.34 (VCP)
D3_5VOUT: C6.2, R6.1, U5.5 (5VOUT)
D3_CA1: C27.2, U5.42 (CA1)
D3_CA2: C19.2, U5.35 (CA2)
D3_CB1: C25.2, U5.2 (CB1)
D3_CB2: C14.2, U5.43 (CB2)
D3_CPI: C23.2, U5.31 (CPO)
D3_CPO: C23.1, U5.32 (CPI)
D3_HA1: D51.4 (C), R67.1, U5.41 (HA1)
D3_HA2: D50.6 (C), R66.1, U5.36 (HA2)
D3_HAG1: D51.3 (A), Q3.12 (G4), R67.2
D3_HAG2: D50.1 (A), Q3.1 (G1), R66.2
D3_HB1: D53.4 (C), R55.1, U5.1 (HB1)
D3_HB2: D52.6 (C), R38.1, U5.44 (HB2)
D3_HBG1: D53.3 (A), Q4.12 (G4), R55.2
D3_HBG2: D52.1 (A), Q4.1 (G1), R38.2
D3_LA1: D51.6 (C), R68.1, U5.39 (LA1)
D3_LA2: D50.4 (C), R69.1, U5.38 (LA2)
D3_LAG1: D51.1 (A), Q3.9 (G3), R68.2
D3_LAG2: D50.3 (A), Q3.4 (G2), R69.2
D3_LB1: D53.6 (C), R60.1, U5.47 (LB1)
D3_LB2: D52.4 (C), R61.1, U5.46 (LB2)
D3_LBG1: D53.1 (A), Q4.9 (G3), R60.2
D3_LBG2: D52.3 (A), Q4.4 (G2), R61.2
D3_SRAG: NT6.1, R19.2
D3_SRAH: C17.2, R15.1, U5.8 (SRAH)
D3_SRAL: C17.1, R19.1, U5.7 (SRAL)
D3_SRAT: Q3.5 (S2), Q3.6 (S2), Q3.7 (S3), Q3.8 (S3), R15.2, R71.2
D3_SRBG: NT8.1, R12.2
D3_SRBH: C12.2, R11.1, U5.9 (SRBH)
D3_SRBT: Q4.5 (S2), Q4.6 (S2), Q4.7 (S3), Q4.8 (S3), R11.2, R76.2
D3_VCC: C10.2, R6.2, U5.29 (VCC)
D3_VCP: C21.1, U5.34 (VCP)
D3__SRBL: C12.1, R12.1, U5.10 (SRBL)
D4_5VOUT: C53.2, R78.1, U6.5 (5VOUT)
D4_CA1: C85.2, U6.42 (CA1)
D4_CA2: C77.2, U6.35 (CA2)
D4_CB1: C83.2, U6.2 (CB1)
D4_CB2: C68.2, U6.43 (CB2)
D4_CPI: C81.2, U6.31 (CPO)
D4_CPO: C81.1, U6.32 (CPI)
D4_HA1: D55.4 (C), R199.1, U6.41 (HA1)
D4_HA2: D54.6 (C), R198.1, U6.36 (HA2)
D4_HAG2: D54.1 (A), Q5.1 (G1), R198.2
D4_HB1: D57.4 (C), R191.1, U6.1 (HB1)
D4_HB2: D56.6 (C), R190.1, U6.44 (HB2)
D4_HBG1: D57.3 (A), Q6.12 (G4), R191.2
D4_HBG2: D56.1 (A), Q6.1 (G1), R190.2
D4_LA1: D55.6 (C), R200.1, U6.39 (LA1)
D4_LA2: D54.4 (C), R201.1, U6.38 (LA2)
D4_LAG1: D55.1 (A), Q5.9 (G3), R200.2
D4_LAG2: D54.3 (A), Q5.4 (G2), R201.2
D4_LB1: D57.6 (C), R192.1, U6.47 (LB1)
D4_LB2: D56.4 (C), R193.1, U6.46 (LB2)
D4_LBG1: D57.1 (A), Q6.9 (G3), R192.2
D4_LBG2: D56.3 (A), Q6.4 (G2), R193.2
D4_SRAG: NT9.1, R98.2
D4_SRAH: C75.2, R97.1, U6.8 (SRAH)
D4_SRAL: C75.1, R98.1, U6.7 (SRAL)
D4_SRAT: Q5.5 (S2), Q5.6 (S2), Q5.7 (S3), Q5.8 (S3), R97.2, R203.2
D4_SRBG: NT10.1, R82.2
D4_SRBH: C60.2, R81.1, U6.9 (SRBH)
D4_SRBL: C60.1, R82.1, U6.10 (SRBL)
D4_SRBT: Q6.5 (S2), Q6.6 (S2), Q6.7 (S3), Q6.8 (S3), R81.2, R205.2
D4_VCC: C58.2, R78.2, U6.29 (VCC)
D4_VCP: C79.1, U6.34 (VCP)
D4__HAG1: D55.3 (A), Q5.12 (G4), R199.2
D5_5VOUT: C113.2, R207.1, U7.5 (5VOUT)
D5_CA1: C133.2, U7.42 (CA1)
D5_CA2: C125.2, U7.35 (CA2)
D5_CB1: C131.2, U7.2 (CB1)
D5_CB2: C121.2, U7.43 (CB2)
D5_CPI: C129.2, U7.31 (CPO)
D5_CPO: C129.1, U7.32 (CPI)
D5_HA1: D59.4 (C), R229.1, U7.41 (HA1)
D5_HA2: D58.6 (C), R228.1, U7.36 (HA2)
D5_HAG1: D59.3 (A), Q7.12 (G4), R229.2
D5_HAG2: D58.1 (A), Q7.1 (G1), R228.2
D5_HB1: D61.4 (C), R221.1, U7.1 (HB1)
D5_HB2: D60.6 (C), R220.1, U7.44 (HB2)
D5_HBG1: D61.3 (A), Q8.12 (G4), R221.2
D5_HBG2: D60.1 (A), Q8.1 (G1), R220.2
D5_LA1: D59.6 (C), R230.1, U7.39 (LA1)
D5_LA2: D58.4 (C), R231.1, U7.38 (LA2)
D5_LAG1: D59.1 (A), Q7.9 (G3), R230.2
D5_LAG2: D58.3 (A), Q7.4 (G2), R231.2
D5_LB1: D61.6 (C), R222.1, U7.47 (LB1)
D5_LB2: D60.4 (C), R223.1, U7.46 (LB2)
D5_LBG1: D61.1 (A), Q8.9 (G3), R222.2
D5_LBG2: D60.3 (A), Q8.4 (G2), R223.2
D5_SRAG: NT11.1, R215.2
D5_SRAH: C123.2, R214.1, U7.8 (SRAH)
D5_SRAL: C123.1, R215.1, U7.7 (SRAL)
D5_SRAT: Q7.5 (S2), Q7.6 (S2), Q7.7 (S3), Q7.8 (S3), R214.2, R233.2
D5_SRBG: NT13.1, R211.2
D5_SRBH: C119.2, R210.1, U7.9 (SRBH)
D5_SRBL: C119.1, R211.1, U7.10 (SRBL)
D5_SRBT: Q8.5 (S2), Q8.6 (S2), Q8.7 (S3), Q8.8 (S3), R210.2, R235.2
D5_VCC: C117.2, R207.2, U7.29 (VCC)
D5_VCP: C127.1, U7.34 (VCP)
DRIVER_0_A1: C26.1, C41.2, Q1.10 (S4/D3), Q1.15 (S4/D3), U1.40 (BMA1)
DRIVER_0_A2: C18.1, C40.2, Q1.3 (S1/D2), Q1.13 (S1/D2), U1.37 (BMA2)
DRIVER_0_B1: C24.1, C44.2, Q2.10 (S4/D3), Q2.15 (S4/D3), U1.48 (BMB1)
DRIVER_0_B2: C13.1, C42.2, Q2.3 (S1/D2), Q2.13 (S1/D2), U1.45 (BMB2)
DRIVER_0_DIAG0: U1.26 (DIAG0_SWN)
DRIVER_0_DIR: U1.18 (REFR_DIR)
DRIVER_0_SDO: U1.16 (SDO_CFG0), U2.15 (SDI_CFG1)
DRIVER_0_STEP: U1.17 (REFL_STEP)
DRIVER_1_A1: C84.1, C103.2, Q9.10 (S4/D3), Q9.15 (S4/D3), U2.40 (BMA1)
DRIVER_1_A2: C76.1, C102.2, Q9.3 (S1/D2), Q9.13 (S1/D2), U2.37 (BMA2)
DRIVER_1_B1: C82.1, C105.2, Q11.10 (S4/D3), Q11.15 (S4/D3), U2.48 (BMB1)
DRIVER_1_B2: C67.1, C104.2, Q11.3 (S1/D2), Q11.13 (S1/D2), U2.45 (BMB2)
DRIVER_1_DIAG0: U2.26 (DIAG0_SWN)
DRIVER_1_DIR: U2.18 (REFR_DIR)
DRIVER_1_SDO: U2.16 (SDO_CFG0), U3.15 (SDI_CFG1)
DRIVER_1_STEP: U2.17 (REFL_STEP)
DRIVER_2_A1: C132.1, C218.2, Q10.10 (S4/D3), Q10.15 (S4/D3), U3.40 (BMA1)
DRIVER_2_A2: C124.1, C217.2, Q10.3 (S1/D2), Q10.13 (S1/D2), U3.37 (BMA2)
DRIVER_2_B1: C130.1, C220.2, Q12.10 (S4/D3), Q12.15 (S4/D3), U3.48 (BMB1)
DRIVER_2_B2: C120.1, C219.2, Q12.3 (S1/D2), Q12.13 (S1/D2), U3.45 (BMB2)
DRIVER_2_DIAG0: U3.26 (DIAG0_SWN)
DRIVER_2_DIR: U3.18 (REFR_DIR)
DRIVER_2_SDO: U3.16 (SDO_CFG0), U5.15 (SDI_CFG1)
DRIVER_2_STEP: U3.17 (REFL_STEP)
DRIVER_3_A1: C27.1, C46.2, Q3.10 (S4/D3), Q3.15 (S4/D3), U5.40 (BMA1)
DRIVER_3_A2: C19.1, C45.2, Q3.3 (S1/D2), Q3.13 (S1/D2), U5.37 (BMA2)
DRIVER_3_B1: C25.1, C48.2, Q4.10 (S4/D3), Q4.15 (S4/D3), U5.48 (BMB1)
DRIVER_3_B2: C14.1, C47.2, Q4.3 (S1/D2), Q4.13 (S1/D2), U5.45 (BMB2)
DRIVER_3_DIAG0: U5.26 (DIAG0_SWN)
DRIVER_3_DIR: U5.18 (REFR_DIR)
DRIVER_3_SDO: U5.16 (SDO_CFG0), U6.15 (SDI_CFG1)
DRIVER_3_STEP: U5.17 (REFL_STEP)
DRIVER_4_A1: C85.1, C107.2, Q5.10 (S4/D3), Q5.15 (S4/D3), U6.40 (BMA1)
DRIVER_4_A2: C77.1, C106.2, Q5.3 (S1/D2), Q5.13 (S1/D2), U6.37 (BMA2)
DRIVER_4_B1: C83.1, C109.2, Q6.10 (S4/D3), Q6.15 (S4/D3), U6.48 (BMB1)
DRIVER_4_B2: C68.1, C108.2, Q6.3 (S1/D2), Q6.13 (S1/D2), U6.45 (BMB2)
DRIVER_4_DIAG0: U6.26 (DIAG0_SWN)
DRIVER_4_DIR: U6.18 (REFR_DIR)
DRIVER_4_SDO: U6.16 (SDO_CFG0), U7.15 (SDI_CFG1)
DRIVER_4_STEP: U6.17 (REFL_STEP)
DRIVER_5_A1: C133.1, C222.2, Q7.10 (S4/D3), Q7.15 (S4/D3), U7.40 (BMA1)
DRIVER_5_A2: C125.1, C221.2, Q7.3 (S1/D2), Q7.13 (S1/D2), U7.37 (BMA2)
DRIVER_5_B1: C131.1, C224.2, Q8.10 (S4/D3), Q8.15 (S4/D3), U7.48 (BMB1)
DRIVER_5_B2: C121.1, C223.2, Q8.3 (S1/D2), Q8.13 (S1/D2), U7.45 (BMB2)
DRIVER_5_DIAG0: U7.26 (DIAG0_SWN)
DRIVER_5_DIR: U7.18 (REFR_DIR)
DRIVER_5_STEP: U7.17 (REFL_STEP)
DRIVER_CS: U1.13 (CSN_CFG3), U2.13 (CSN_CFG3), U3.13 (CSN_CFG3), U5.13 (CSN_CFG3), U6.13 (CSN_CFG3), U7.13 (CSN_CFG3)
DRIVER_ENN: U1.28 (DRV_ENN), U2.28 (DRV_ENN), U3.28 (DRV_ENN), U5.28 (DRV_ENN), U6.28 (DRV_ENN), U7.28 (DRV_ENN)
GND: C2.1, C4.1, C5.1, C6.1, C7.1, C8.1, C9.1, C10.1, C28.2, C29.2, C30.2, C31.2, C32.1, C33.1, C34.1, C35.1, C36.1, C37.1, C38.1, C39.1, C40.1, C41.1, C42.1, C44.1, C45.1, C46.1, C47.1, C48.1, C49.1, C50.1, C52.1, C53.1, C54.1, C56.1, C57.1, C58.1, C87.2, C91.2, C92.2, C93.2, C94.1, C95.1, C96.1, C97.1, C98.1, C99.1, C100.1, C101.1, C102.1, C103.1, C104.1, C105.1, C106.1, C107.1, C108.1, C109.1, C110.1, C111.1, C112.1, C113.1, C114.1, C115.1, C116.1, C117.1, C134.2, C135.2, C207.2, C208.2, C209.1, C210.1, C211.1, C212.1, C213.1, C214.1, C215.1, C216.1, C217.1, C218.1, C219.1, C220.1, C221.1, C222.1, C223.1, C224.1, NT3.2, NT4.2, NT5.2, NT6.2, NT7.2, NT8.2, NT9.2, NT10.2, NT11.2, NT12.2, NT13.2, NT14.2, R70.1, R71.1, R75.1, R76.1, R202.1, R203.1, R204.1, R205.1, R232.1, R233.1, R234.1, R235.1, U1.6 (GNDA), U1.11 (TST_MODE), U1.12 (CLK), U1.19 (GNDD), U1.23 (ENCB_DCEN_CFG4), U1.24 (ENCA_DCIN_CFG5), U1.30 (GNDD), U1.EPAD, U2.6 (GNDA), U2.11 (TST_MODE), U2.12 (CLK), U2.19 (GNDD), U2.23 (ENCB_DCEN_CFG4), U2.24 (ENCA_DCIN_CFG5), U2.30 (GNDD), U2.EPAD, U3.6 (GNDA), U3.11 (TST_MODE), U3.12 (CLK), U3.19 (GNDD), U3.23 (ENCB_DCEN_CFG4), U3.24 (ENCA_DCIN_CFG5), U3.30 (GNDD), U3.EPAD, U5.6 (GNDA), U5.11 (TST_MODE), U5.12 (CLK), U5.19 (GNDD), U5.23 (ENCB_DCEN_CFG4), U5.24 (ENCA_DCIN_CFG5), U5.30 (GNDD), U5.EPAD, U6.6 (GNDA), U6.11 (TST_MODE), U6.12 (CLK), U6.19 (GNDD), U6.23 (ENCB_DCEN_CFG4), U6.24 (ENCA_DCIN_CFG5), U6.30 (GNDD), U6.EPAD, U7.6 (GNDA), U7.11 (TST_MODE), U7.12 (CLK), U7.19 (GNDD), U7.23 (ENCB_DCEN_CFG4), U7.24 (ENCA_DCIN_CFG5), U7.30 (GNDD), U7.EPAD
RXD1: U7.16 (SDO_CFG0)
SCK1: U1.14 (SCK_CFG2), U2.14 (SCK_CFG2), U3.14 (SCK_CFG2), U5.14 (SCK_CFG2), U6.14 (SCK_CFG2), U7.14 (SCK_CFG2)
TXD1: U1.15 (SDI_CFG1)
V_FUSED: C20.2, C21.2, C28.1, C29.1, C30.1, C31.1, C32.2, C33.2, C34.2, C35.2, C36.2, C37.2, C38.2, C39.2, C78.2, C79.2, C87.1, C91.1, C92.1, C93.1, C94.2, C95.2, C96.2, C97.2, C98.2, C99.2, C100.2, C101.2, C126.2, C127.2, C134.1, C135.1, C207.1, C208.1, C209.2, C210.2, C211.2, C212.2, C213.2, C214.2, C215.2, C216.2, Q1.2 (D1/D4), Q1.11 (D1/D4), Q1.14 (D1/D4), Q2.2 (D1/D4), Q2.11 (D1/D4), Q2.14 (D1/D4), Q3.2 (D1/D4), Q3.11 (D1/D4), Q3.14 (D1/D4), Q4.2 (D1/D4), Q4.11 (D1/D4), Q4.14 (D1/D4), Q5.2 (D1/D4), Q5.11 (D1/D4), Q5.14 (D1/D4), Q6.2 (D1/D4), Q6.11 (D1/D4), Q6.14 (D1/D4), Q7.2 (D1/D4), Q7.11 (D1/D4), Q7.14 (D1/D4), Q8.2 (D1/D4), Q8.11 (D1/D4), Q8.14 (D1/D4), Q9.2 (D1/D4), Q9.11 (D1/D4), Q9.14 (D1/D4), Q10.2 (D1/D4), Q10.11 (D1/D4), Q10.14 (D1/D4), Q11.2 (D1/D4), Q11.11 (D1/D4), Q11.14 (D1/D4), Q12.2 (D1/D4), Q12.11 (D1/D4), Q12.14 (D1/D4), U1.33 (VS), U2.33 (VS), U3.33 (VS), U5.33 (VS), U6.33 (VS), U7.33 (VS)

Notes on the sheet:
Driver 2
Driver 0
Driver 4
Driver 1
Driver 5
Driver 3
