Duet3D/Duet3-Mainboard-6HC/(commit log)

2020-02-28 Added 0.6 and 1.0 schematics and step files
2020-02-28 added v0.5 schematic
2020-06-17 Added wiring & dimension svgs
2020-11-08 Update Duet3_MB.step
    Corrected the step model of the SD card slot used
2020-11-23 Added KiCAD project
    [Comms.sch, Duet3_MB.sch, Endstops.sch, Headers.sch, Htr_Fan.sch, Power.sch, Processor.sch, Stepper_Drv.sch]
2021-04-06 BAT40V symbol link changed
    [Comms.sch, Duet3_MB.sch, Endstops.sch, Headers.sch, Htr_Fan.sch, Power.sch, Processor.sch, Stepper_Drv.sch]
2022-12-13 Updated directory naming structure
    there are more mainboards than just the 6HC now
    [Comms.sch, Duet3_MB.sch, Endstops.sch, Headers.sch, Htr_Fan.sch, Power.sch, Processor.sch, Stepper_Drv.sch]
2022-12-13 6HC v1.02 Schematic, Step and iBom added
2023-09-28 v1.02 CAD
    [Comms.kicad_sch, Duet3_MB_6HC.kicad_sch, Endstops.kicad_sch, Headers.kicad_sch, Htr_Fan.kicad_sch, Power.kicad_sch, Processor.kicad_sch, Stepper_Drv.kicad_sch]
